brad-jones/polaris/README.md

# polaris
Modern Day 3D Printed Polaris RC Float Plane
