brad-jones/polaris/references/original-design/Polaris Parts Templates (Scaled 150 Tiled).pdf

Sand to beveled edge

V
e
r
tic

al t

ail b

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
upper piece

Rudder

Vertical tail

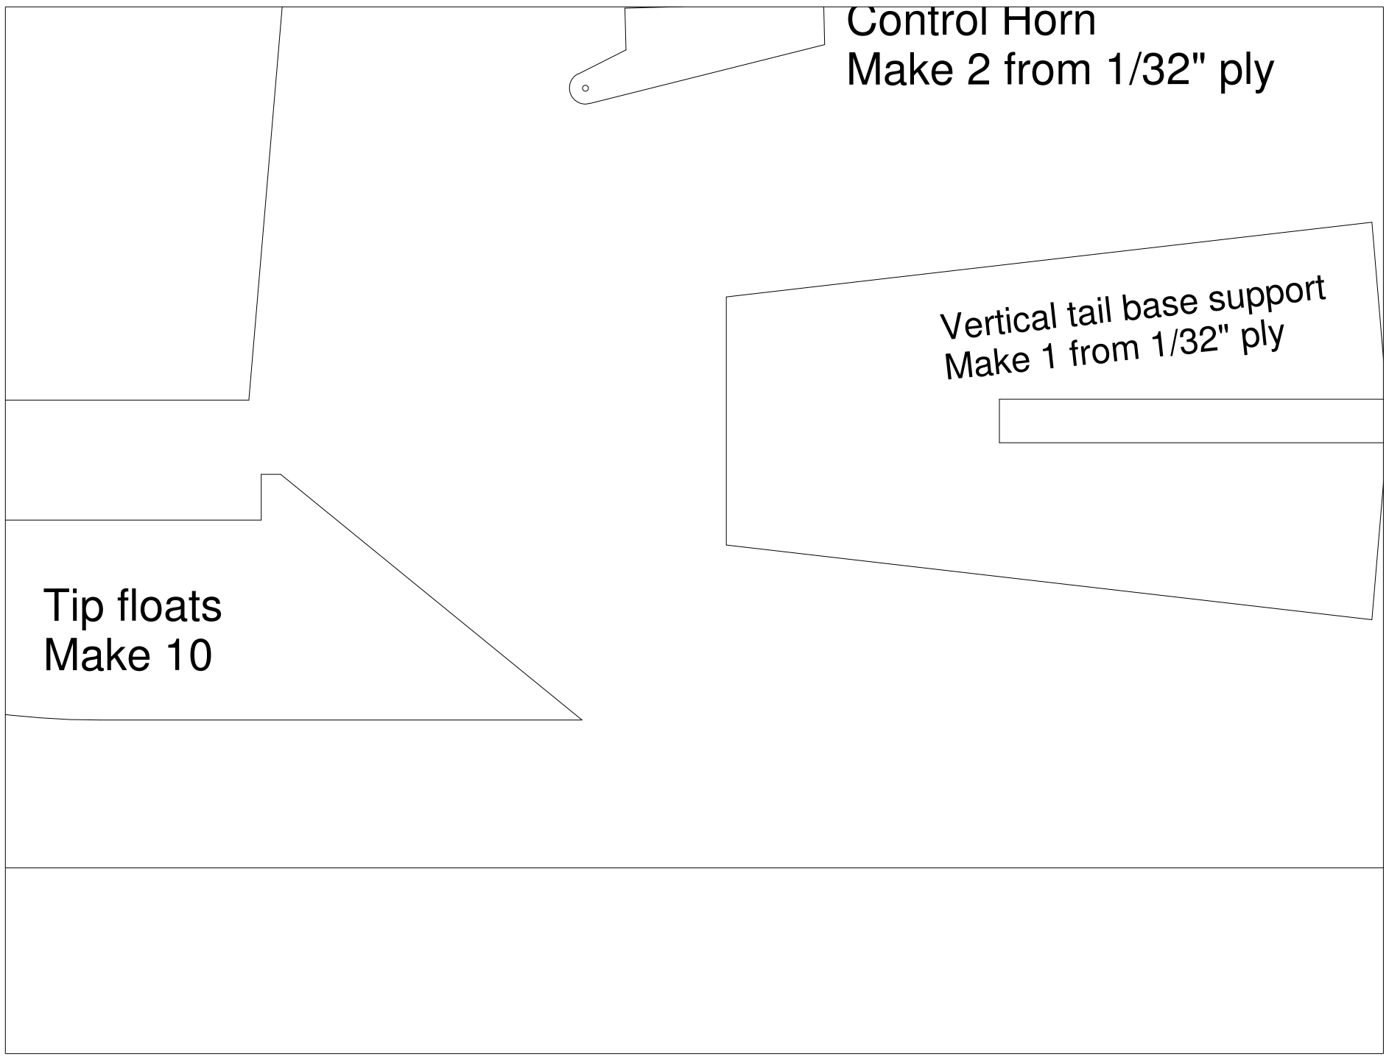
[picture p1: figure]
Control Horn Make 2 from 1/32" ply; Tip floats Make 10; Vertical tail base support Make 1 from 1/32" ply

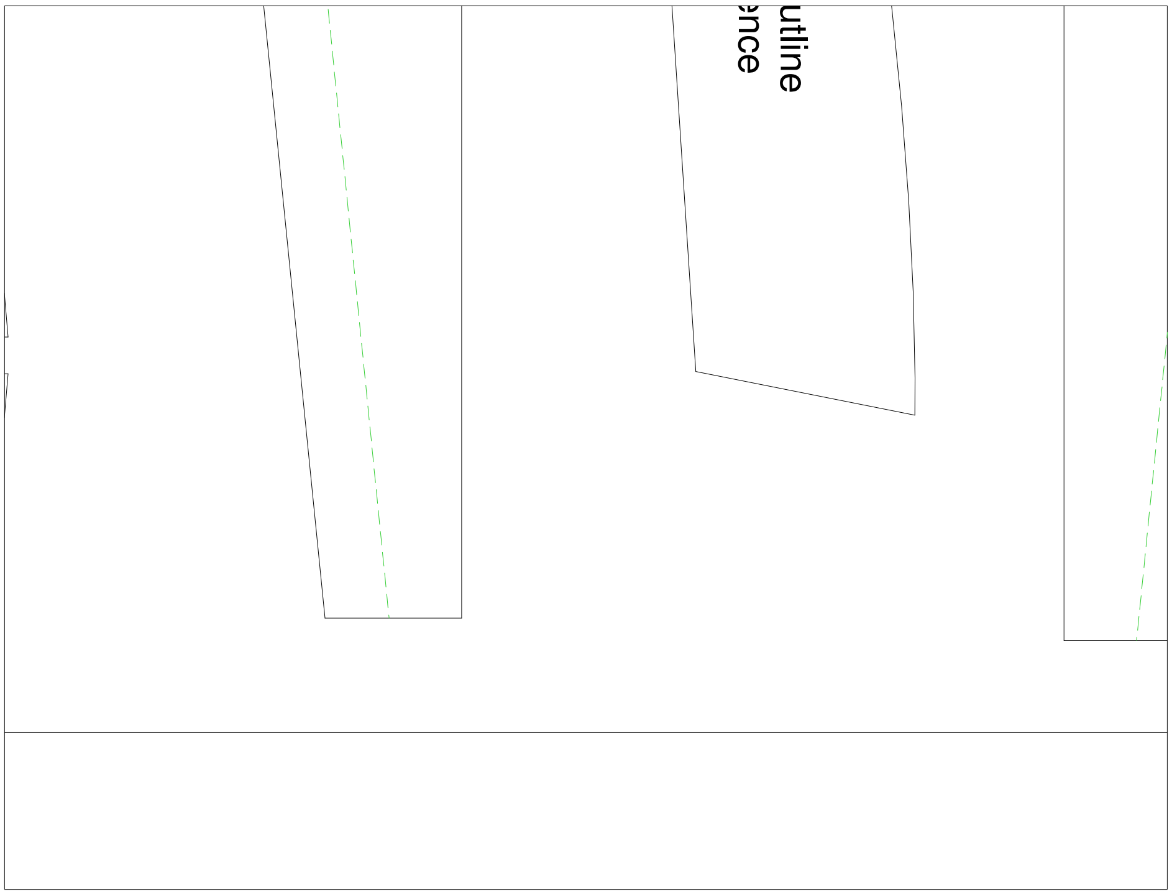
[picture p2: figure]
utline; ence

## Designed by Steve Shumate

### All parts made from 6 mm Depron or BlueCore foam unless otherwise specified

### Copyright © 2008 All Rights Reserved

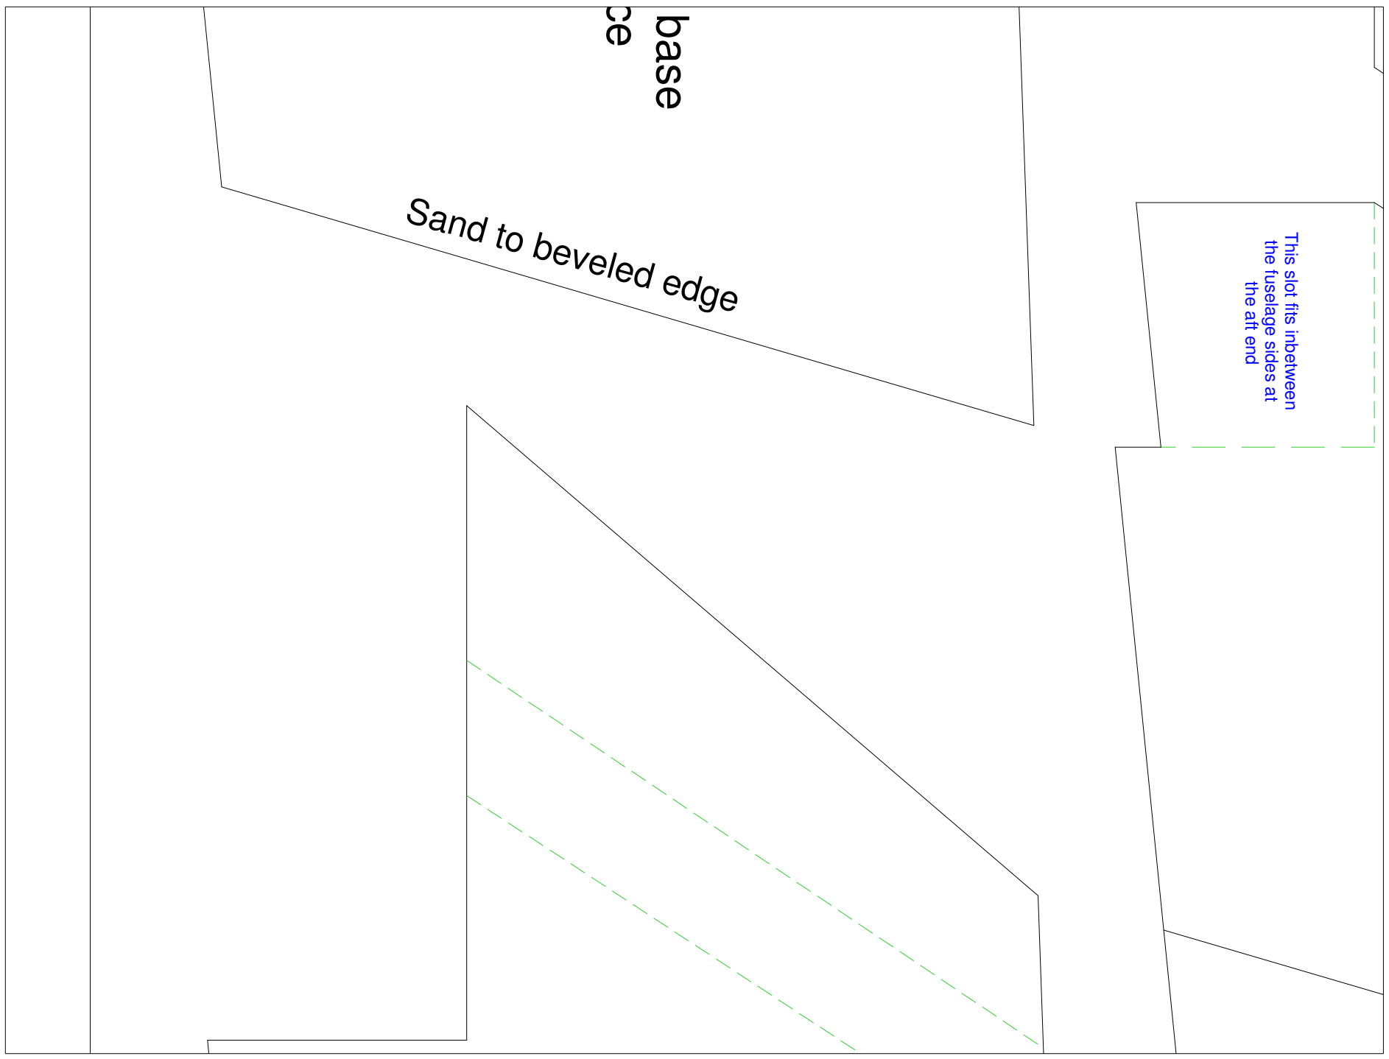
[picture p3: figure]
T his; slo; fit s in; f u s ela; sid; Sand to beveled edge

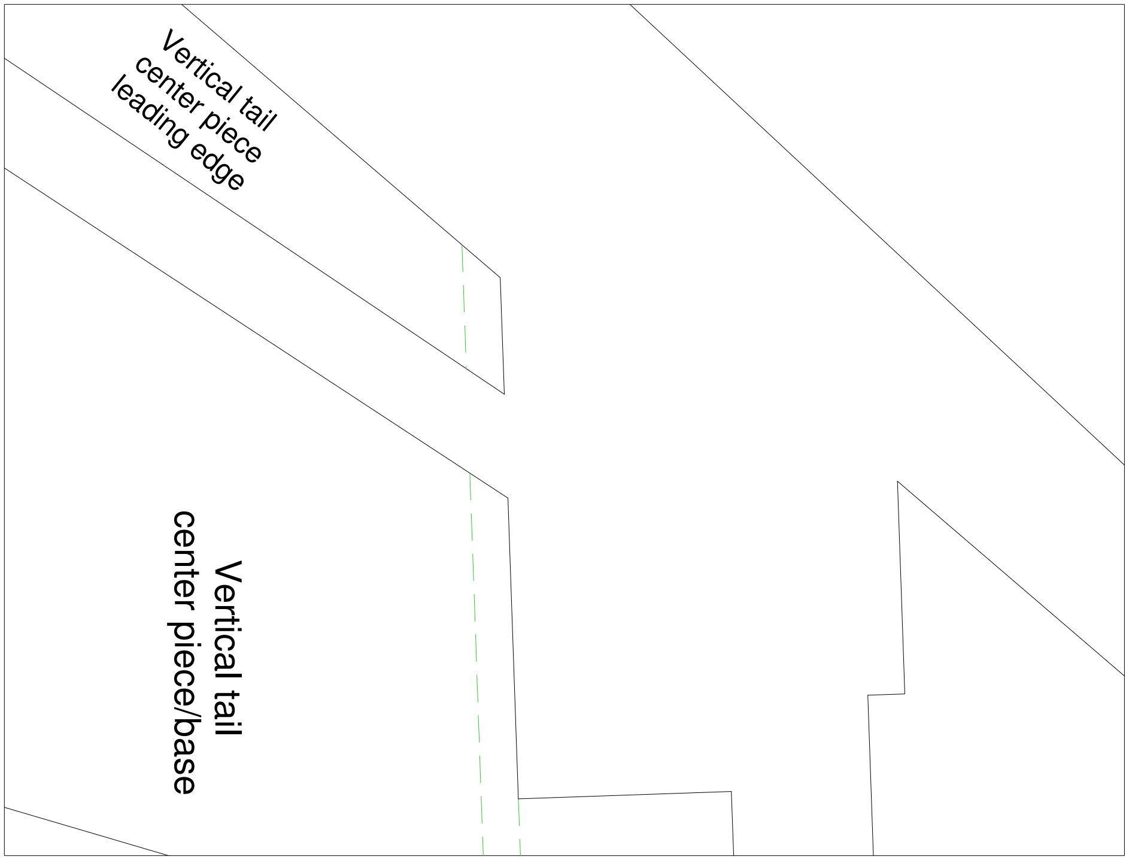
[picture p4: figure]
r tic; ail center piece/b; Vertical tail center piece leading edge
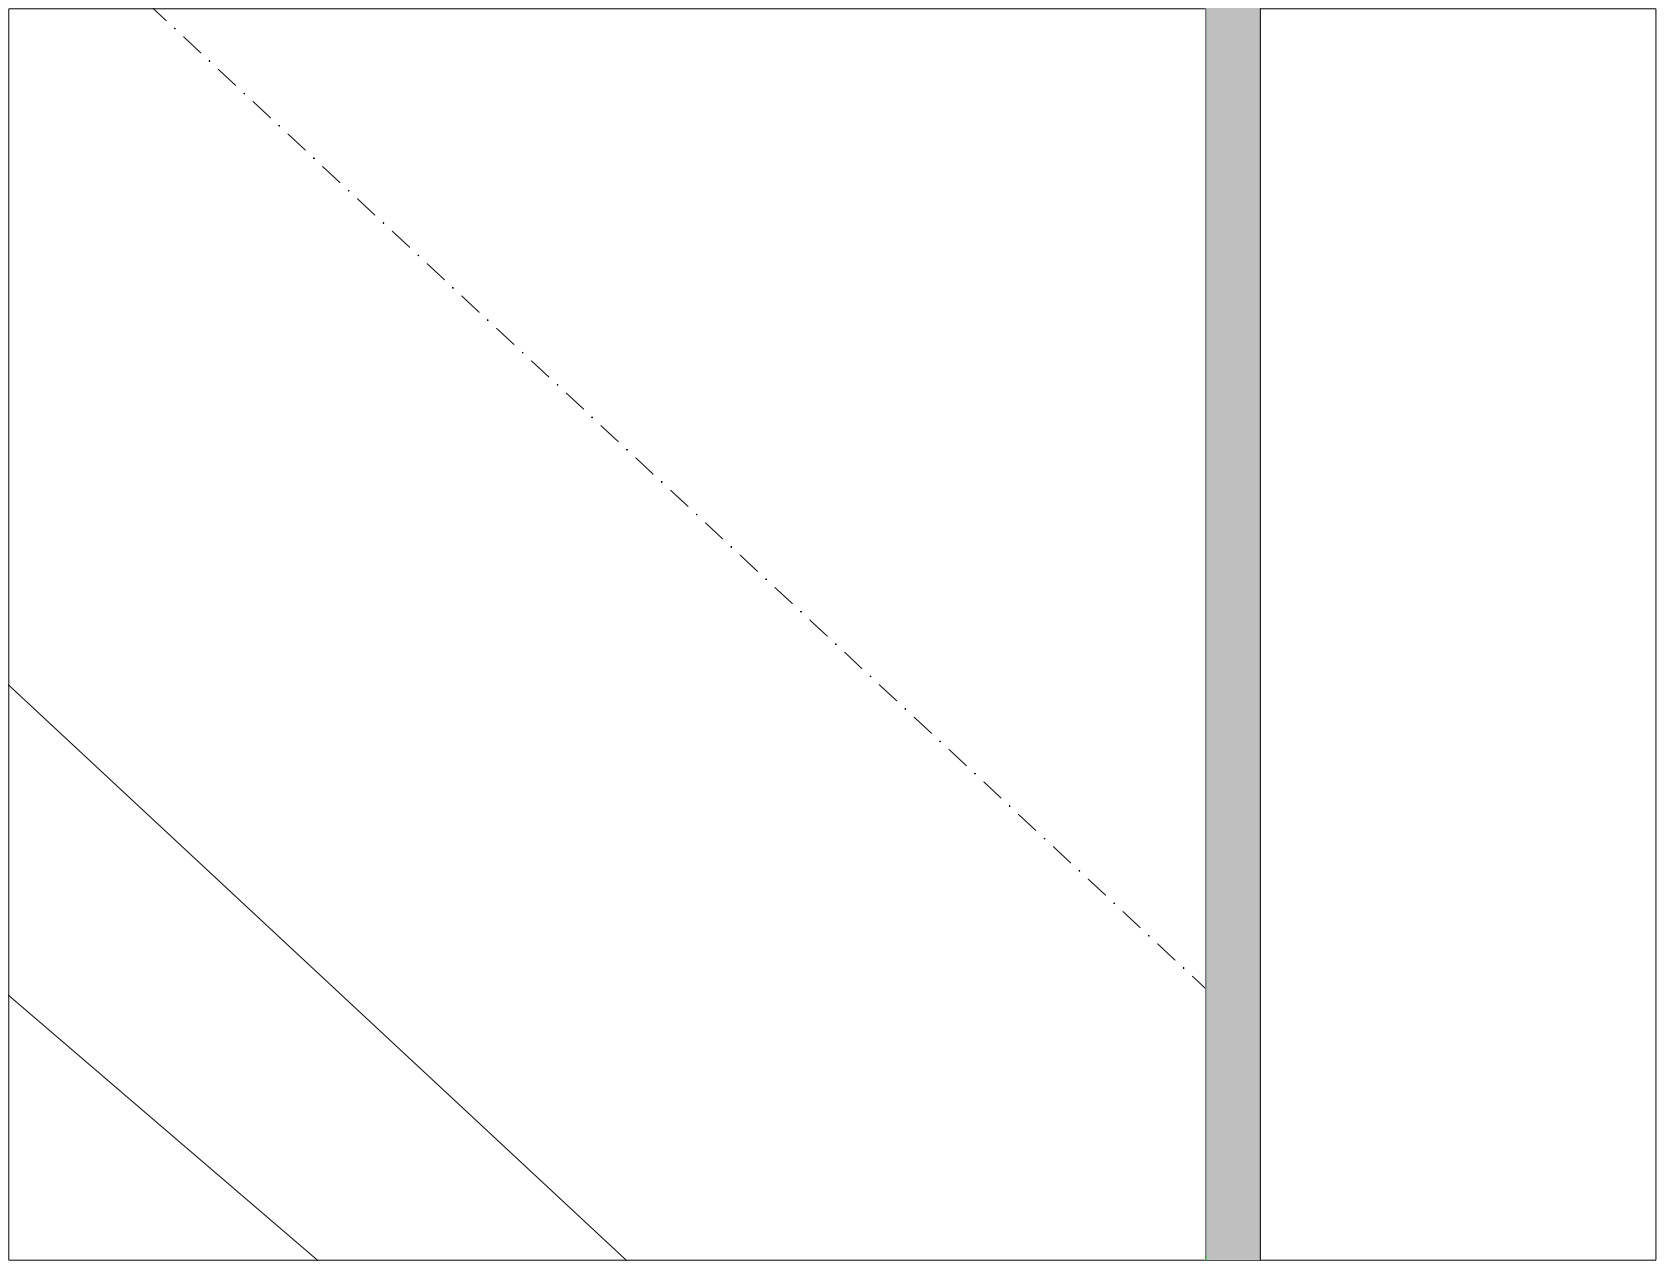
[picture p5: page 9]

Sand to beveled edge

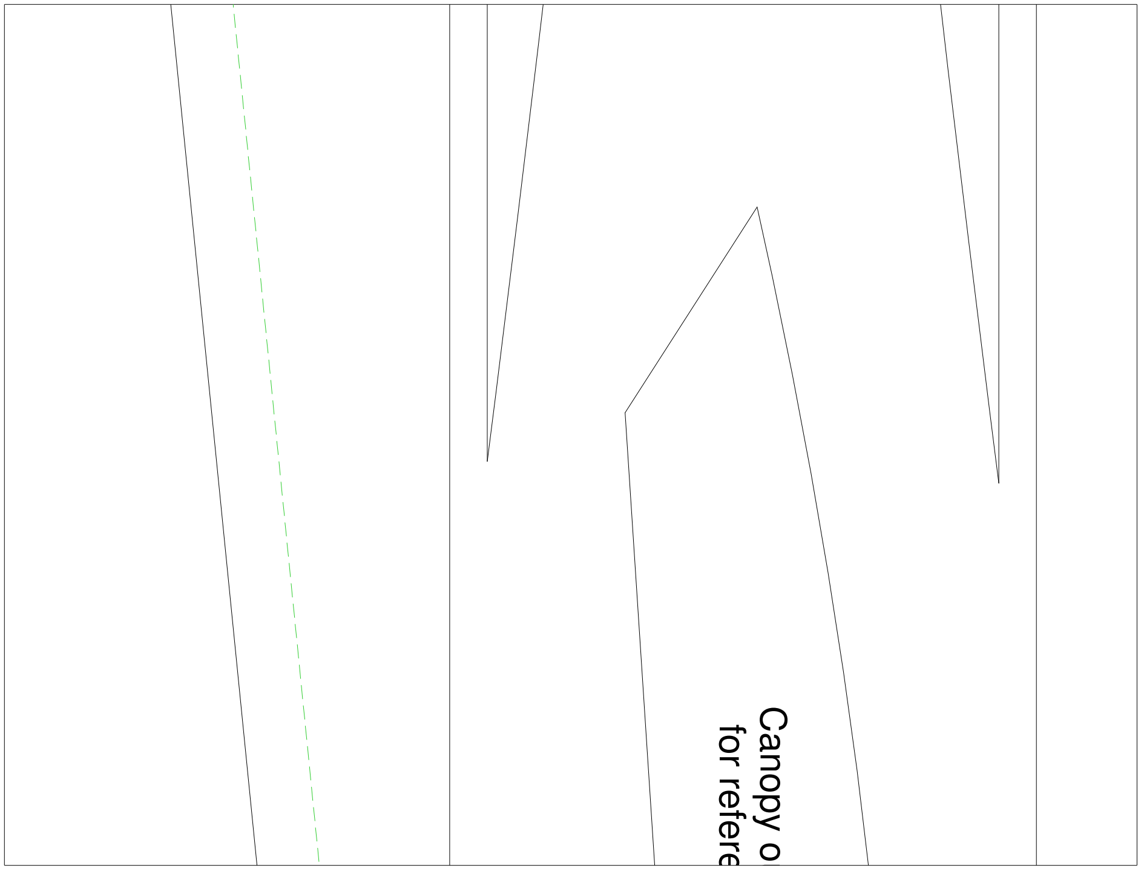
[picture p6: figure]
Canopy o for refere

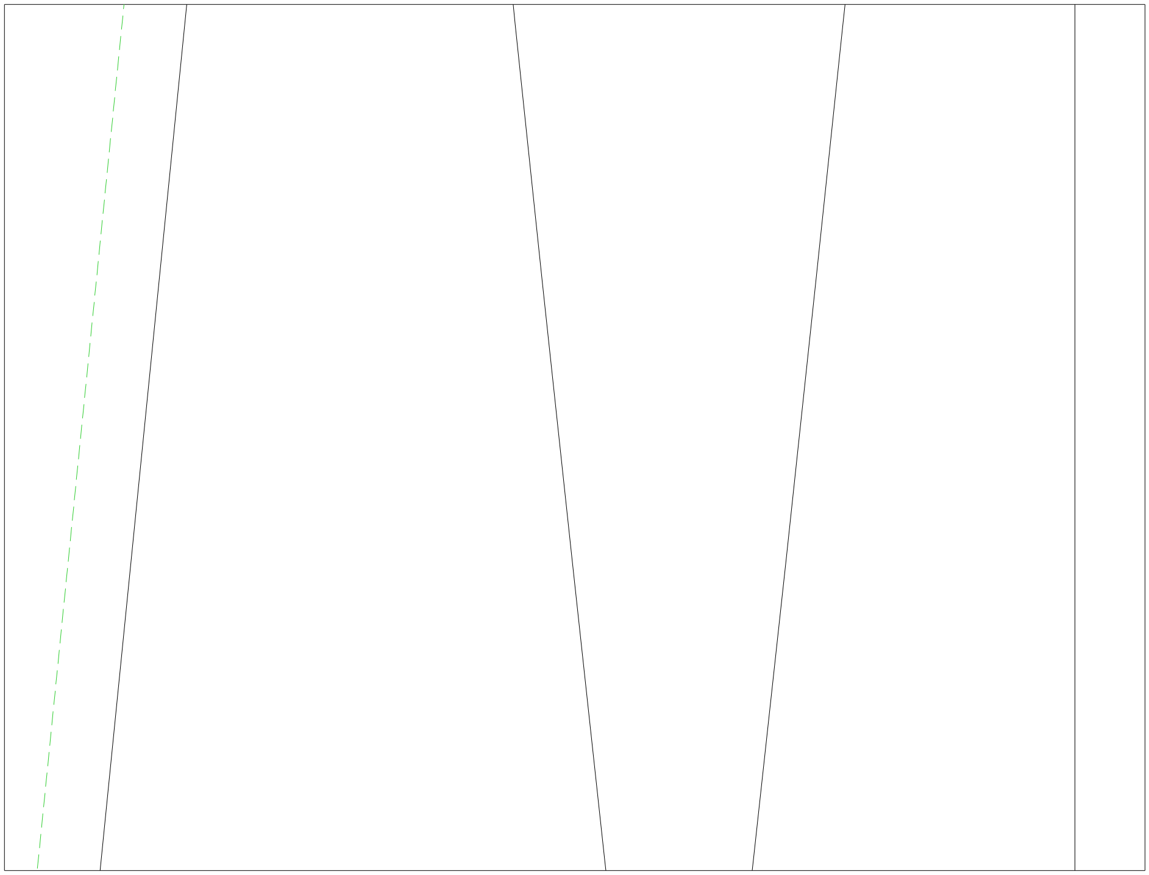
[picture p7: figure]

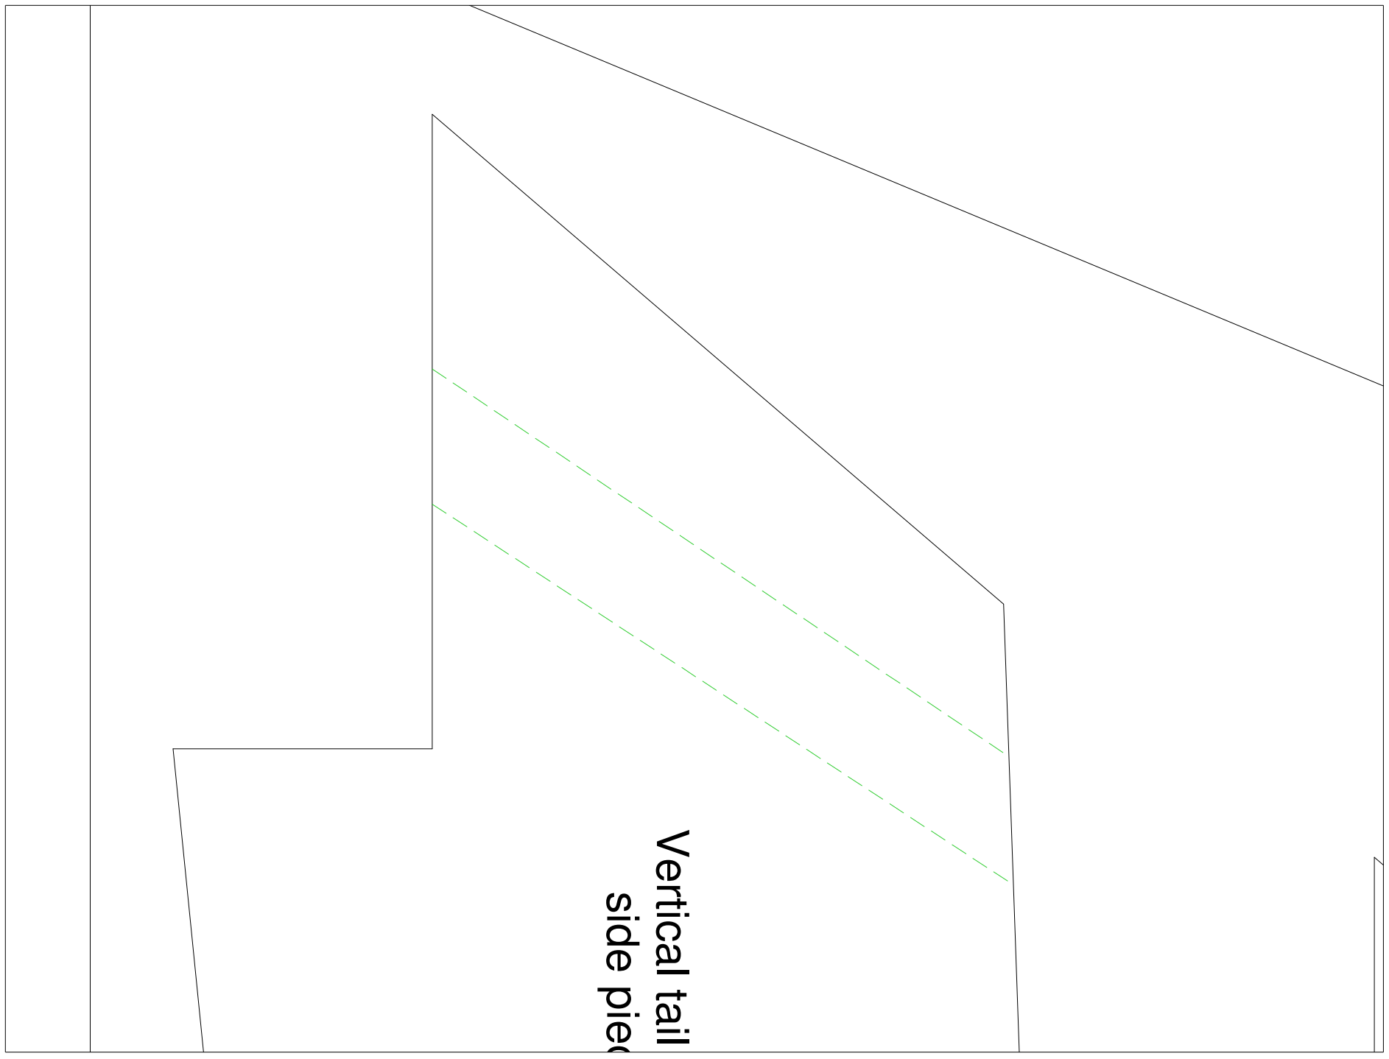
[picture p8: figure]
Vertical tail side piec

2

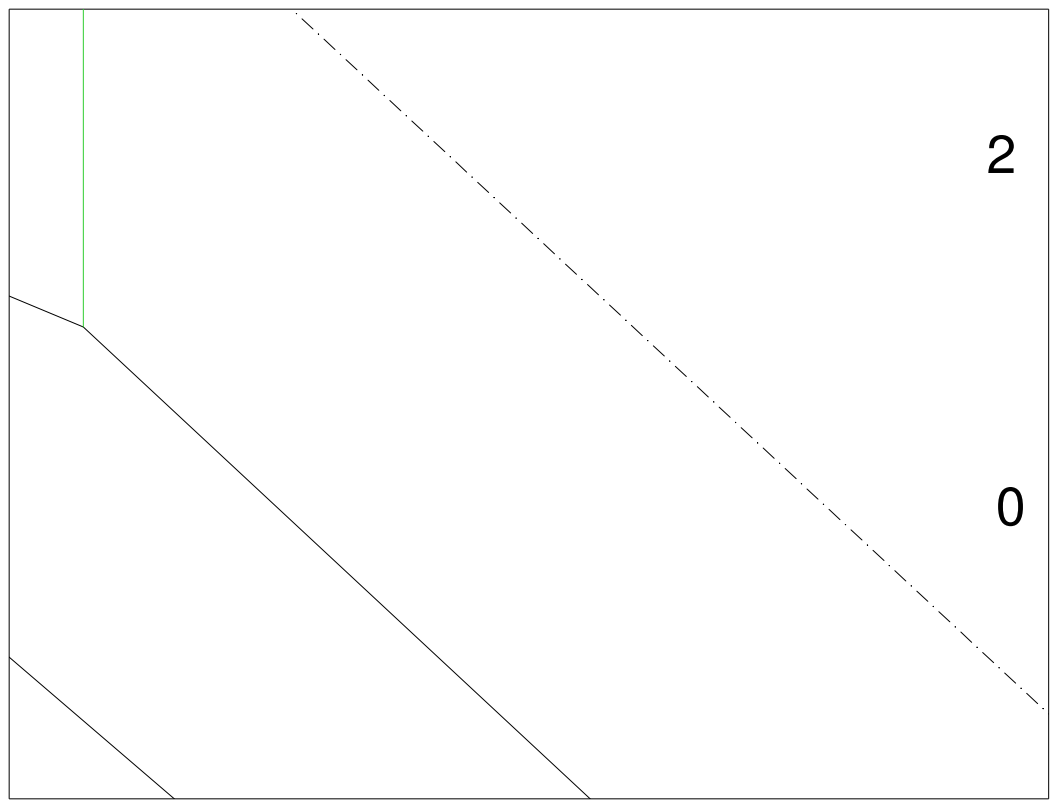
[picture p9: page 14]

## Scale in inches

2 | 4

Aileron

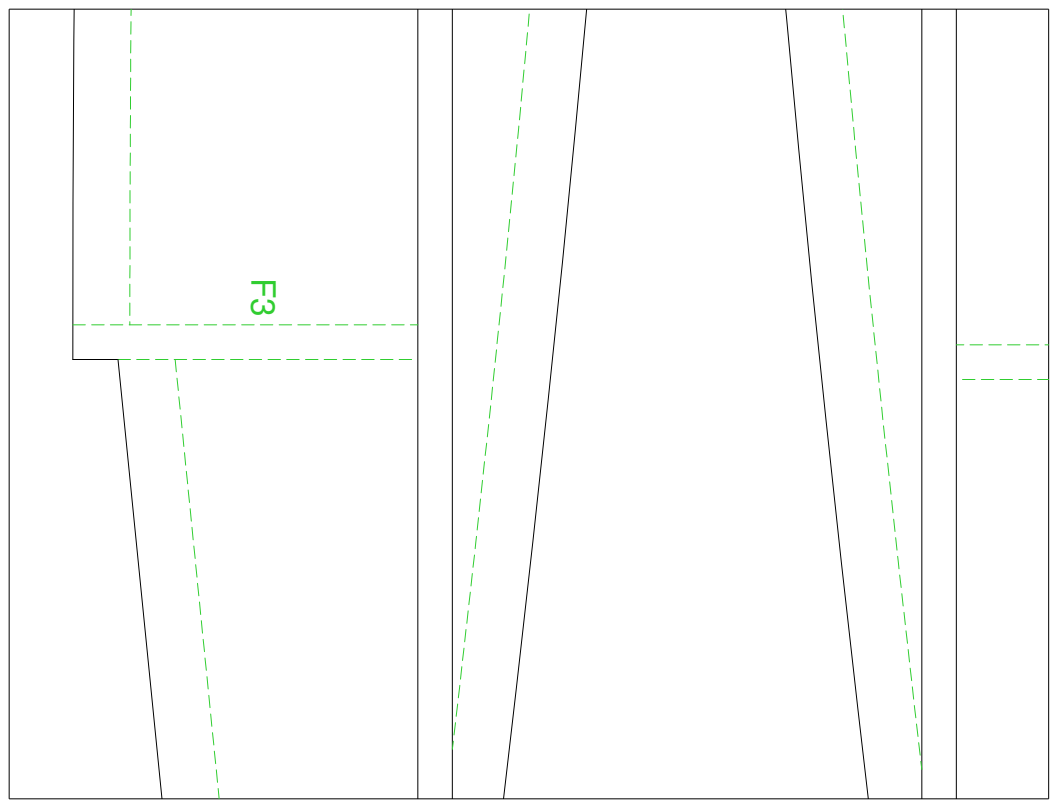
[picture p10: page 17]

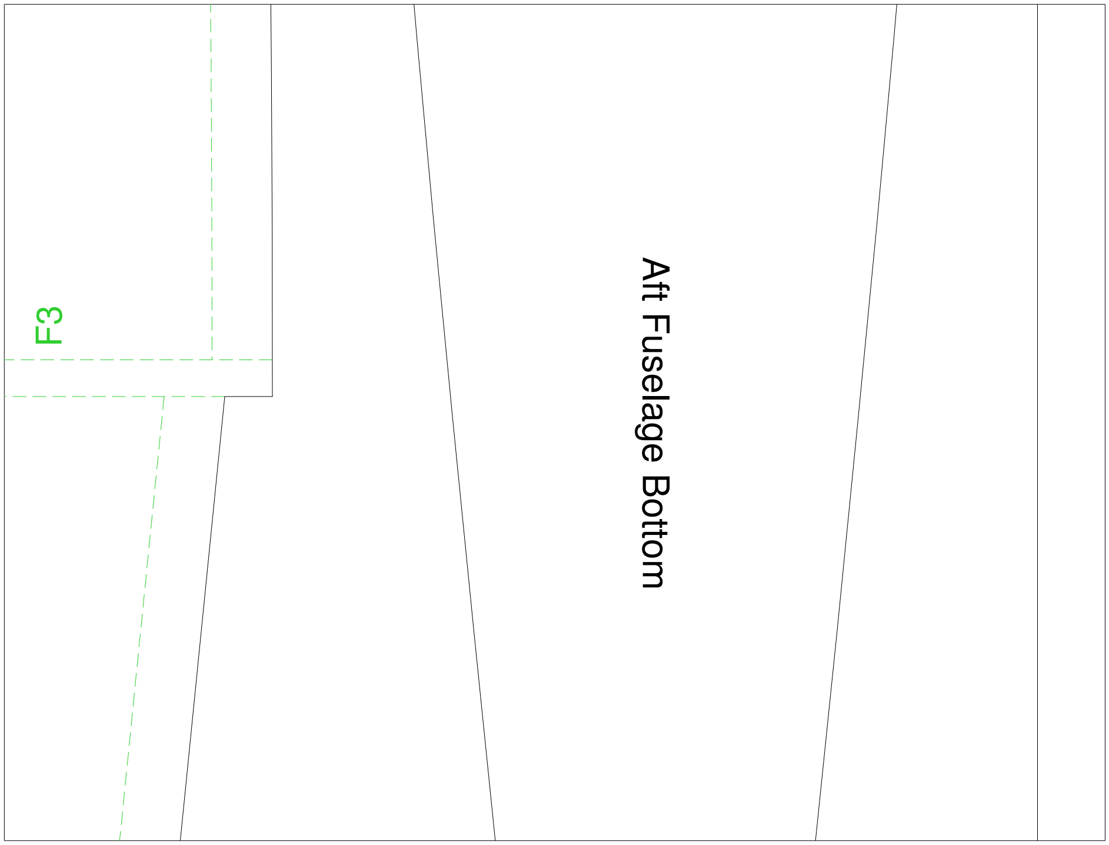
[picture p11: figure]
Aft Fuselage Bottom

O

p

tio

n

al s

plic
u

sin

g le

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
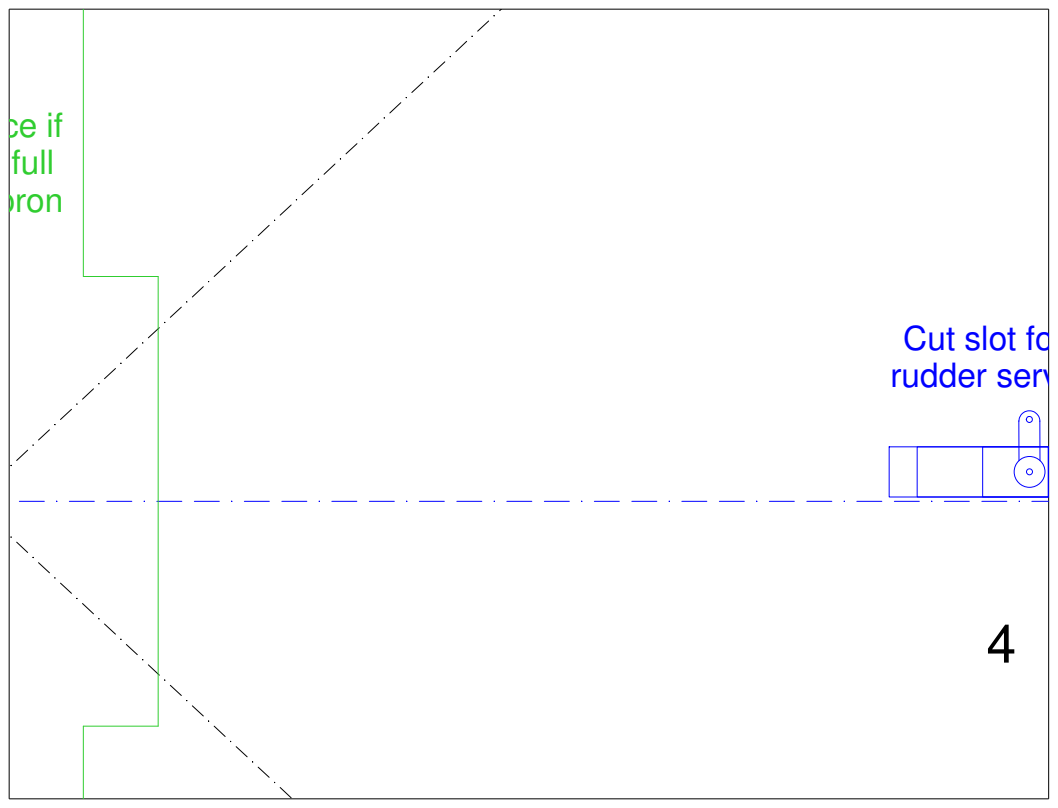
[picture p12: page 20]
lice if n full pron

Cut slot fo
rudder serv

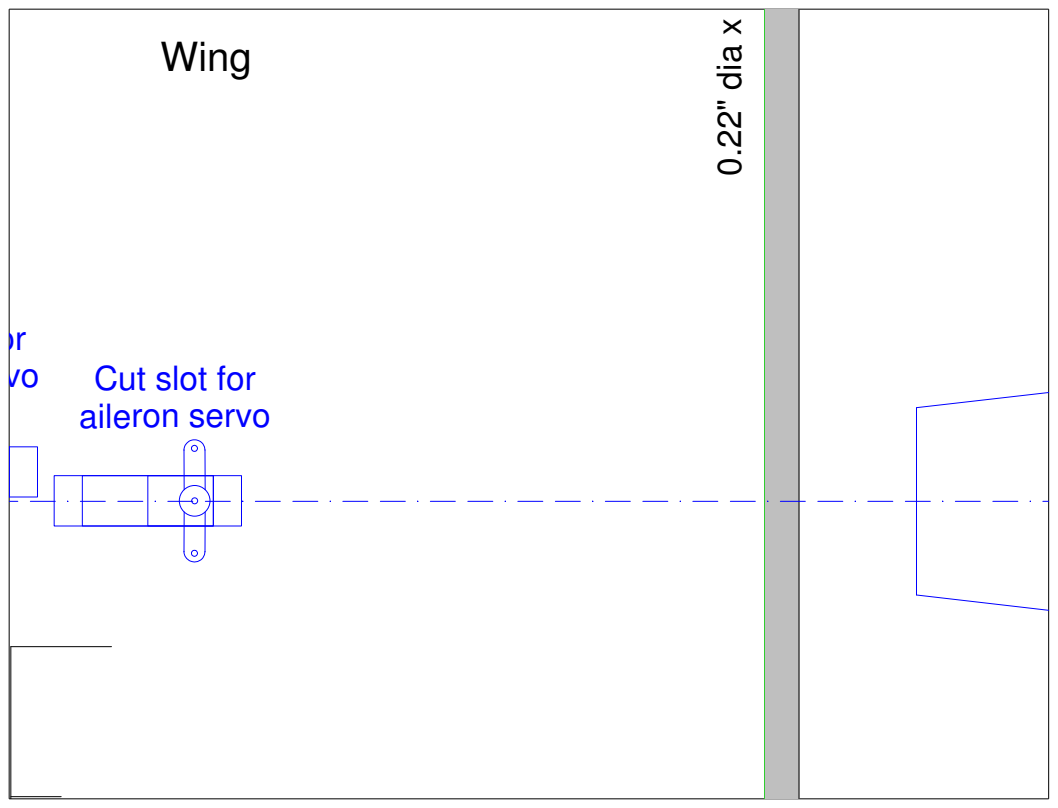
[picture p13: page 21]
0.22" dia x; slo; aile; Win

Fuselage Top

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
al t

ail b
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
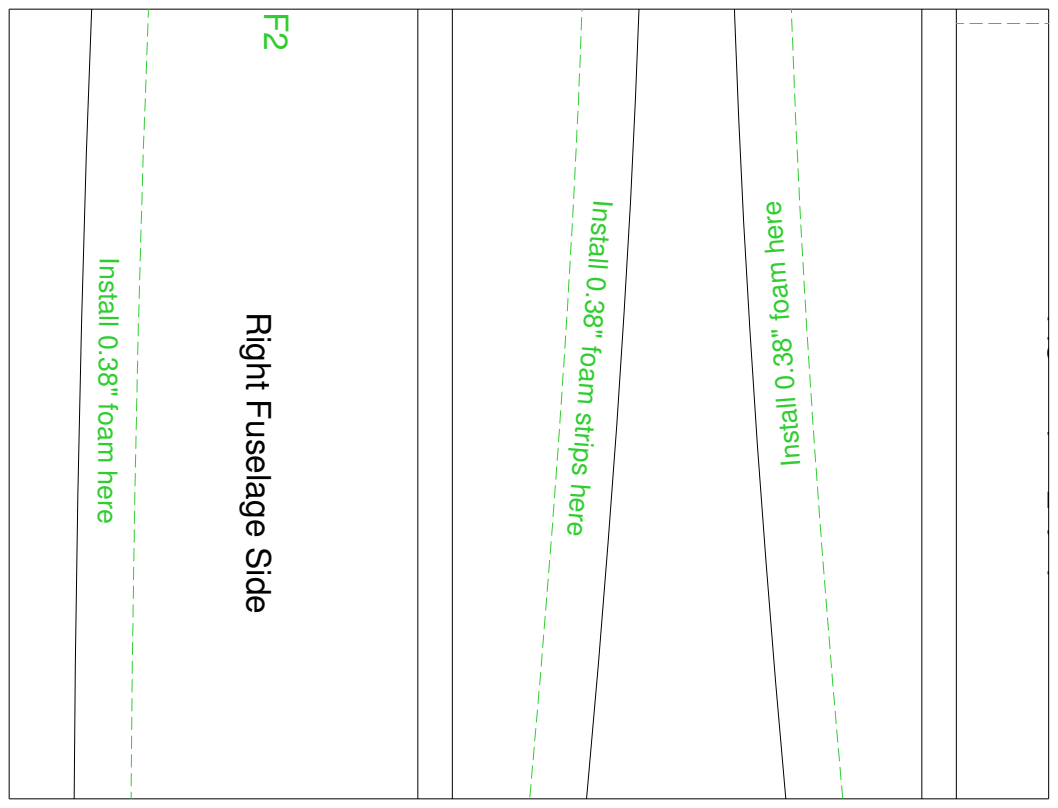
[picture p14: page 23]

Install 0.38" of am str pi s here

Install 0 3. 8" of am here

Ins at ll 0.38" foam here

Left Fuselage Sid

ight Fuselage Side

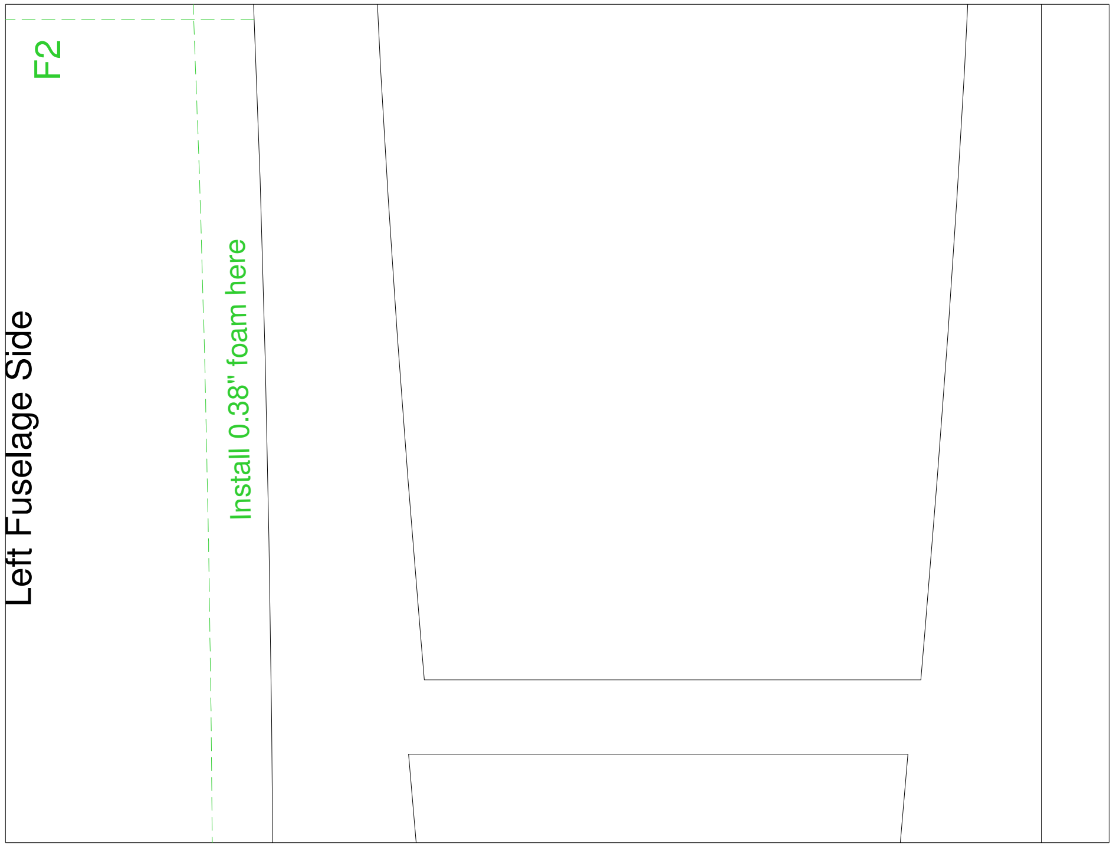
[picture p15: figure]
Left Fuselage Side; nI stall 0 3. 8" of am here

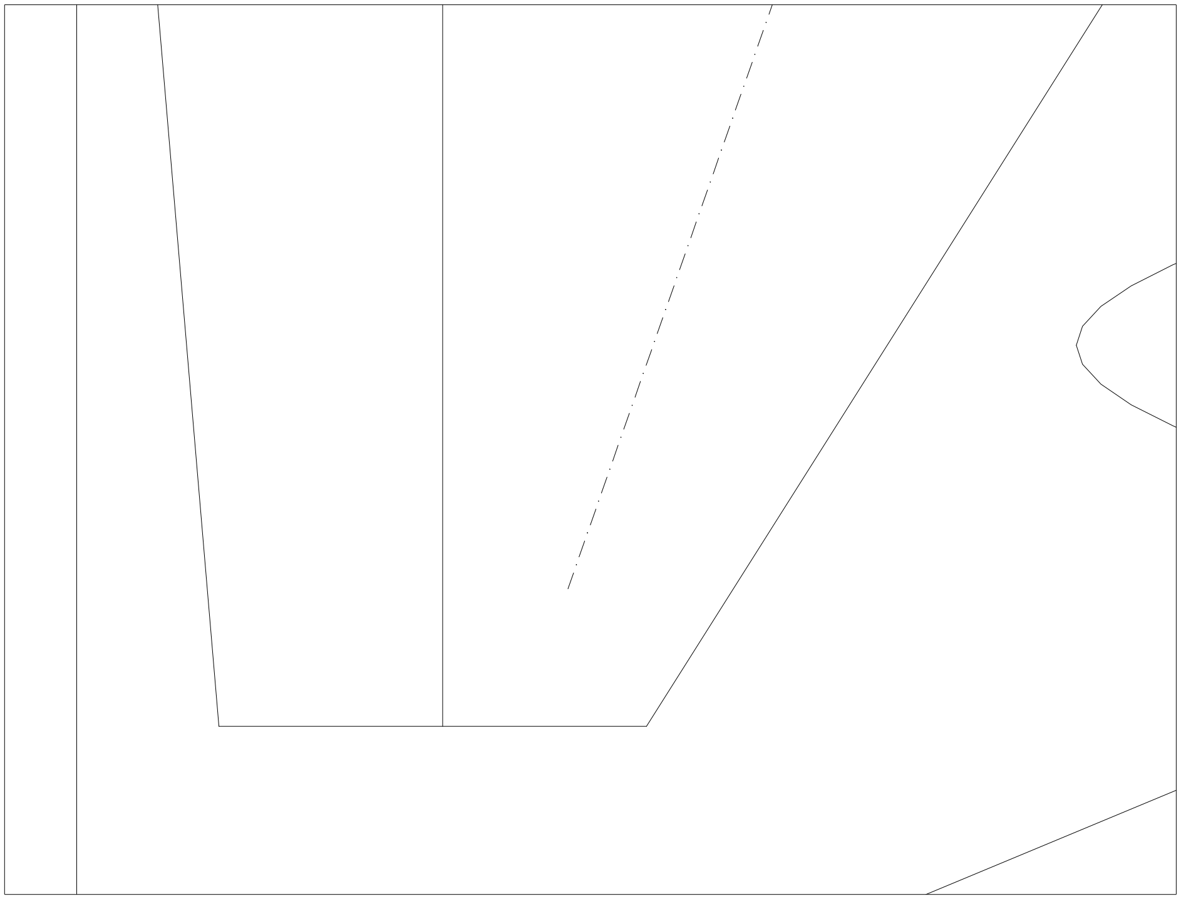
[picture p16: figure]
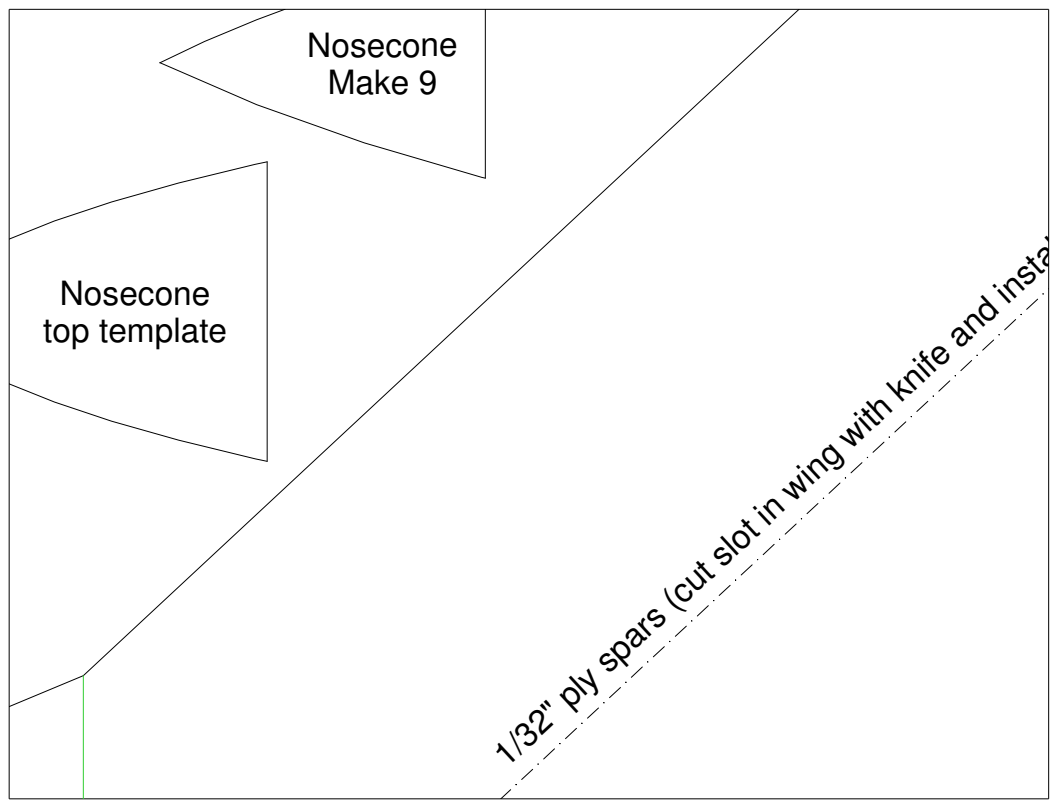
[picture p17: page 26]
Nosecone Make 9

1/32" ply spars (cut slot in wing with knife and install Nosecone top template

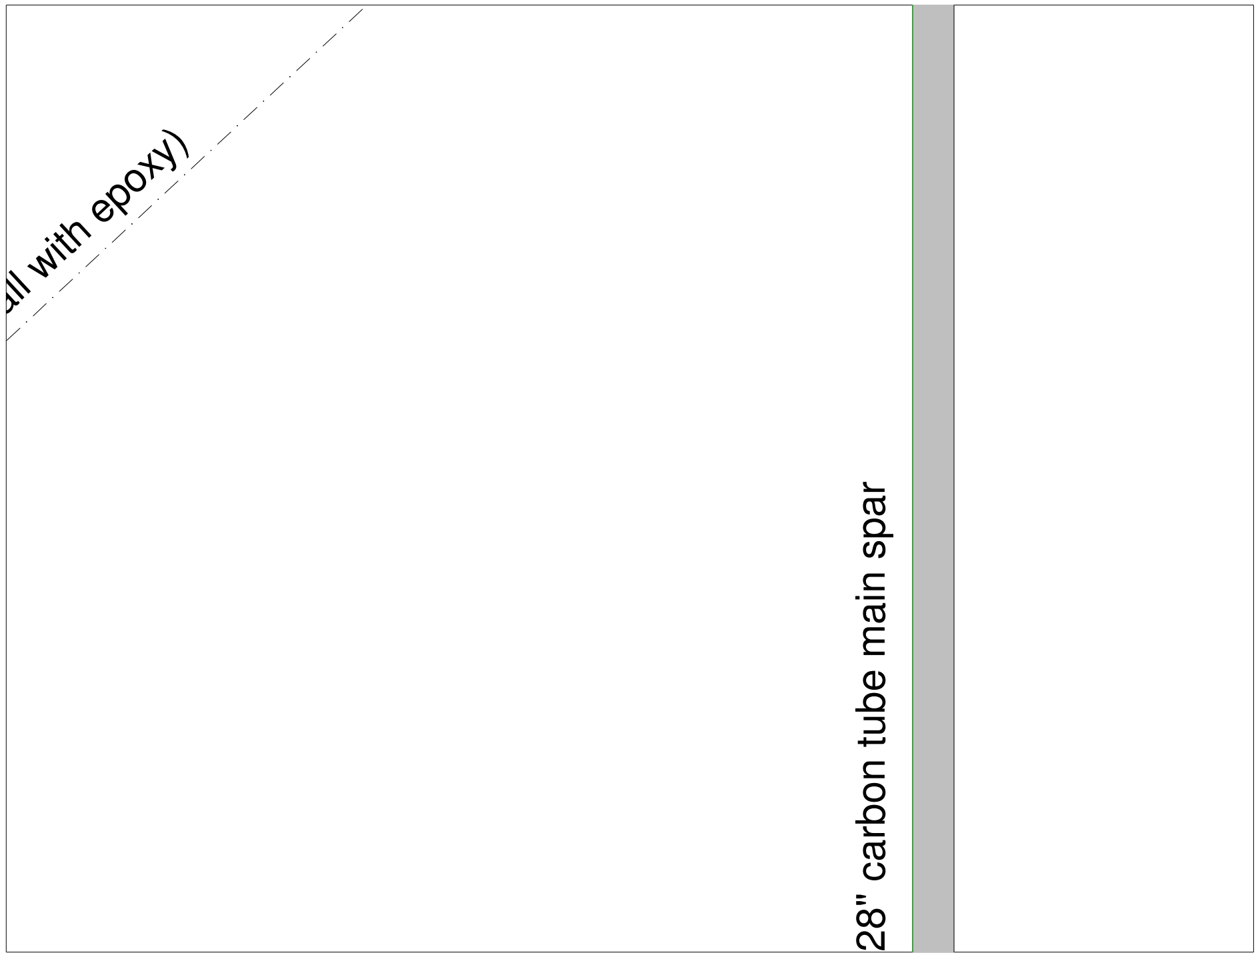
[picture p18: figure]
install with epoxy); 28" carbon tube main spar

Aileron

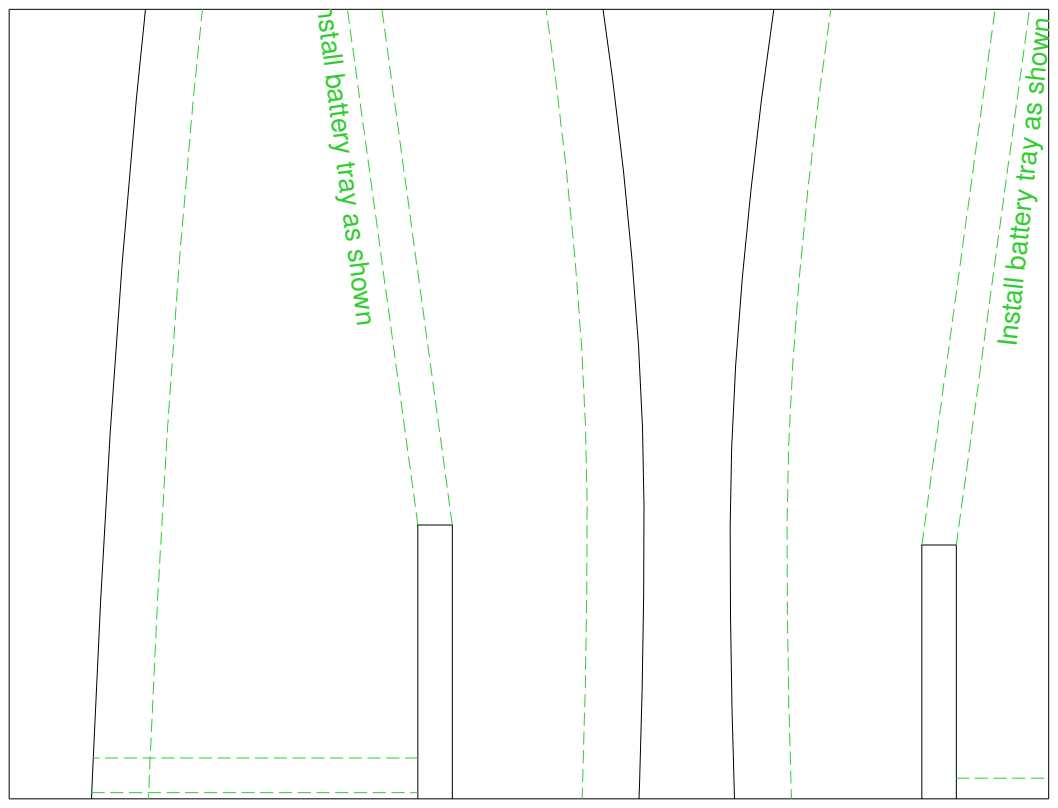
[picture p19: page 29]

nstall battery tray as shown

Install battery tray as shown

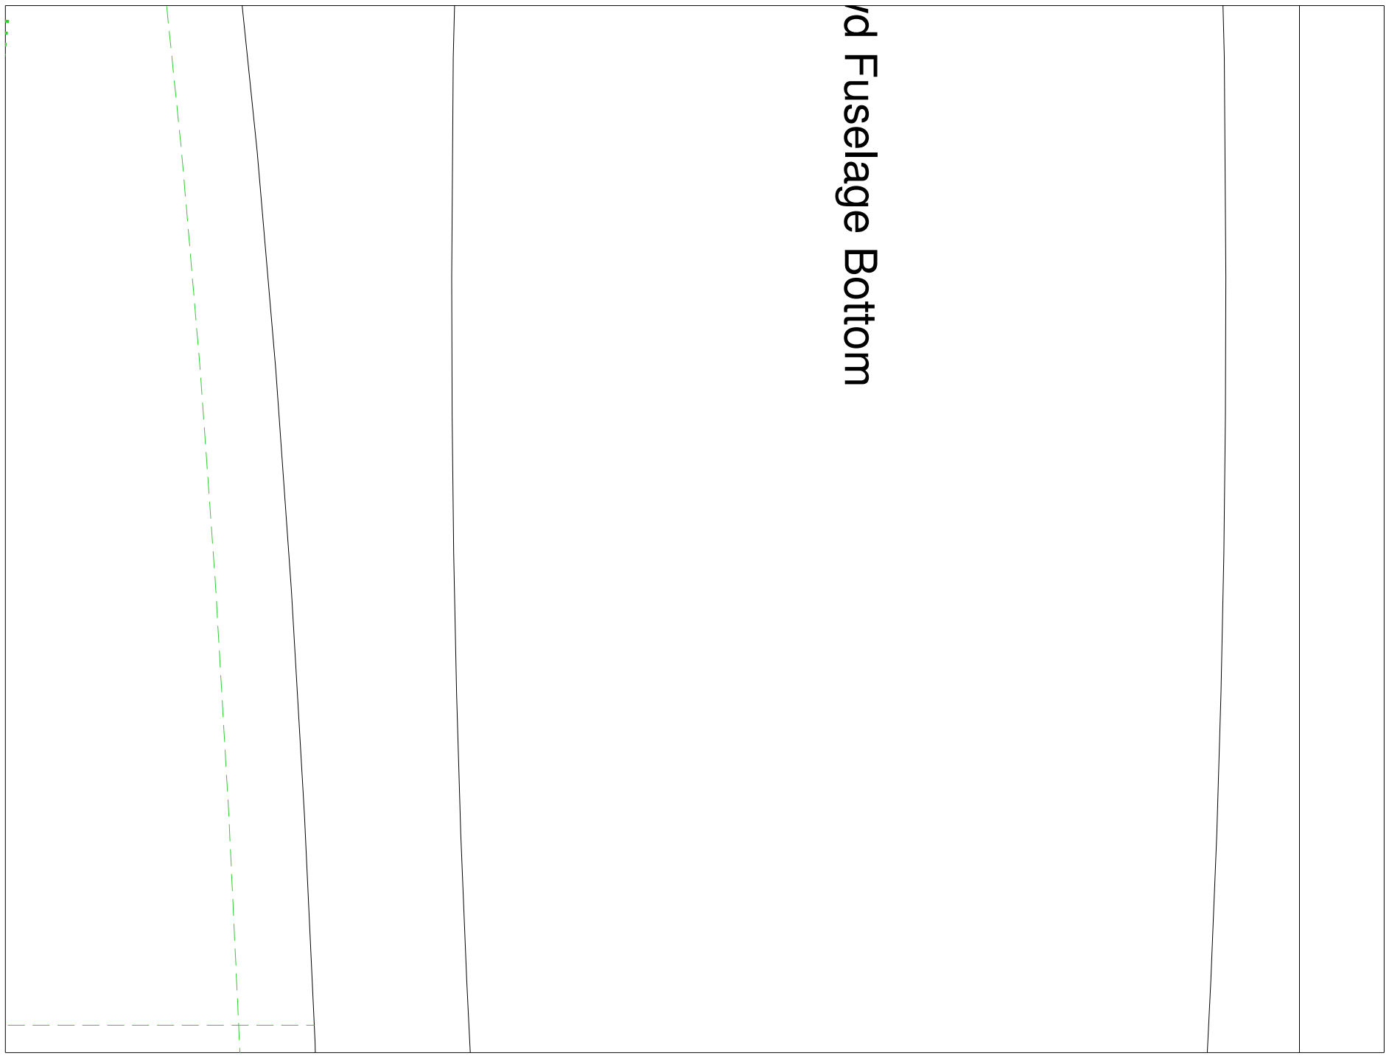
[picture p20: figure]
d Fuselage Bottom
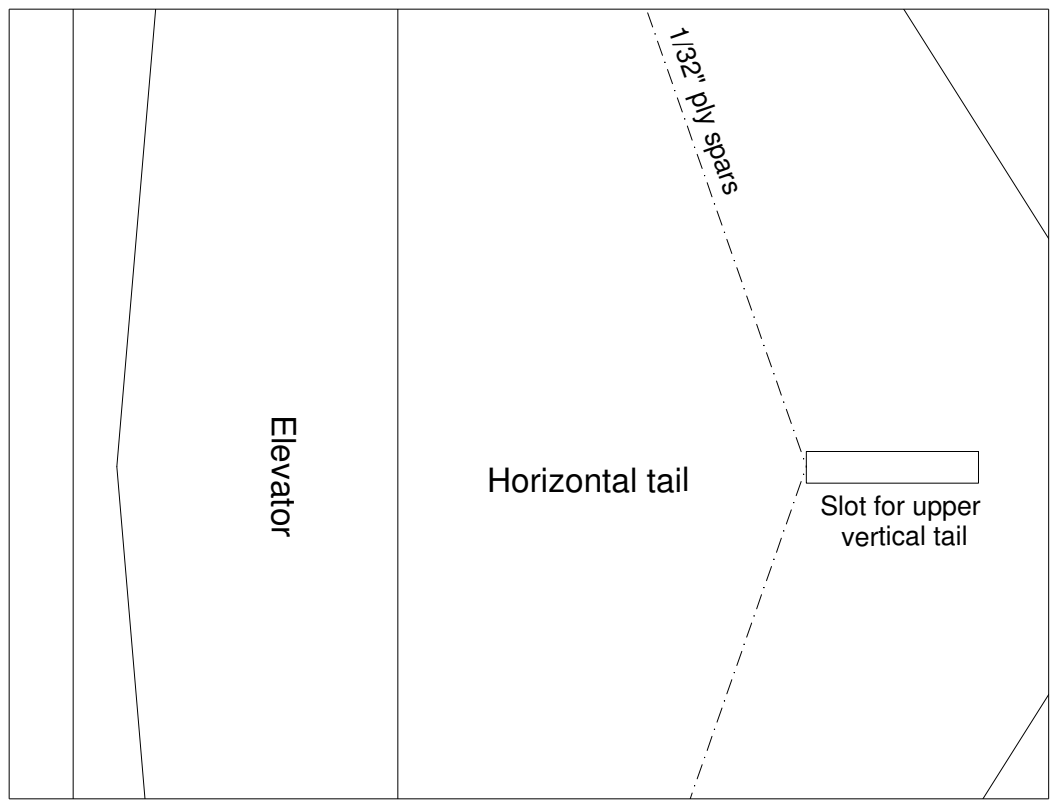
[picture p21: page 31]
riz; ail; Slo; tic; 1/32" ply spars; Elevator

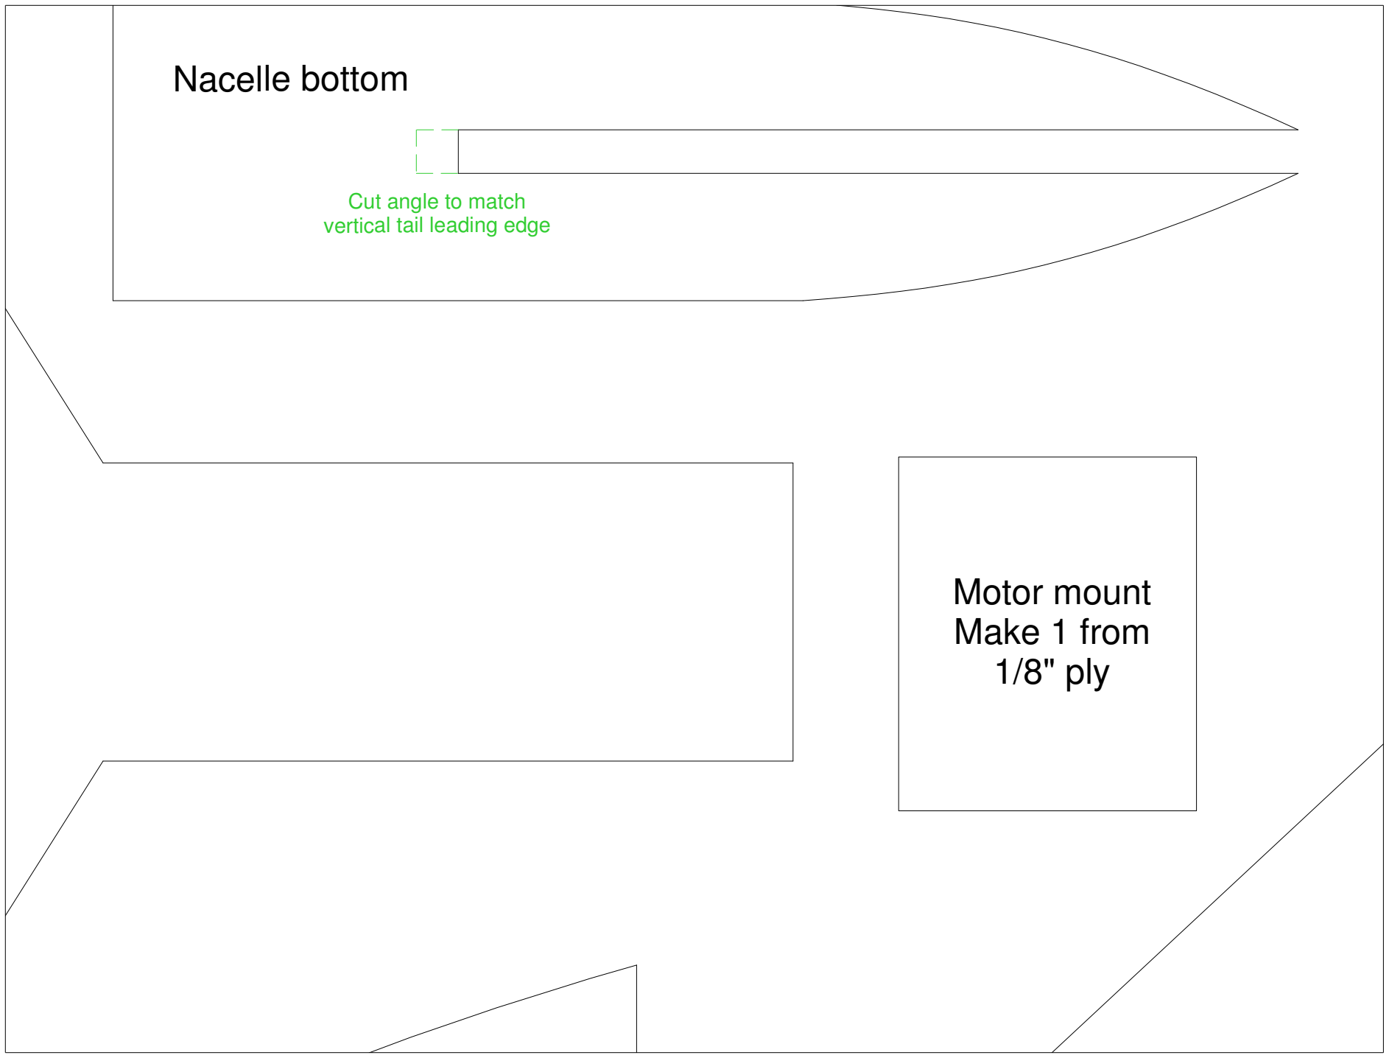
[picture p22: figure]
Motor mount Make 1 from 1/8" ply; Nacelle bottom; Cut angle to match vertical tail leading edge

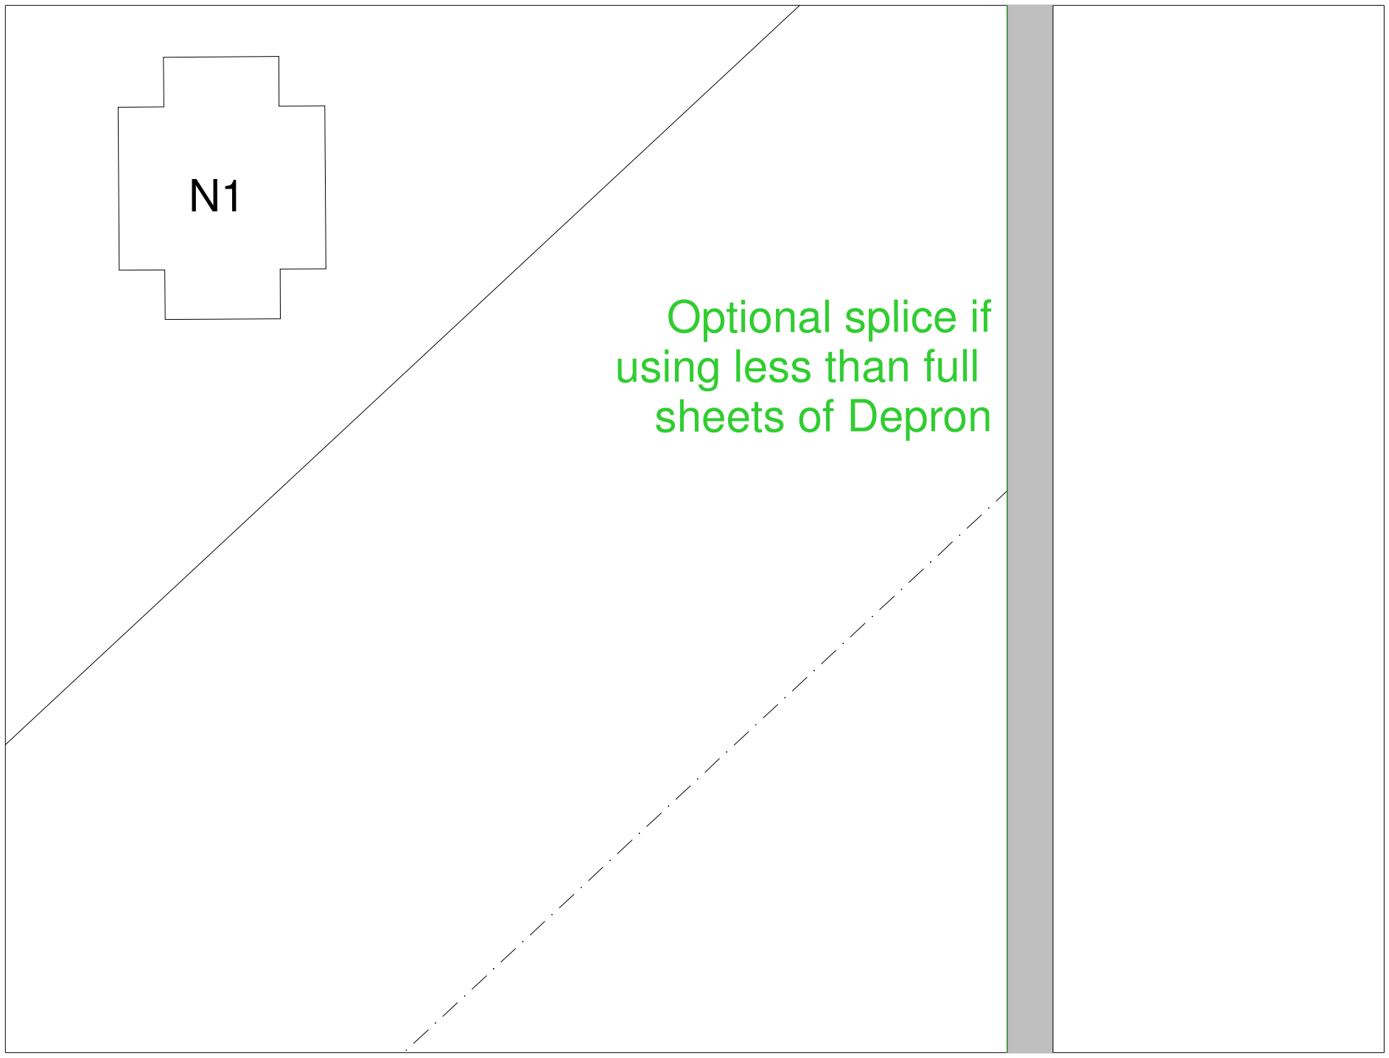
[picture p23: figure]
tio; plic; sin; ull s h

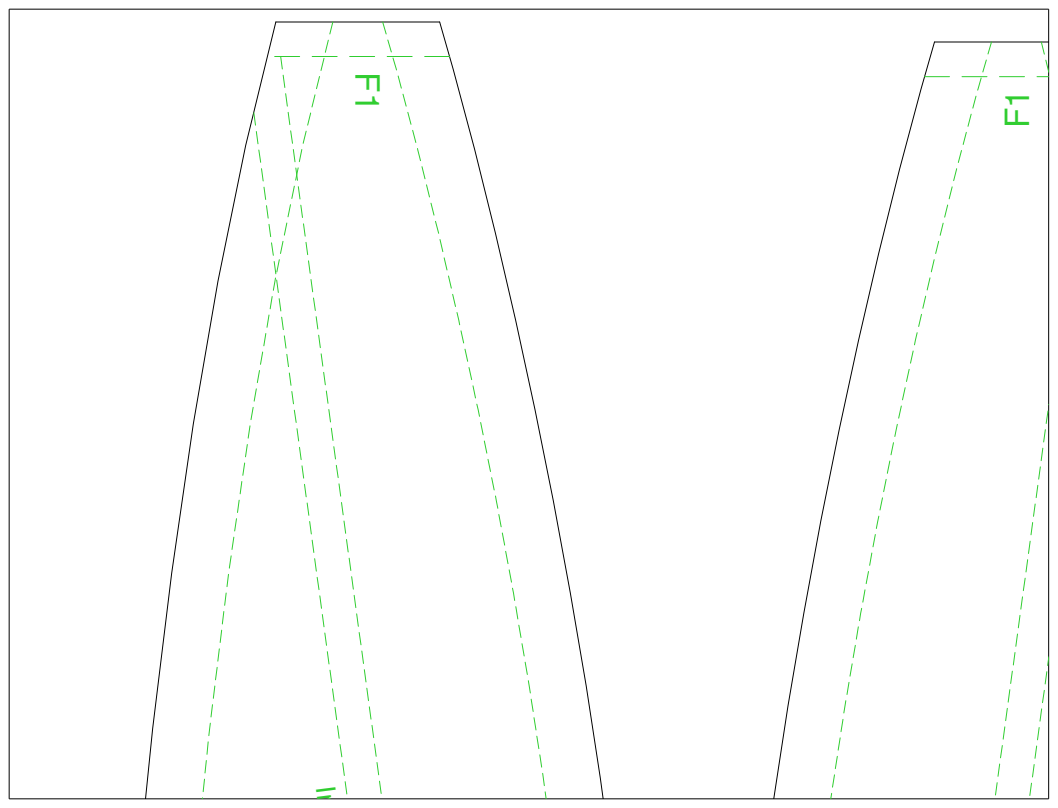
[picture p24: page 35]

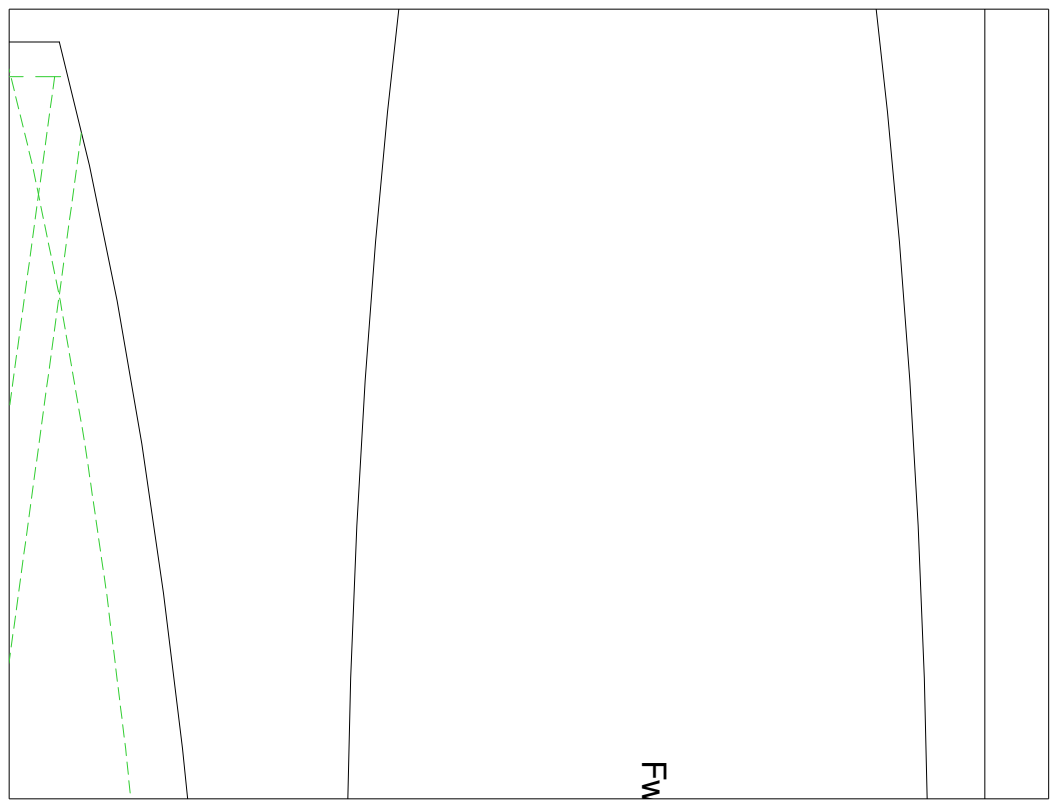
[picture p25: page 36]

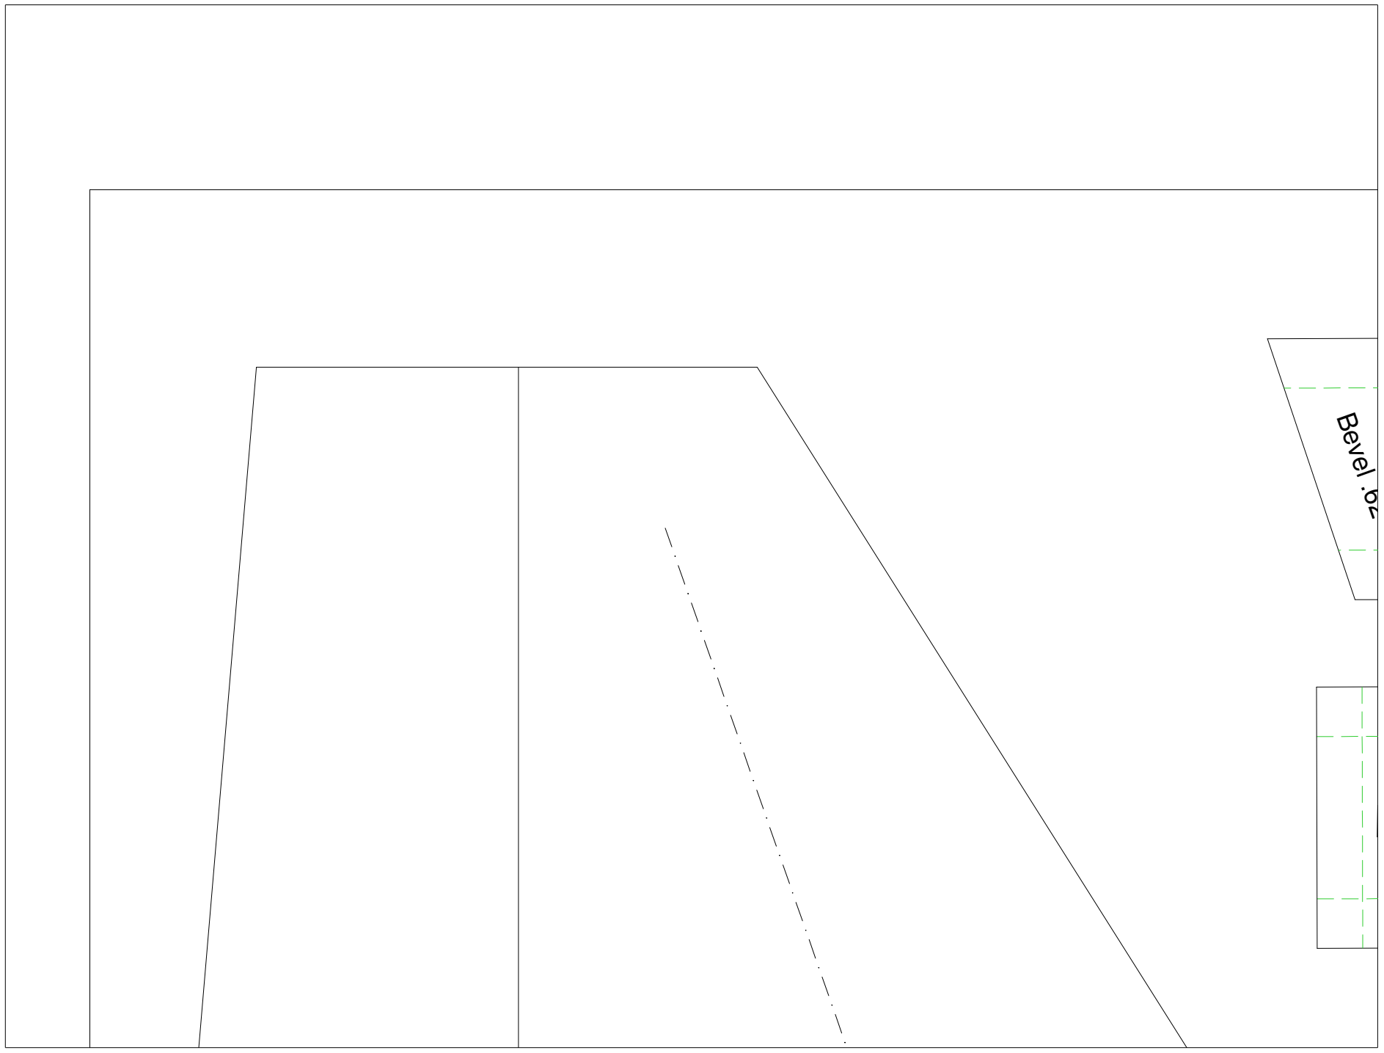
[picture p26: figure]
Bevel .62"
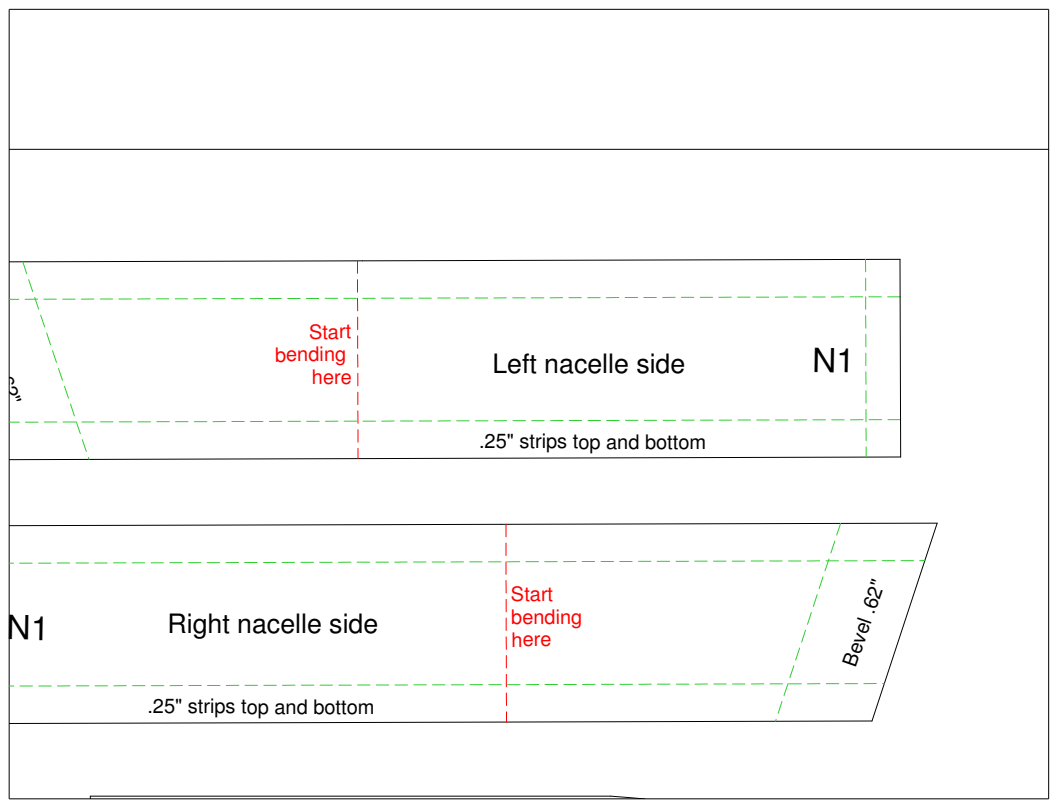
[picture p27: page 38]
Start bending here; Bevel; Left nacelle side

.25" strips top and bottom

N1 Right nacelle side

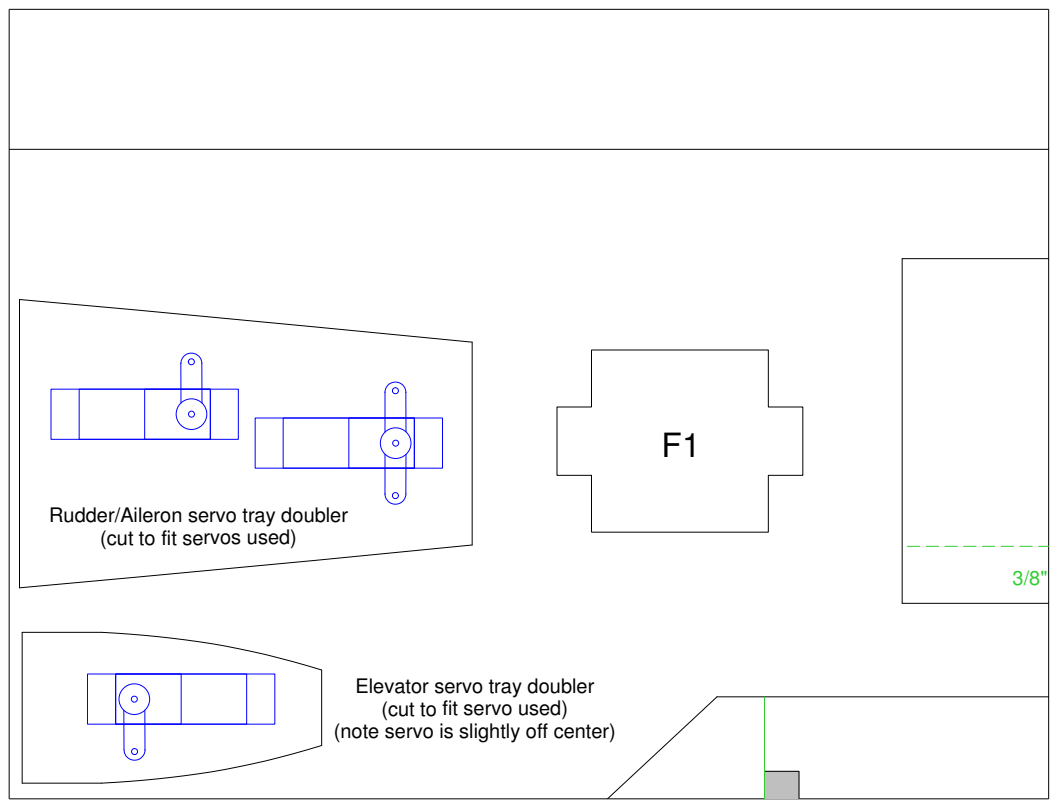
[picture p28: page 39]

Rudder/Aileron servo tray doubler
(cut to fit servos used)

Elevator servo tray doubler
(cut to fit servo used)
(note servo is slightly off center)

F2 F3

3/8" strip on aft side

Motor Battery Tray
