brad-jones/polaris/(list of files, cad)

Other CAD files:
polaris.FCStd
