brad-jones/polaris/references/original-design/Polaris - Revised Nacelle Parts.pdf

Left nacelle side | N1

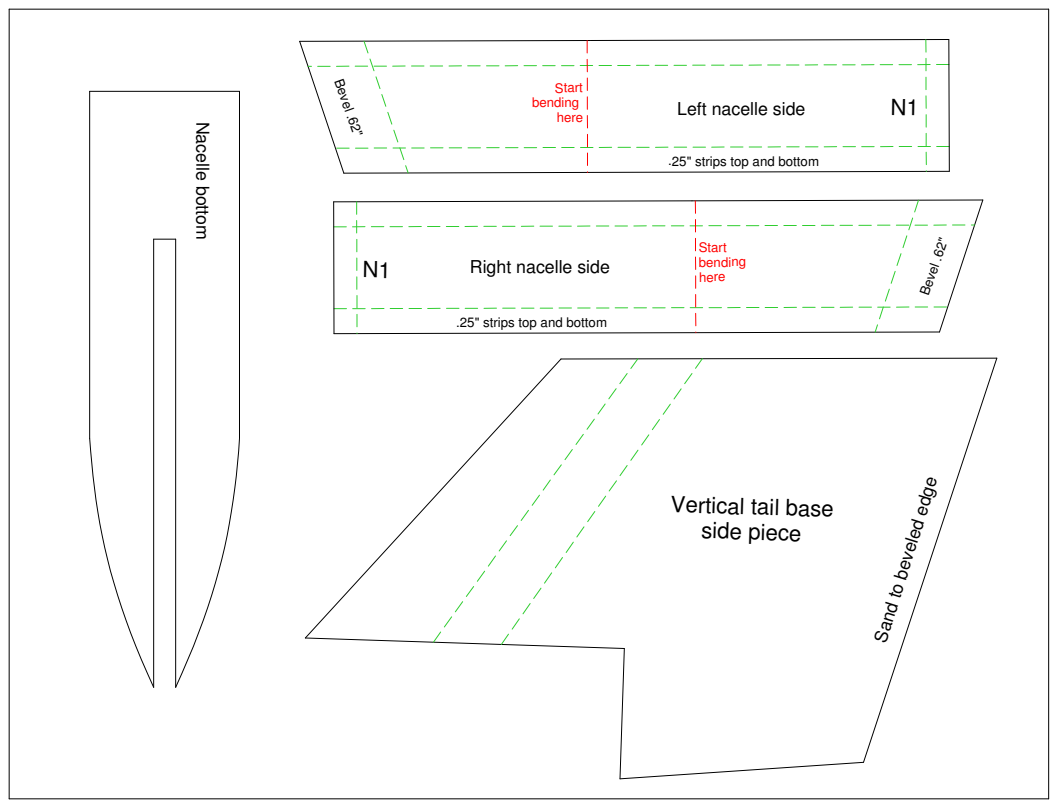
[picture p55: page 1]
Sand; beveled; side piece; Start bending here; Bevel; N a c elle

.25" strips top and bottom

N1 Right nacelle side

edge Vertical tail base

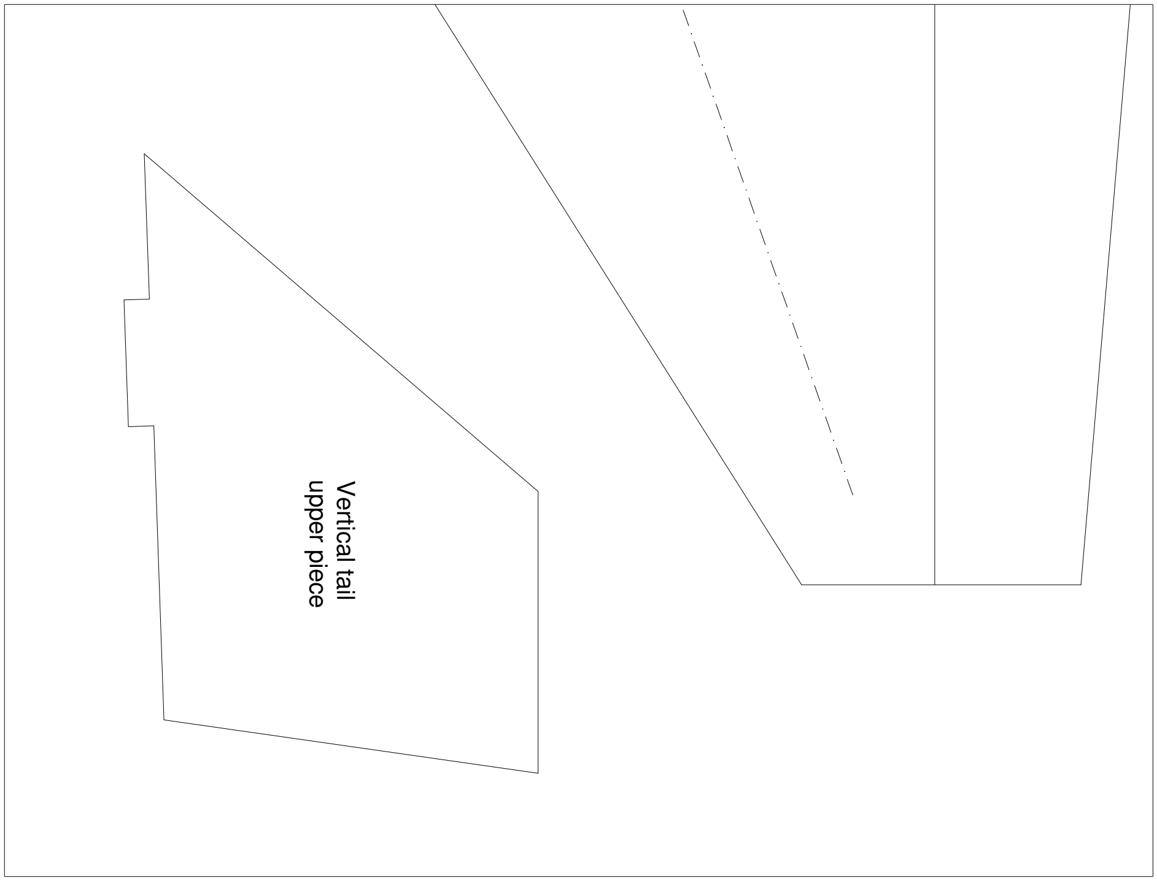
[picture p56: figure]
Vertical tail; upper piece

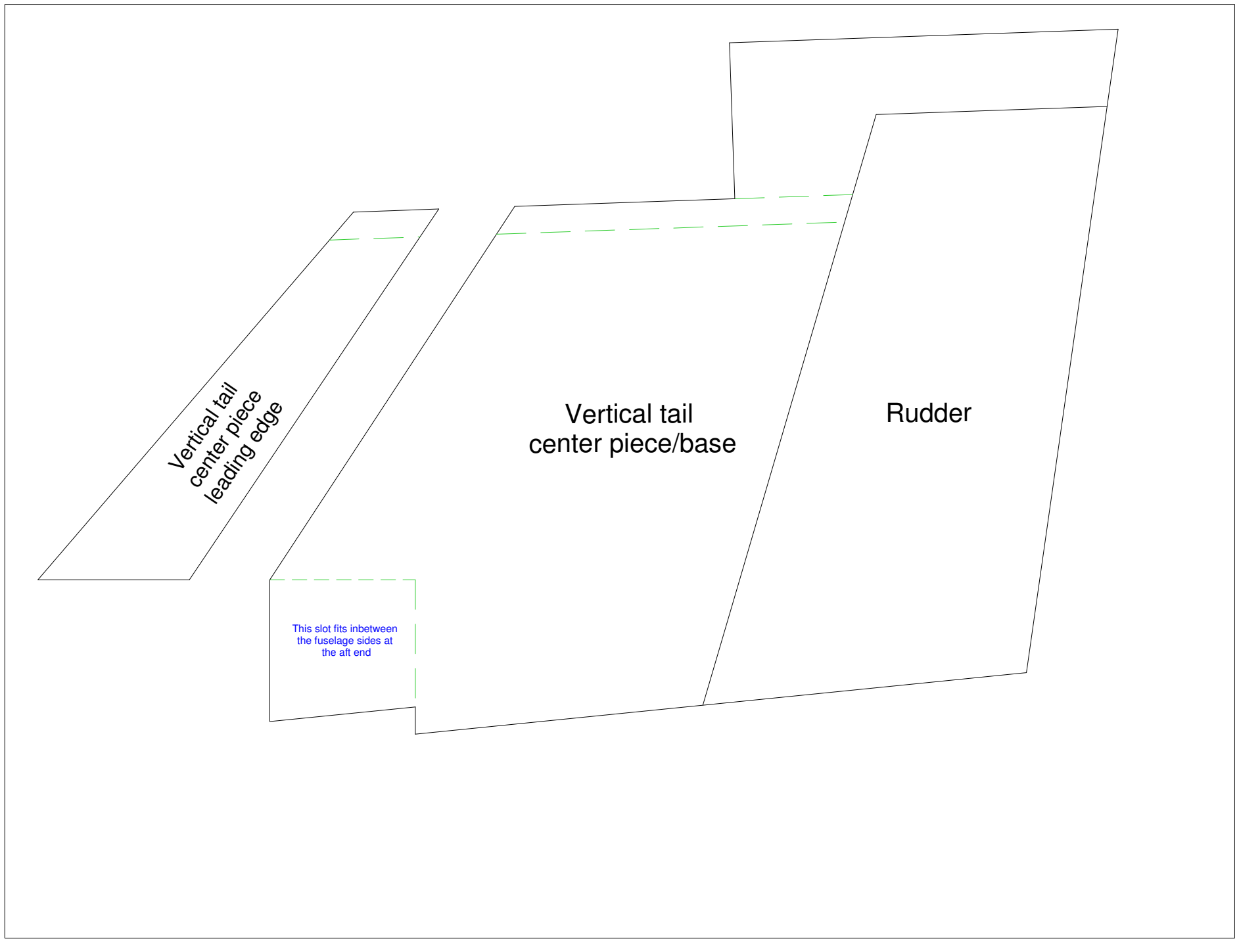
[picture p57: figure]
This slot fits inbetween the fuselage sides at the aft end; Vertical tail; Rudder; center piece/base Vertical tail center piece leading edge

## Motor mount

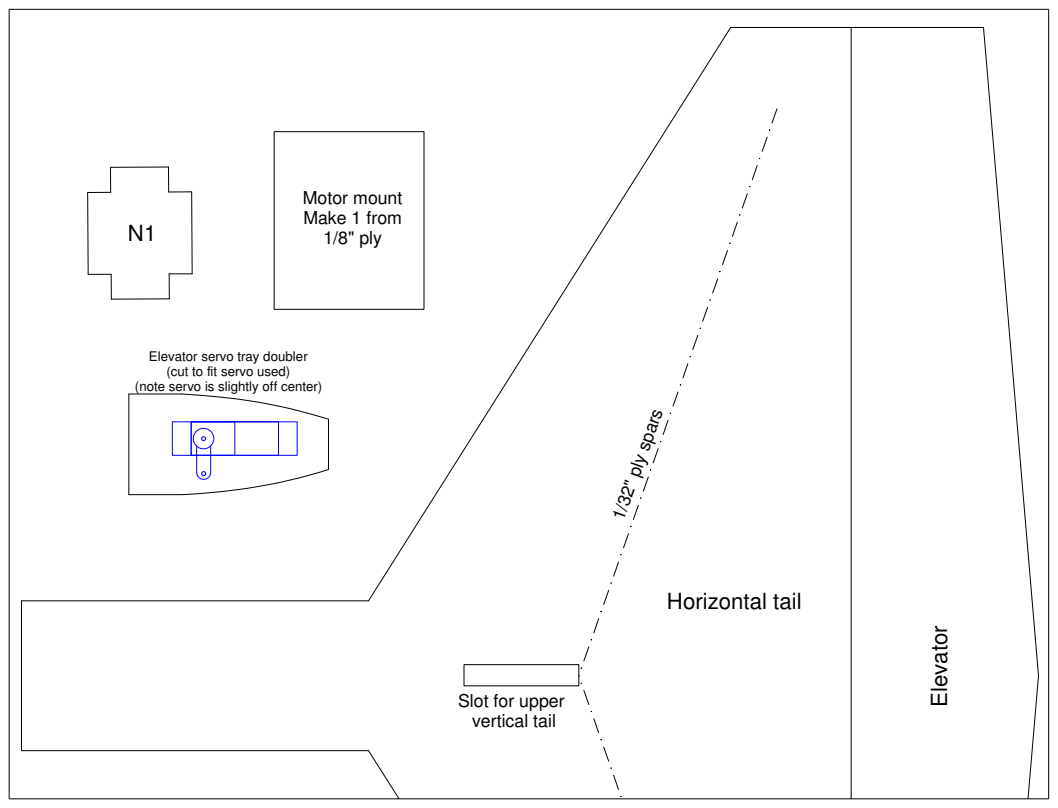
[picture p58: page 4]
Make 1 from N1; 1/8" ply; Horizontal tail; ply; spars; Ele

Elevator servo tray doubler
(cut to fit servo used)
(note servo is slightly off center)

Slot for upper
vertical tail
