brad-jones/polaris/references/original-design/Polaris Parts Templates (Nontiled).pdf

F1

F

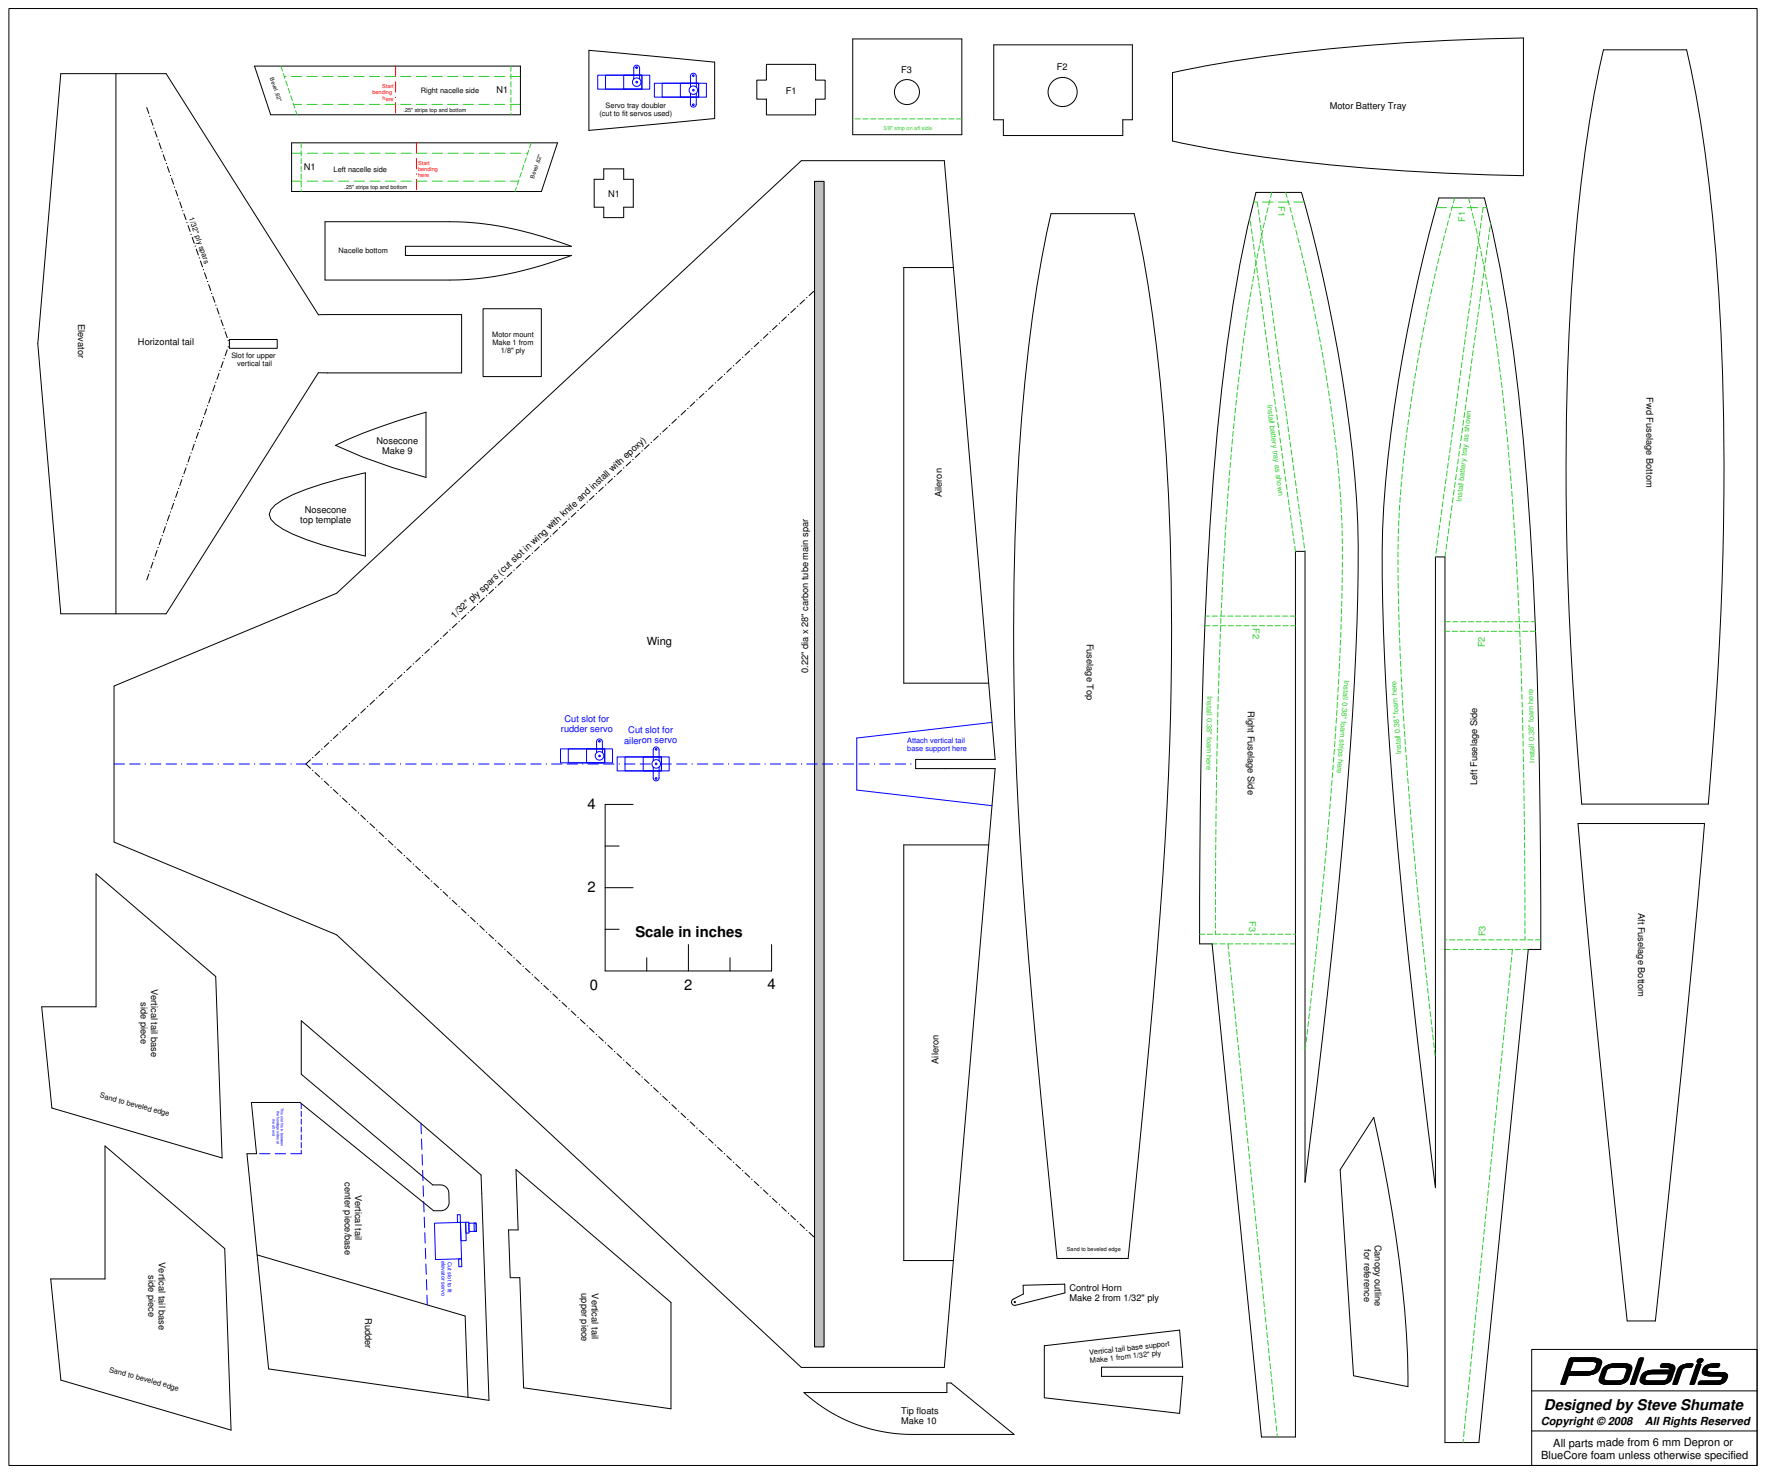
[picture p60: page 1]
Fuselage Top; ale in in; Canopy outline for reference; Start b ending here .2; Rig; elle; sid; otto; Sand to beveled edge; plate; N1 Bevel .62"; Start b ending here; L eft n a; c elle; sid e; ntrol H; orn; 2 fro; 2" ply; Tip flo; ats; Vertic; al tail b; port; ake 1 fro; All p; Blu; nle; wis; cifie; yrig; otor B; attery; Tra; oriz; ntal tail; Slot for u; er v ertic; al tail; 1/32" ply spars; Vertical tail; upper piece; side piece; ut slot for ailero n; erv; ut slot for ru d; Atta; ertic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

5" strips top and botto

3/8" strip on aft side

Fwd Fuselage Bottom

Install battery tray as shown

ply spars (cut slot in wing with knife and install with epoxy)

0.22" dia x 28" carbon tube main spar

Install 0.38" foam str pi s here

Ins at ll 0.38" of am here

Install 0.38" of am here

Install 0.38" foam here

Left Fuselage Sid

ight Fuselage Side

Aft Fuselage Bottom

side piece Vertical tail base

This slot fits in-between

the fuselage sides at

the aft end

center piece/base

Vertical tail base

Cut slot to fit
