brad-jones/polaris/references/original-design/Polaris Parts Templates (Scaled 120 Tiled).pdf

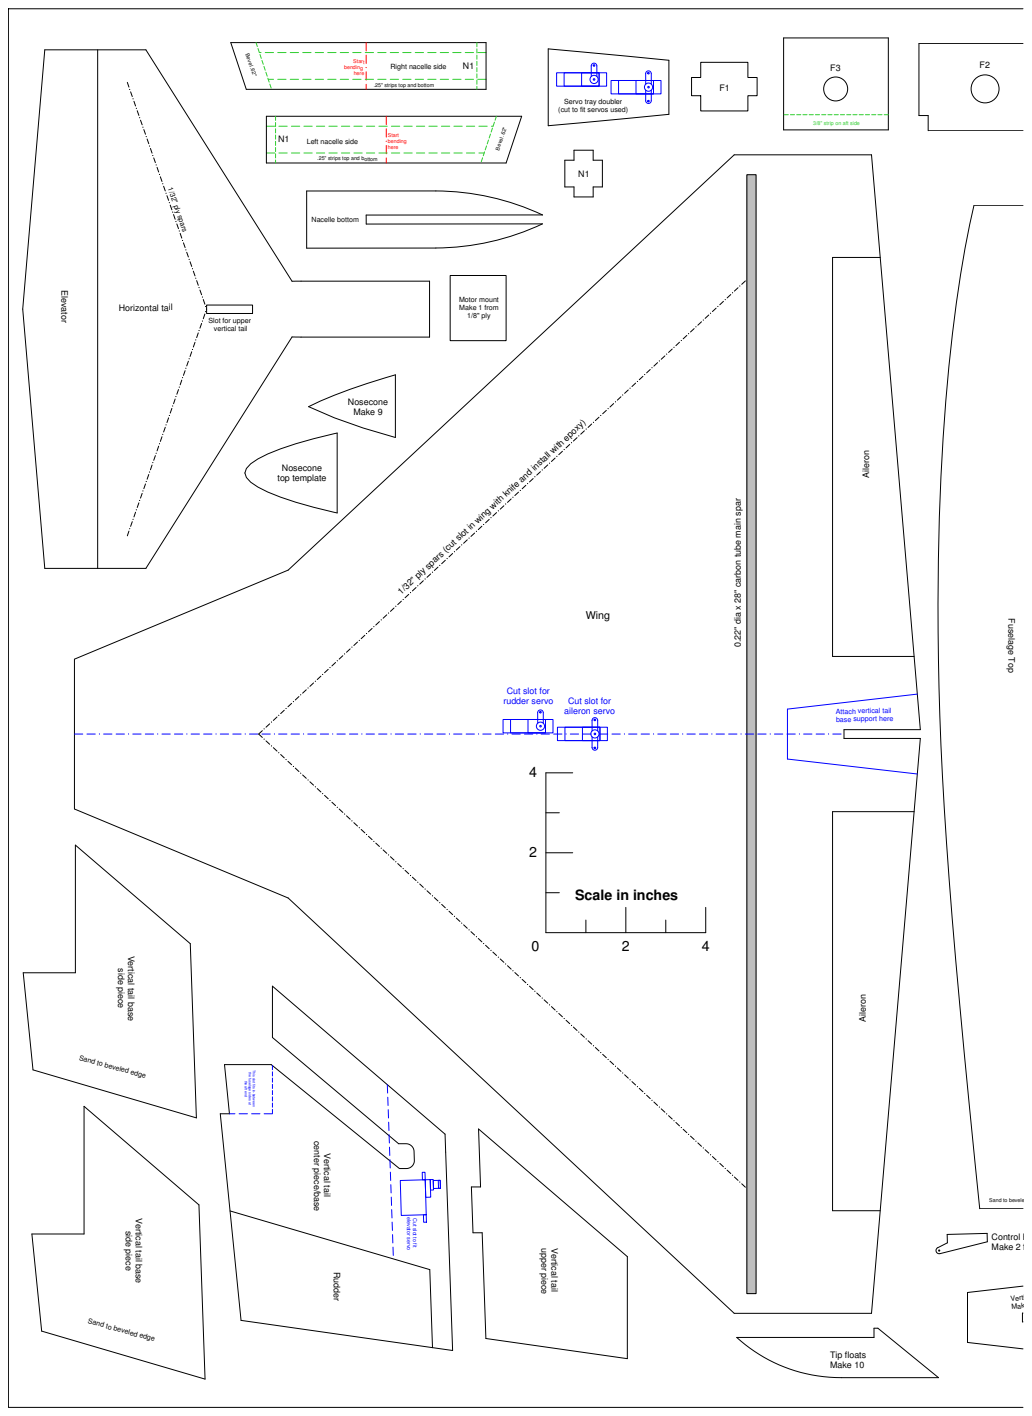
[picture p61: page 1]
F u s ela; Nosecone Make 9; Start bending here; Nacelle bottom; Bevel .62"; Control H Make 2; Tip floats Make 10; Verti Mak; Horizontal tail; ply; spars; dia; ain; Motor mount Make 1 from 1/8" ply; Wing; Ele; Aile; r tic; ail; r pie; ail b; sid; pie; ele; v ator s; erv; Nosecone top template

Right nacelle side

.25" strips top and bottom

Servo tray doubler
(cut to fit servos used)

3/8" strip on aft side

Left nacelle side

Slot for upper
vertical tail

1/32" ply spars (cut slot in wing with knife and install with epoxy)

Cut slot for
rudder servo

aileron servo

Attach vertical tail
base support here

Scale in inches

Sand to beveled edge

the fuselage sides at

This slot fits in-between

the aft end

Sand to bevele

ut slot to fit

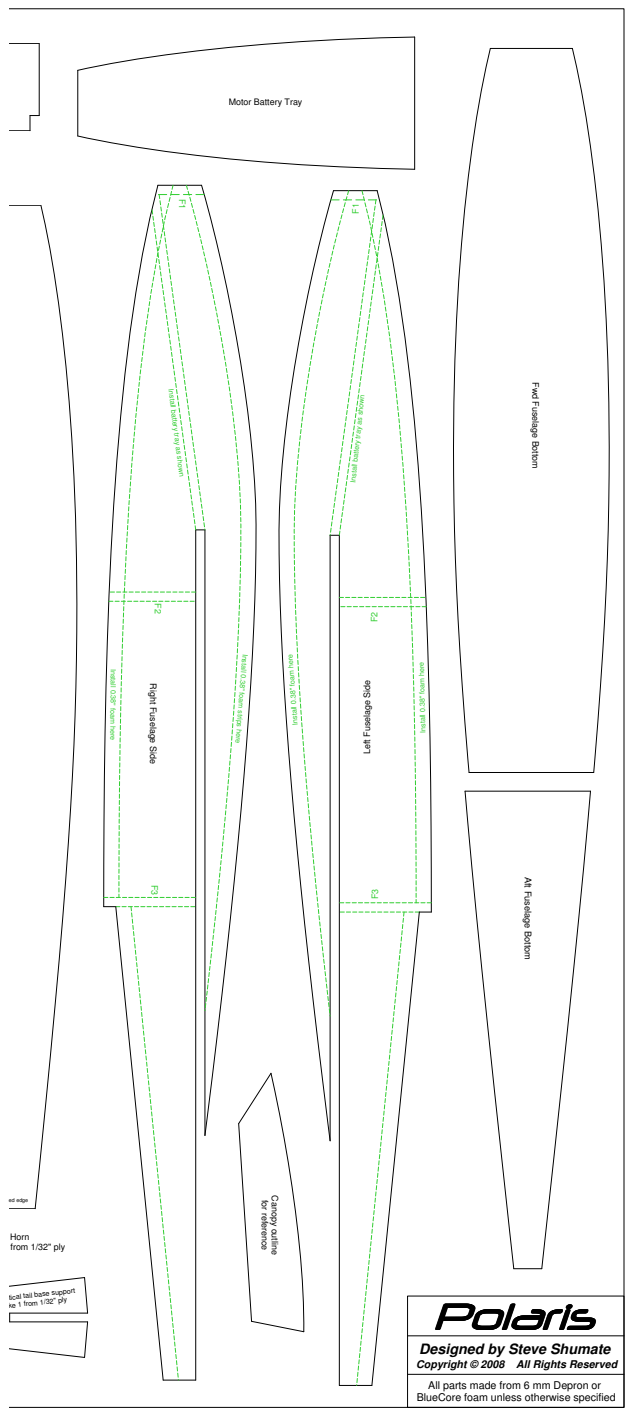
[picture p62: page 2]
ela; Sid; t F u s ela; g e Sid; tlin; F w d F u s ela; veled edge; f t F u s ela; h ere; ere; In stall b; atte; t ray; stall batte; ray

Motor Battery Tray

ol Horn
ake 2 from 1/32" ply

Vertical tail base support

Make 1 from 1/32" ply

Designed by Steve Shumate
Copyright © 2008 All Rights Reserved
All parts made from 6 mm Depron or
BlueCore foam unless otherwise specified
