brad-jones/polaris/references/original-design/Polaris Parts Templates (Scaled 75 Nontiled).pdf

F1

F

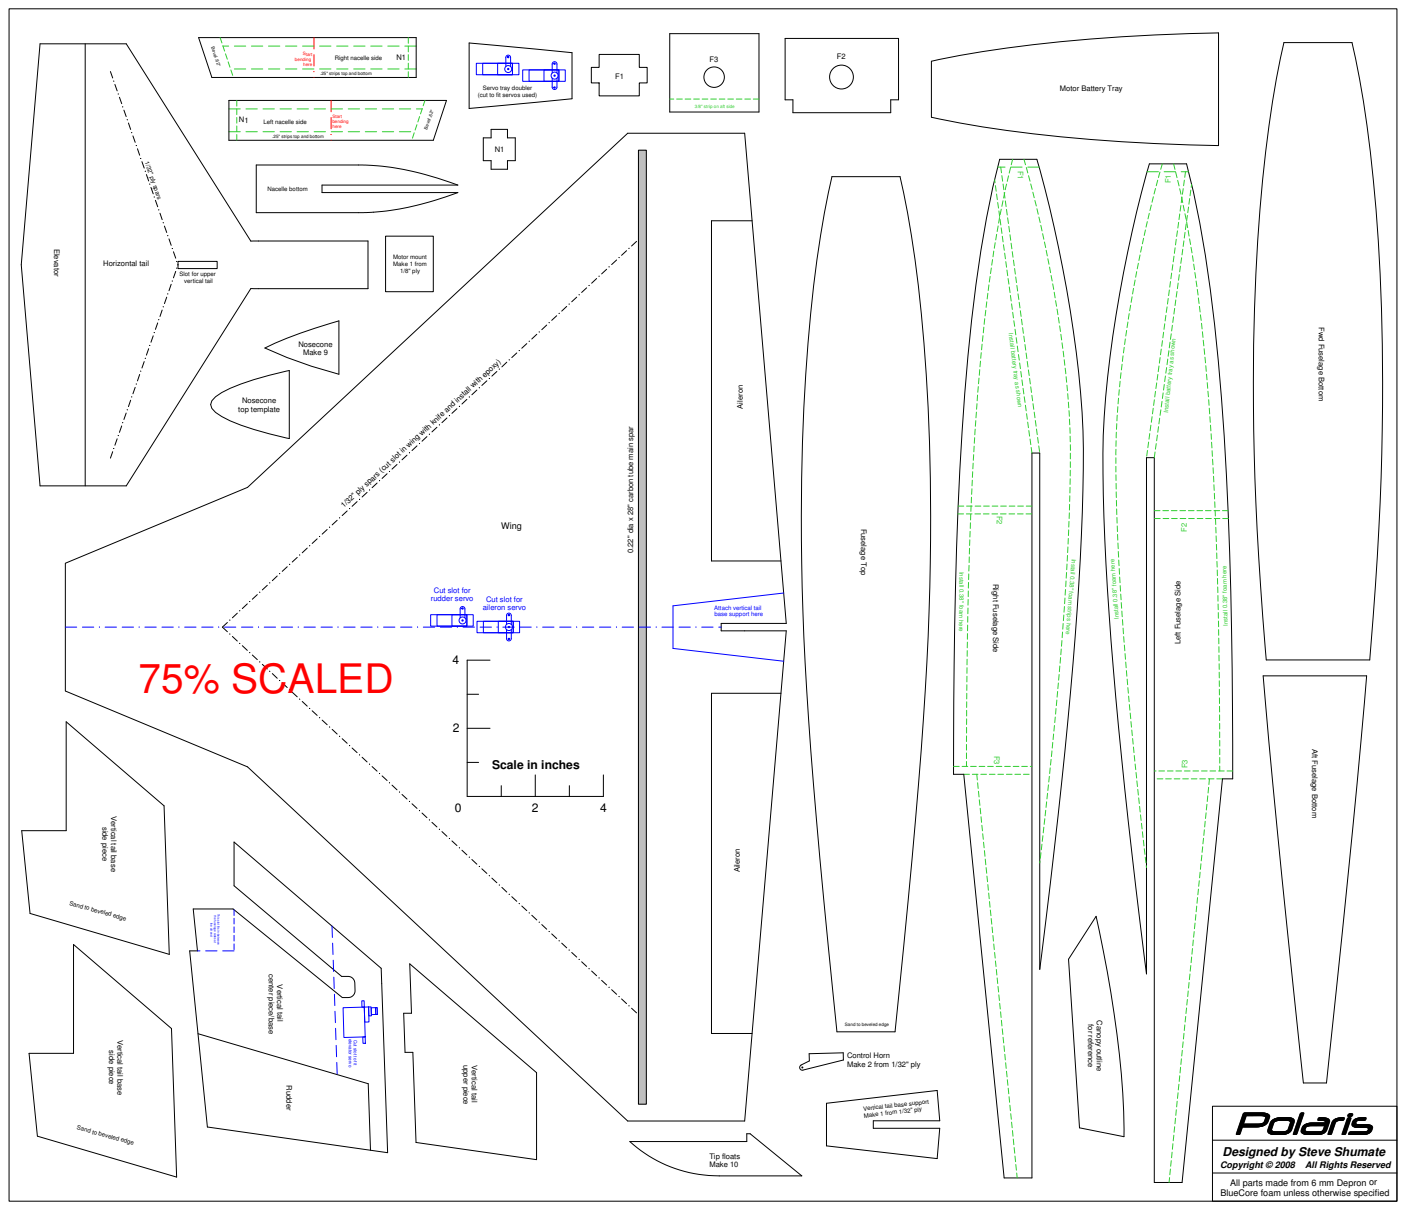
[picture p63: page 1]
Fuselage Top; ale in in; Canopy outline for reference; acelle botto; N1 Bevel .62"; Start bending here; ntrol H; orn; 2 fro; 2" ply; Tip flo; ats; ertical tail b; port; ake 1 fro; All p; arts; e fro; pro; or Blu e; ore fo; nle; oth; erwis; cifie; yrig; All Rig; otor B; attery; Tra; oriz; ntal tail; Slot for upper v; ertical tail; 1/32" ply spars; ut slot for ailero n; erv; ut slot for ru d; otor m; ount M ake 1 fro; m 1/8" ply; os used); Win; Elevator; Aileron; Sand to beveled edge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

Right nacelle side

.25" strips top and bottom

o tray doubler (cut to fit serv
erv

3/8" strip on aft side M

Start bending here .25" strips top and bottom
Left nacelle side

Fwd Fuselage Bottom

Install battery tray as shown

1/32" ply spars (cut slot in wing with knife and install with epoxy)

0.22" dia x 28" carbon tube main spar

nI s at ll 0 3. 8" of am str pi s here

nI s at ll 0 3. 8" foam here

Ins at ll 0 3. 8" foam here

Install 0.38" foam here

Left Fuselage Sid

ight Fuselage Side

ertical tail base support here
Attach v

Aft Fuselage Bottom

Vertical tail base

the fuselage sides at

This slot fits in-between

the aft end

center piece/base

Sand to beveled edge

Cut slot to fit
