brad-jones/polaris/references/original-design/Polaris Parts Templates (Tiled A4).pdf

Sand to beveled edge

c
al t

ail iece/b

a
s
e

V
e
r
tic

al t

ail b

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
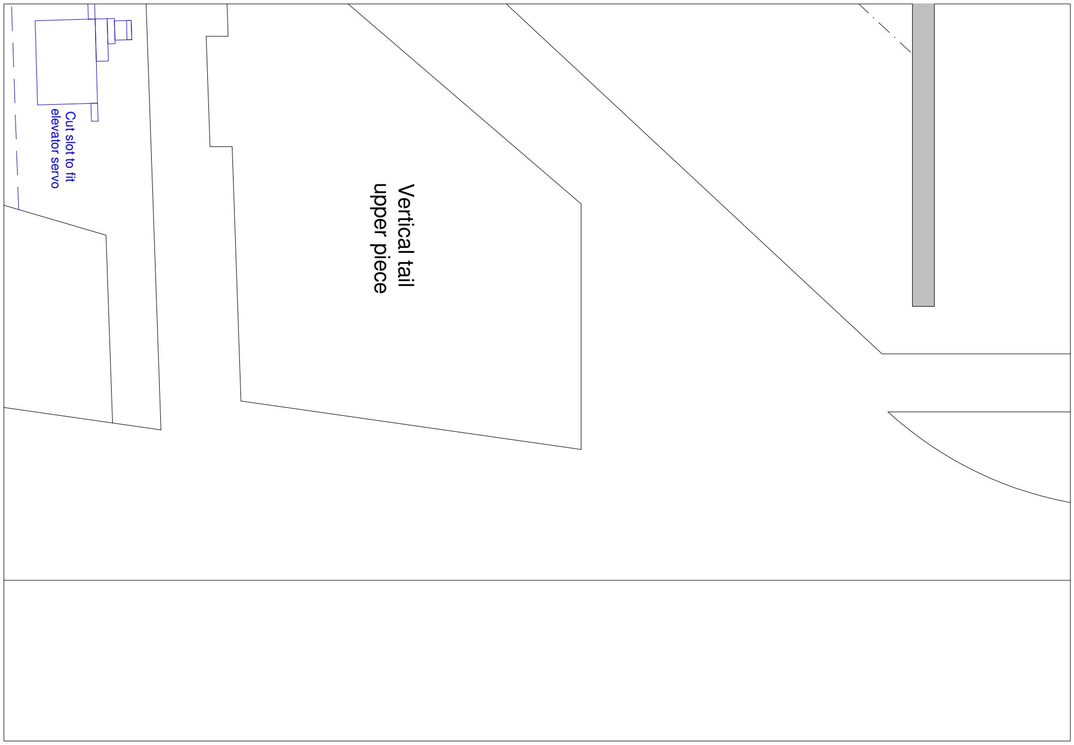
[picture p64: figure]
Vertical tail; upper piece; Cut slot to fit; elevator servo

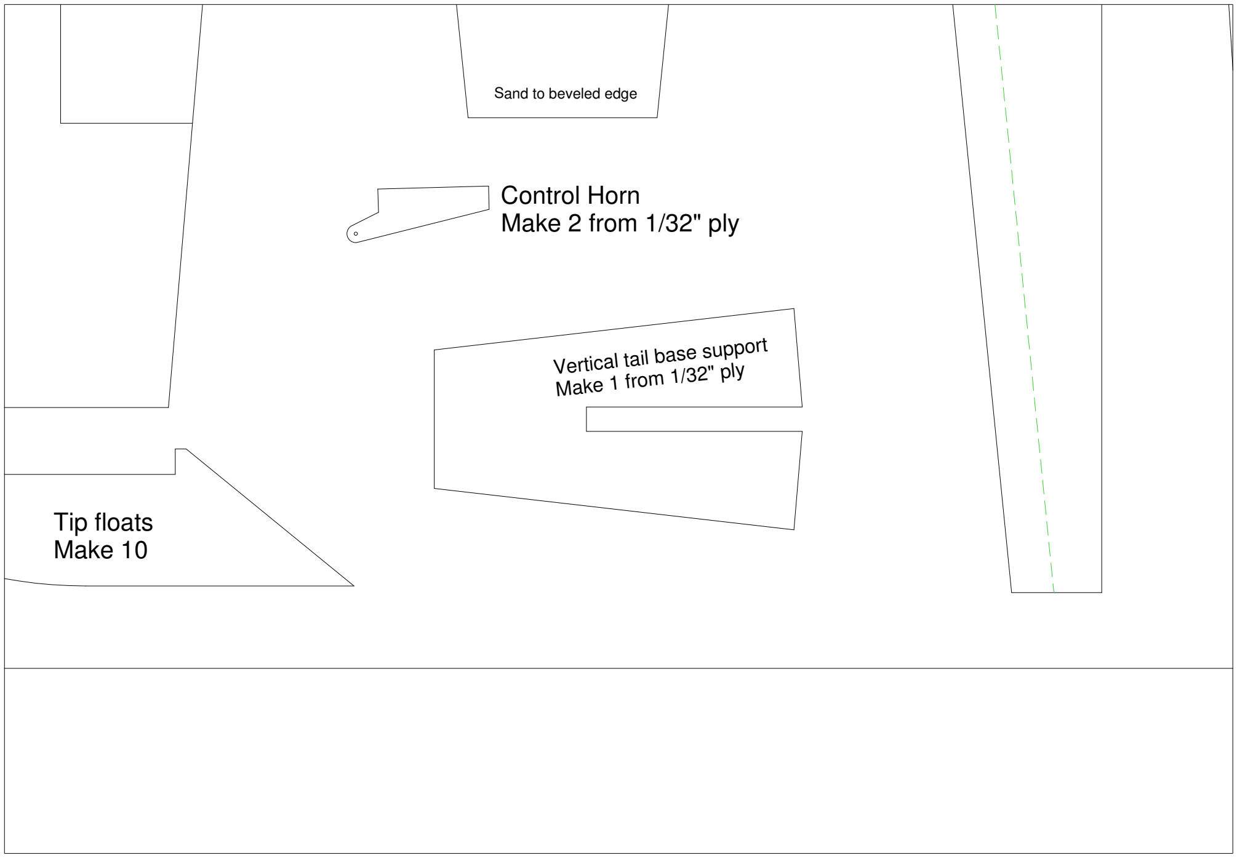
[picture p65: figure]
Control Horn Make 2 from 1/32" ply; Tip floats Make 10; Vertical tail base support Make 1 from 1/32" ply; Sand to beveled edge

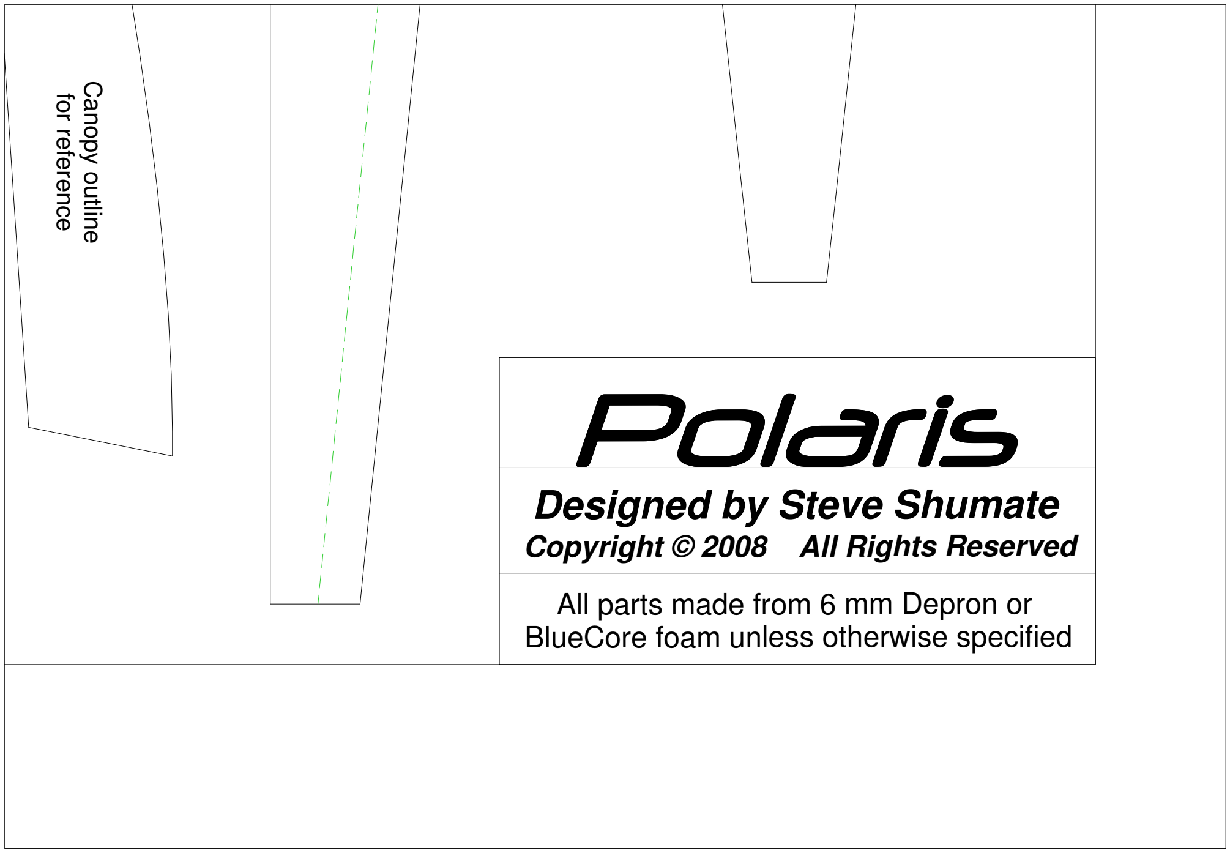
[picture p66: figure]
Canopy outline for reference; All p; Blu; nle; wis; cifie; yrig; Rig

Sand
to
beveled
edge

### Vertic

### center pi

### Vertical tail base side piece

This slot fits in-between
the fuselage sides at

the aft end

# Scale in inches

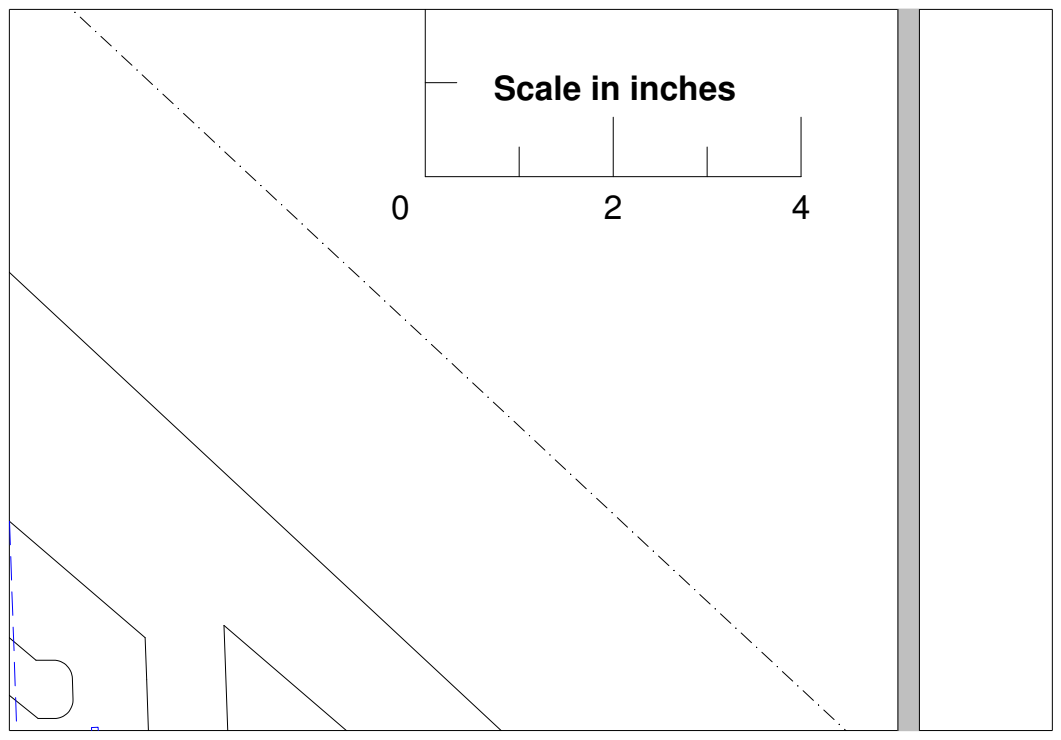
[picture p67: page 6]

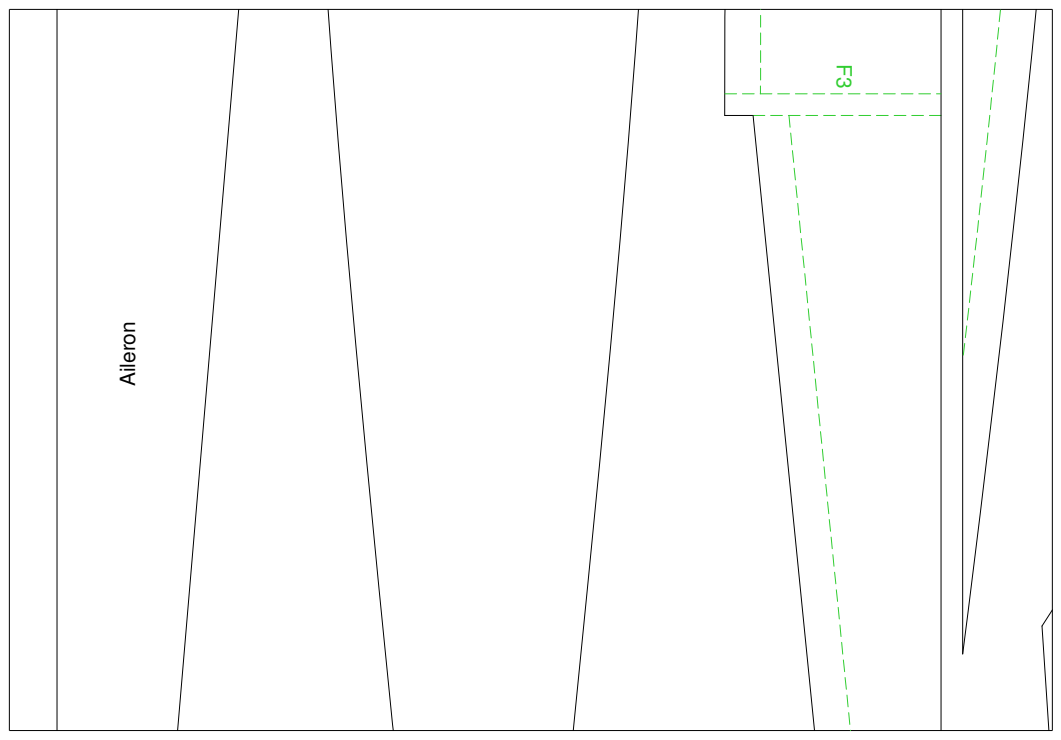
[picture p68: page 7]
Aileron

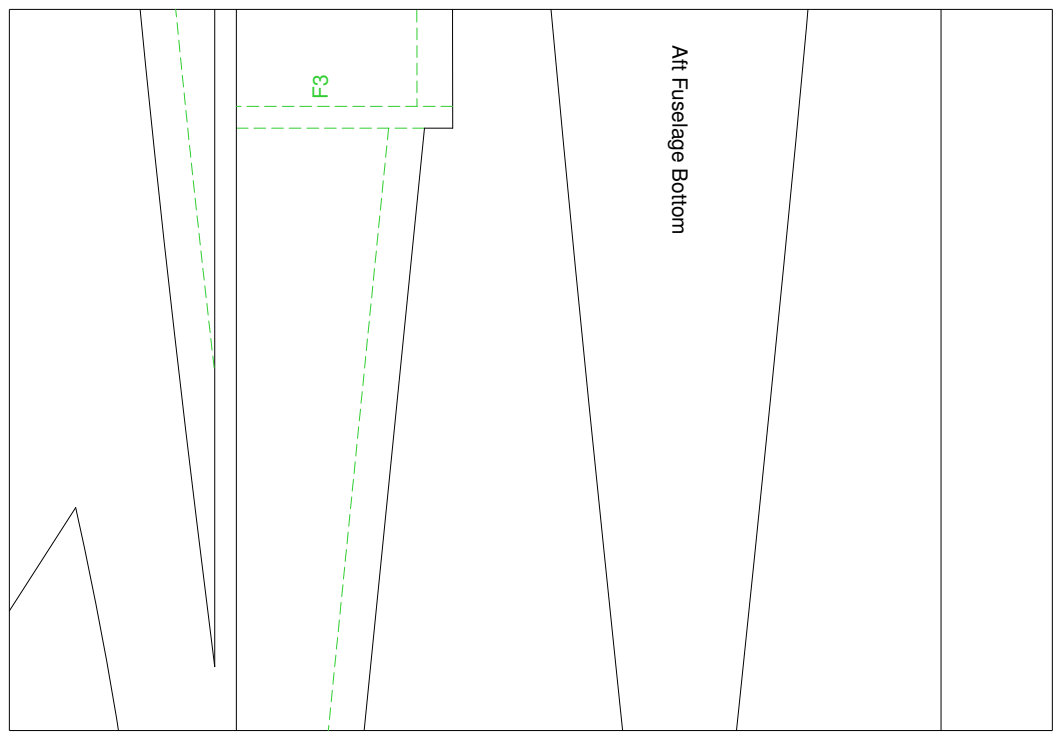
[picture p69: page 8]

Aft Fuselage Bottom

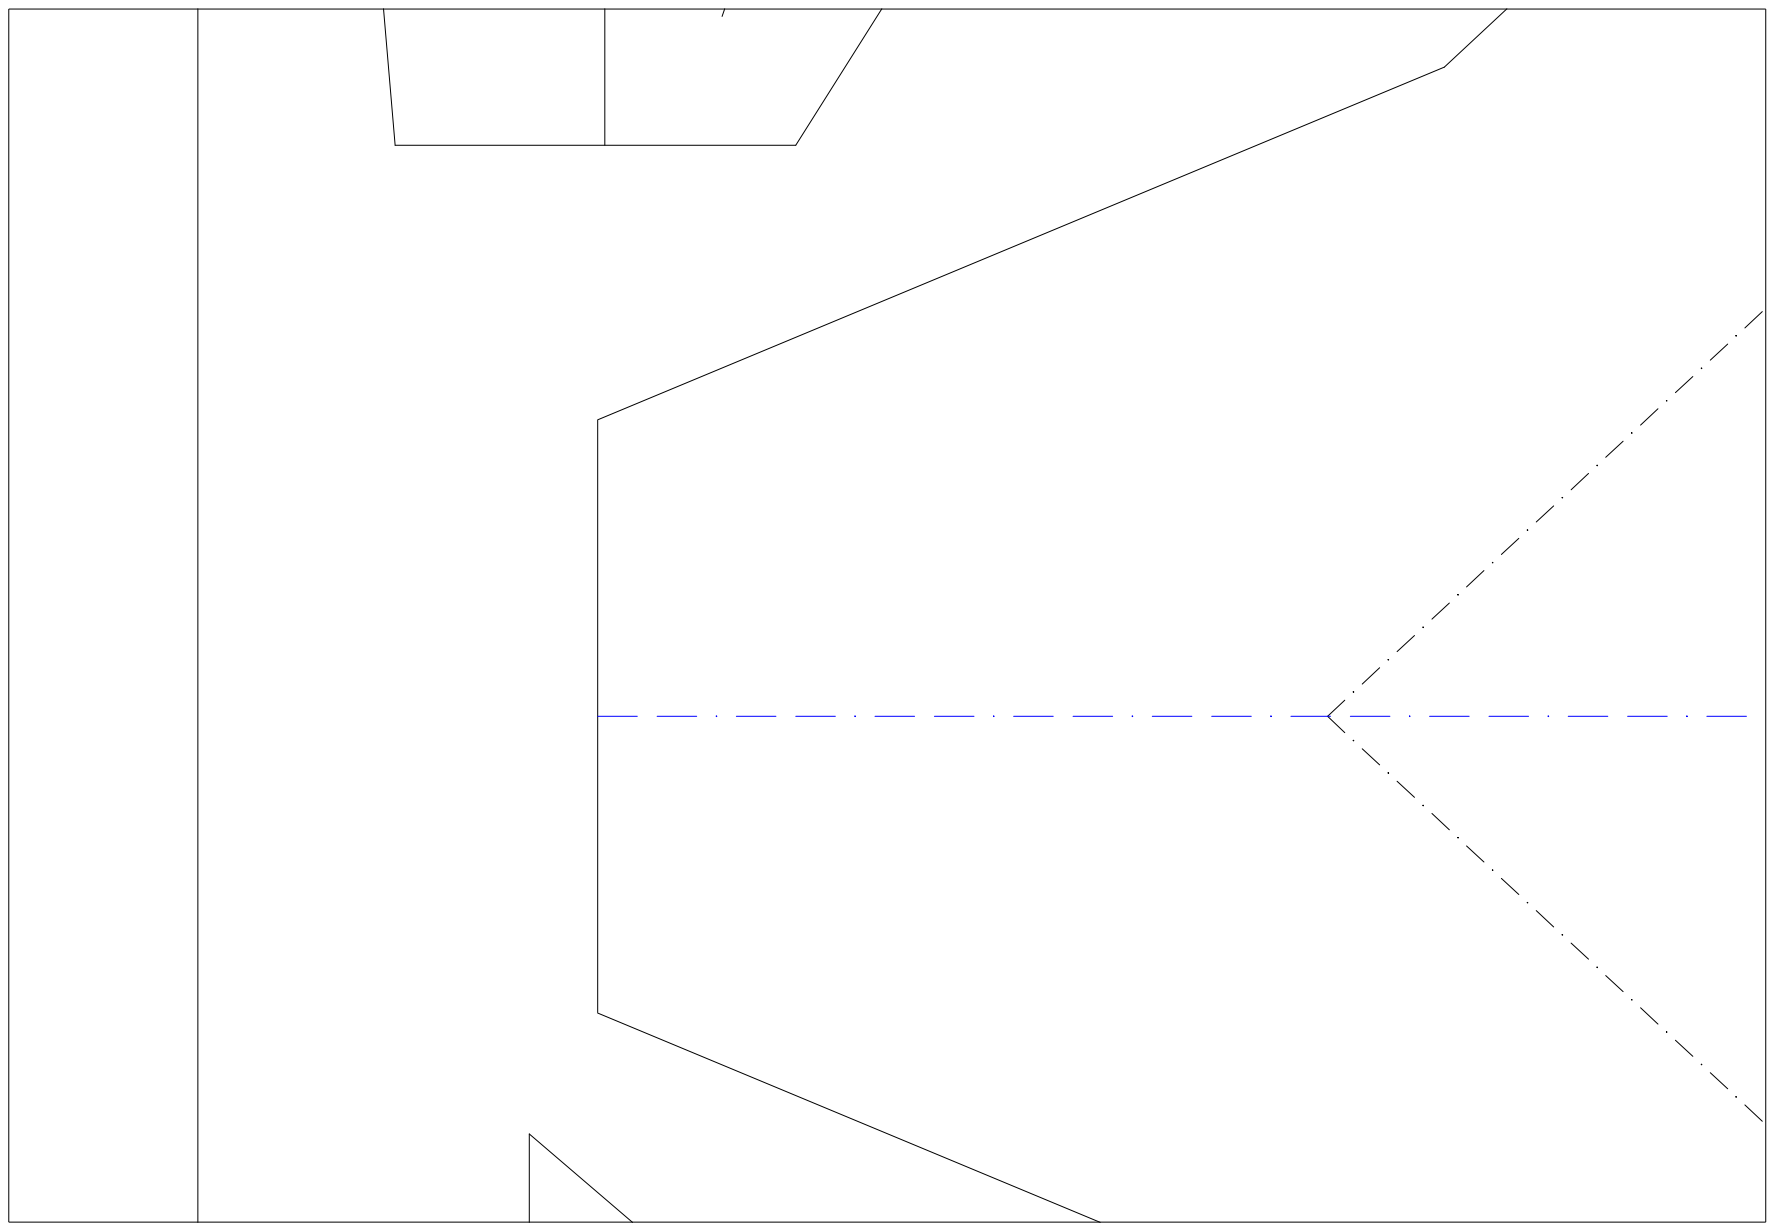
[picture p70: page 9]

## Wing

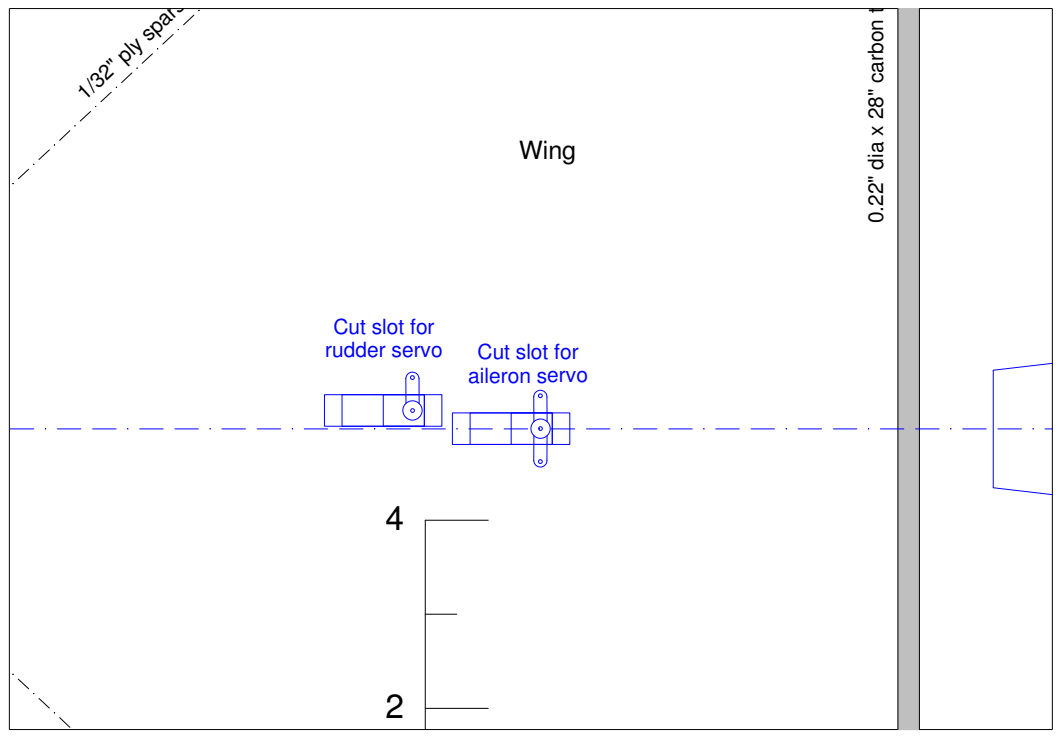
[picture p71: page 10]
1/32" ply spar; dia

Cut slot for
rudder servo

aileron servo

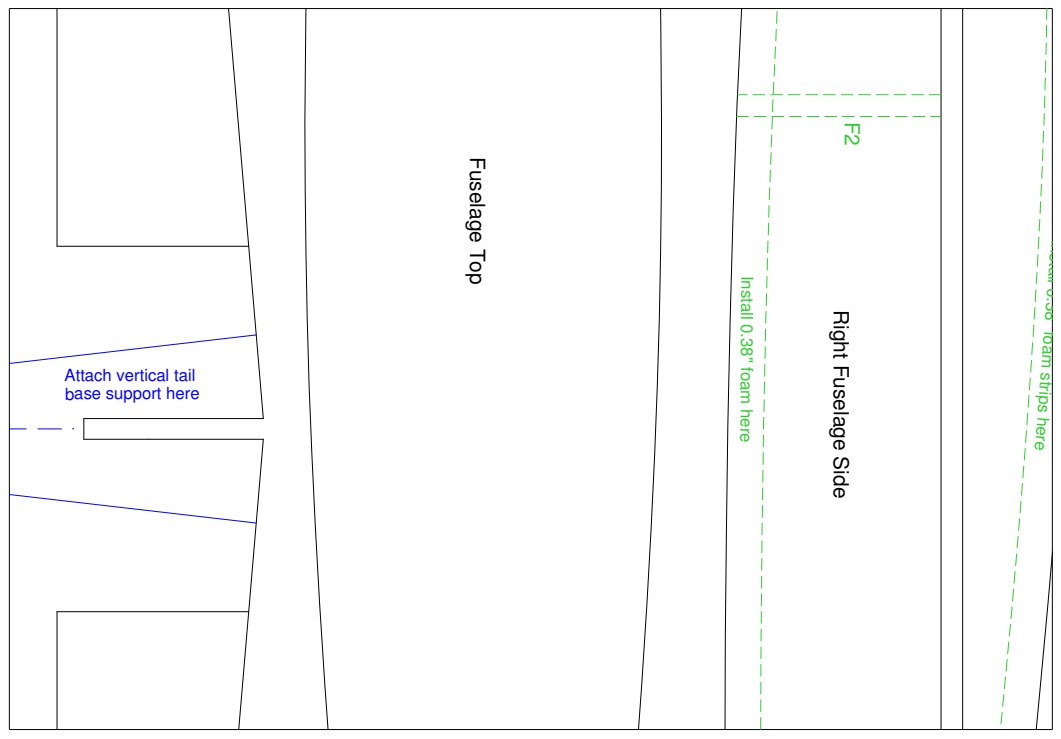
[picture p72: page 11]
Fuselage Top; Atta; ertic; al tail b a; ort h; ere

Install 0.38" foam str pi s here

Install 0.38" foam here

Right Fuselage Side

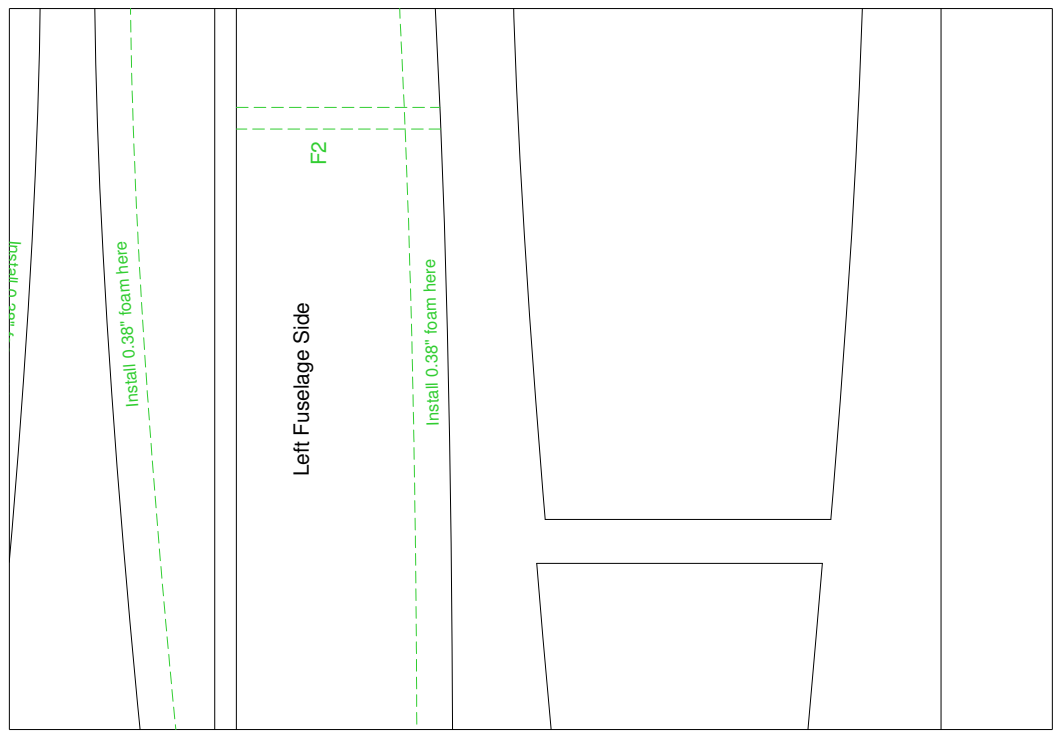
[picture p73: page 12]
Install "

Ins at ll 0.38" of am here

Install 0.38" of am here

Left Fuselage Side

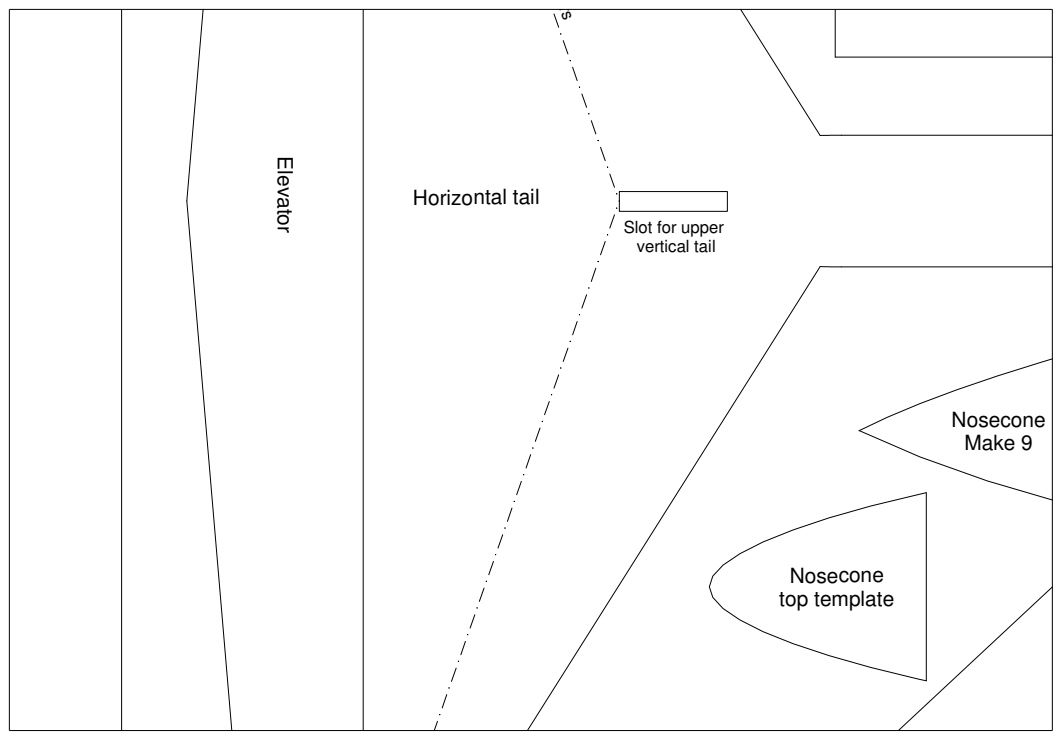
[picture p74: page 13]
Nosecone Make 9; Nosecone top template; Horizontal tail; Ele

Slot for upper
vertical tail

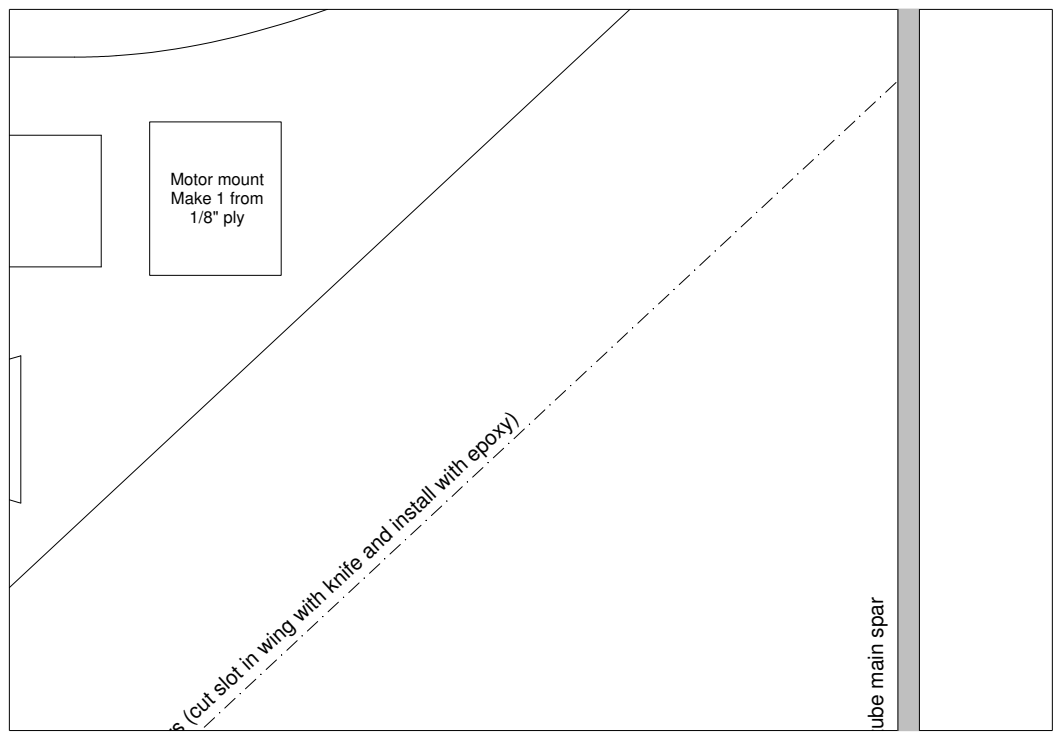
[picture p75: page 14]
ain; Motor mount Make 1 from 1/8" ply

rs (cut slot in wing with knife and install with epoxy)

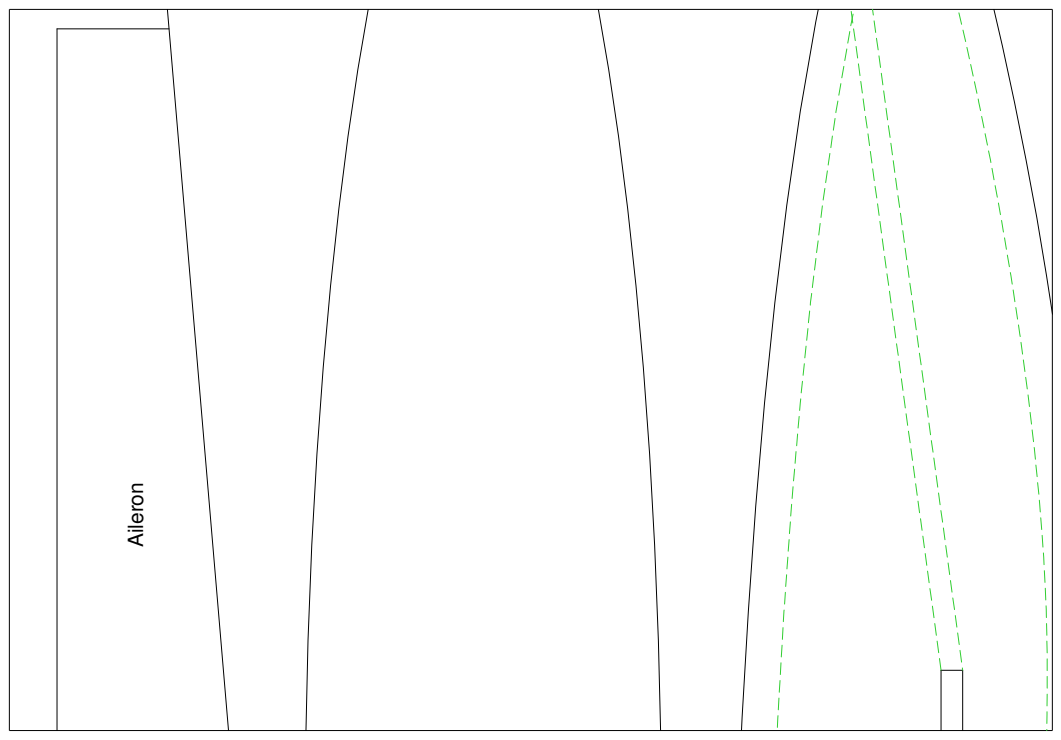
[picture p76: page 15]
Aileron

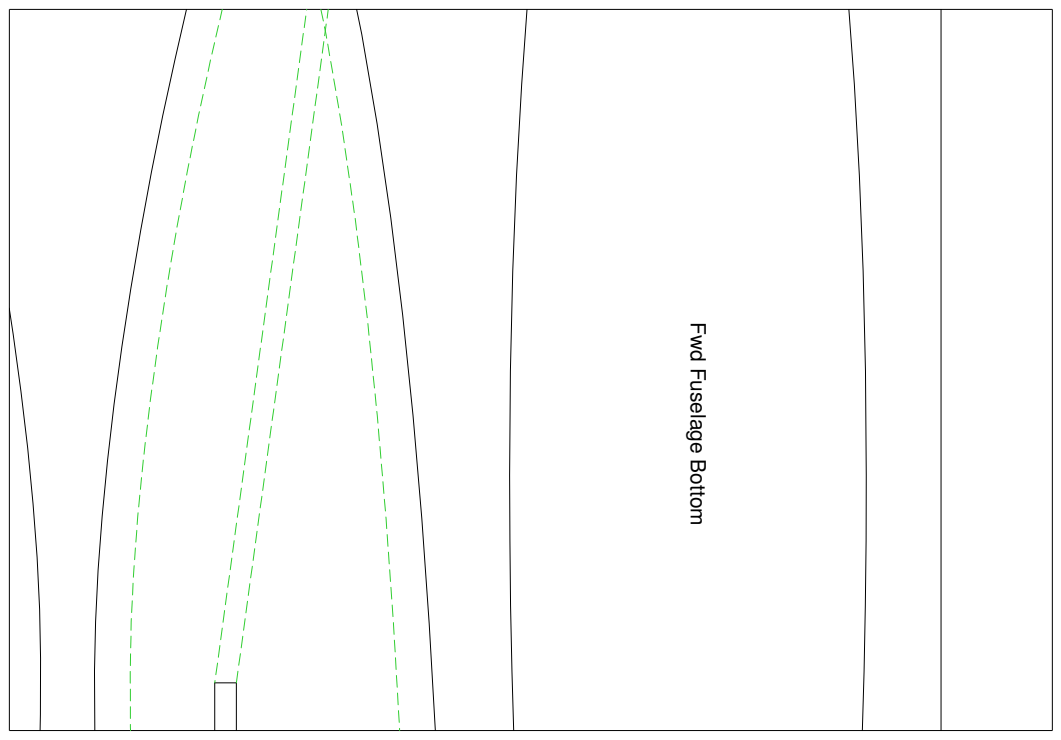
[picture p77: page 16]

Fwd Fuselage Bottom

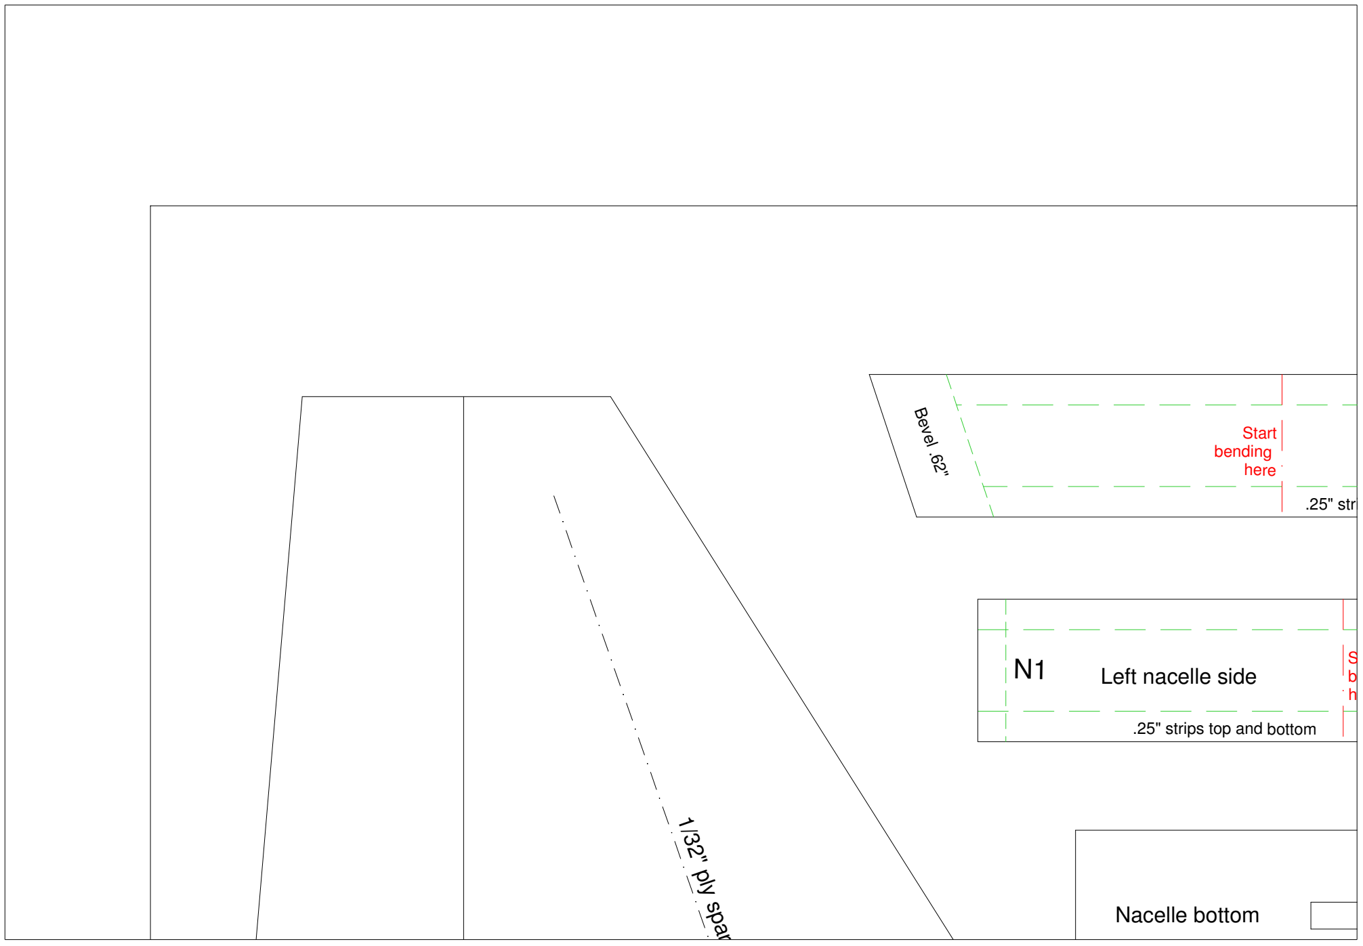
[picture p78: figure]
5" strips top and botto m; elle; otto; Start b ending here; Bevel .62"; L eft n a; c elle; sid e; 1/32" ply spar; 5" stri
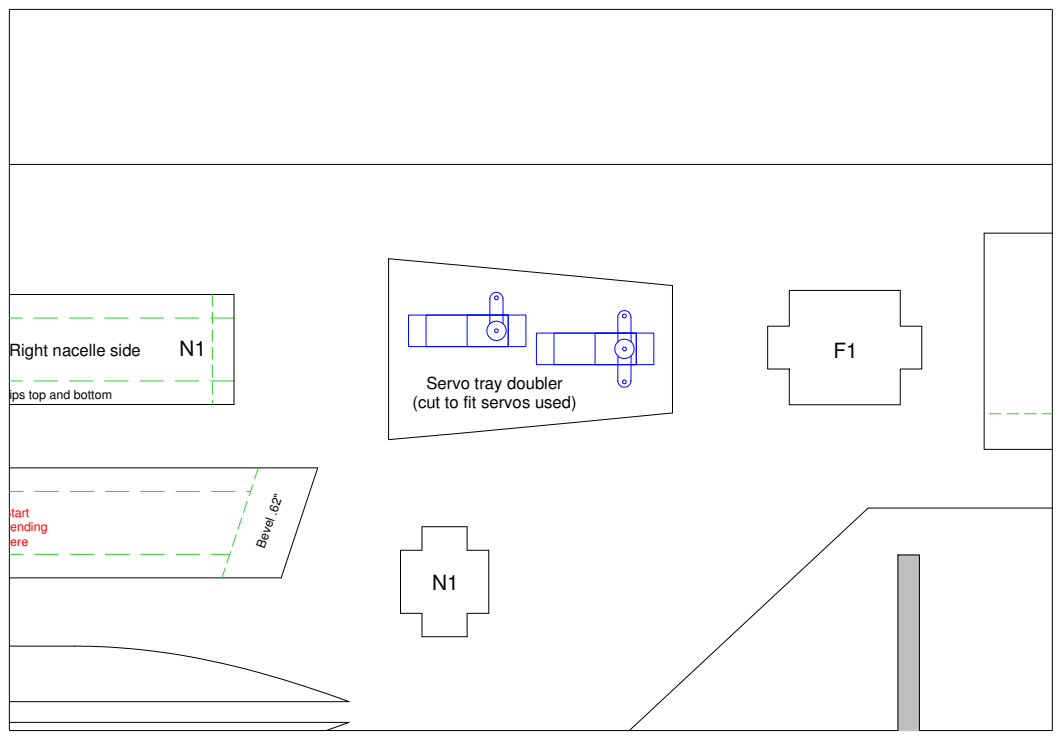
[picture p79: page 18]
Start bending here; Bevel

Right nacelle side

Servo tray doubler
(cut to fit servos used)

.25" strips top and bottom

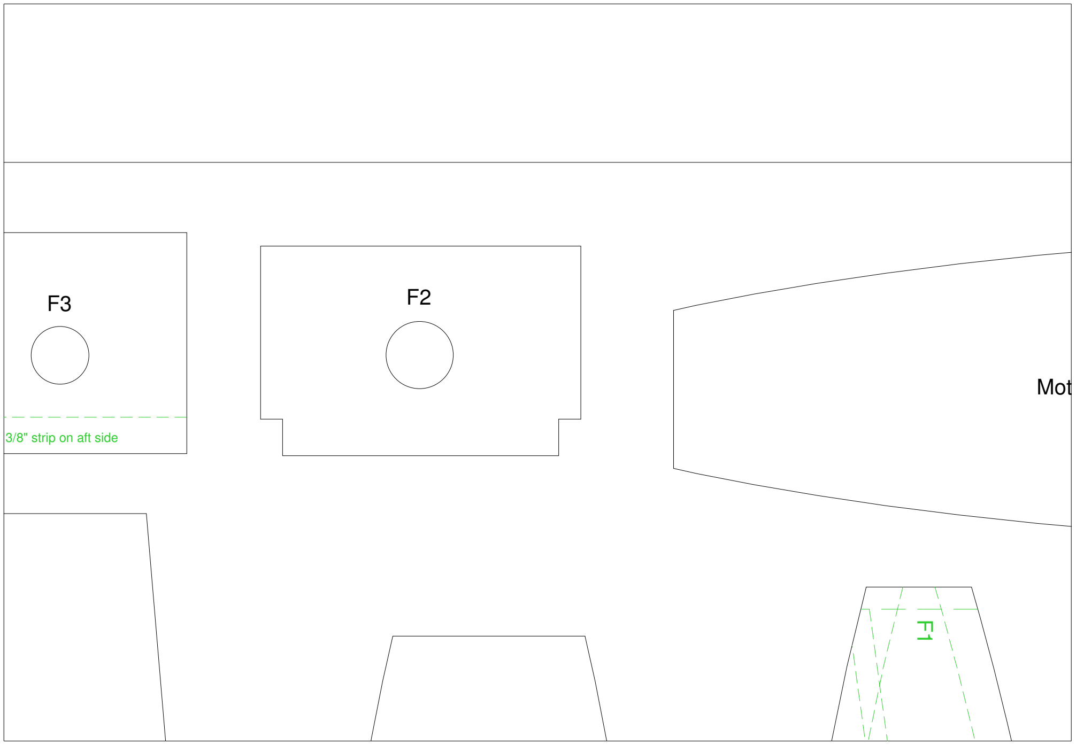
[picture p80: figure]
Mot; 3/8" strip on aft side

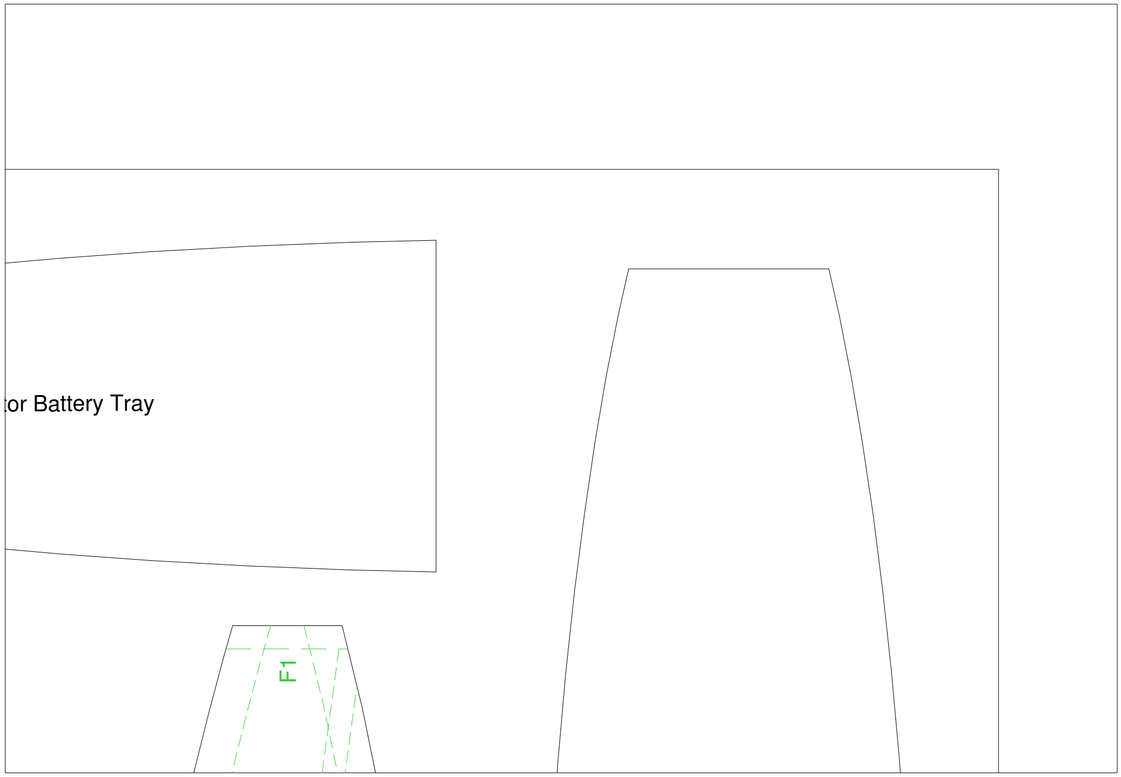
[picture p81: figure]
Motor Battery Tray
