brad-jones/polaris/references/original-design/Polaris Parts Templates (Tiled).pdf

Sand
to
beveled
edge

l tail

### ce/base

### Vertical tail base side piece

### Rudder

elevator servo

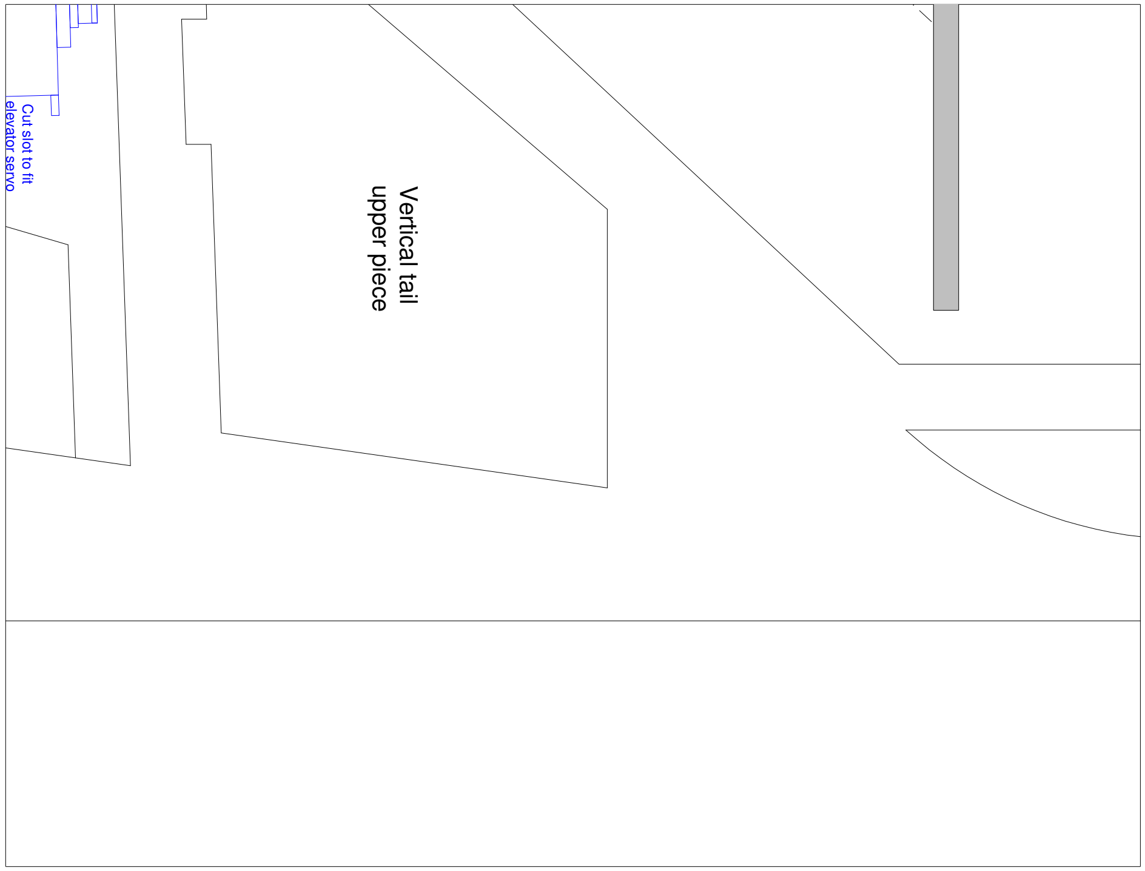
[picture p82: figure]
Vertical tail; upper piece; Cut slot to fit; elevator servo

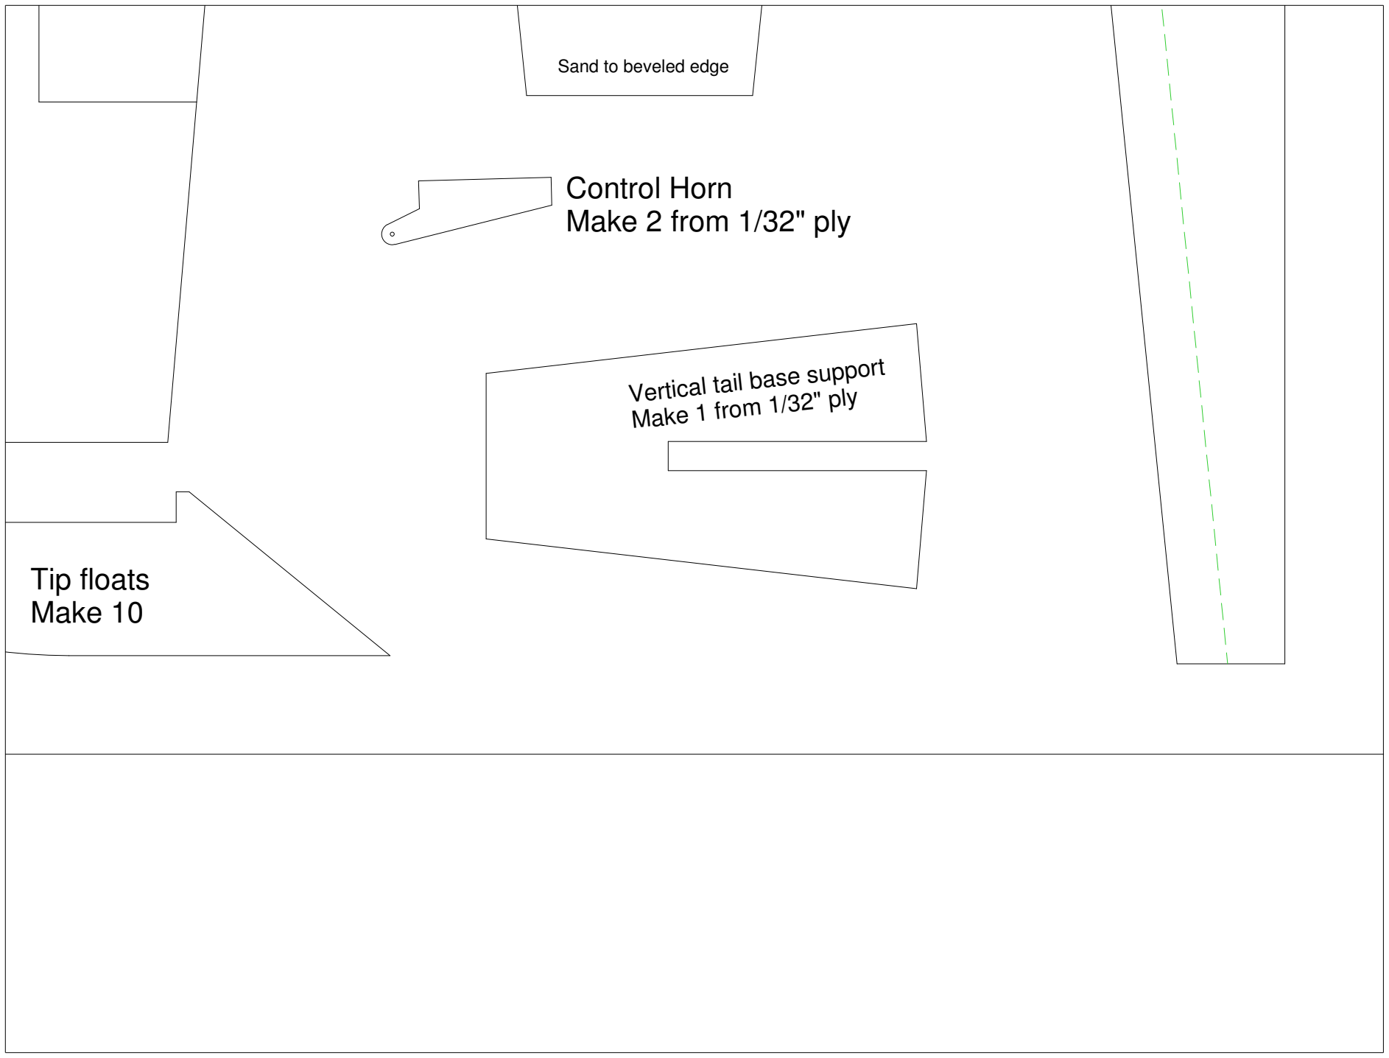
[picture p83: figure]
Control Horn Make 2 from 1/32" ply; Tip floats Make 10; Vertical tail base support Make 1 from 1/32" ply; Sand to beveled edge

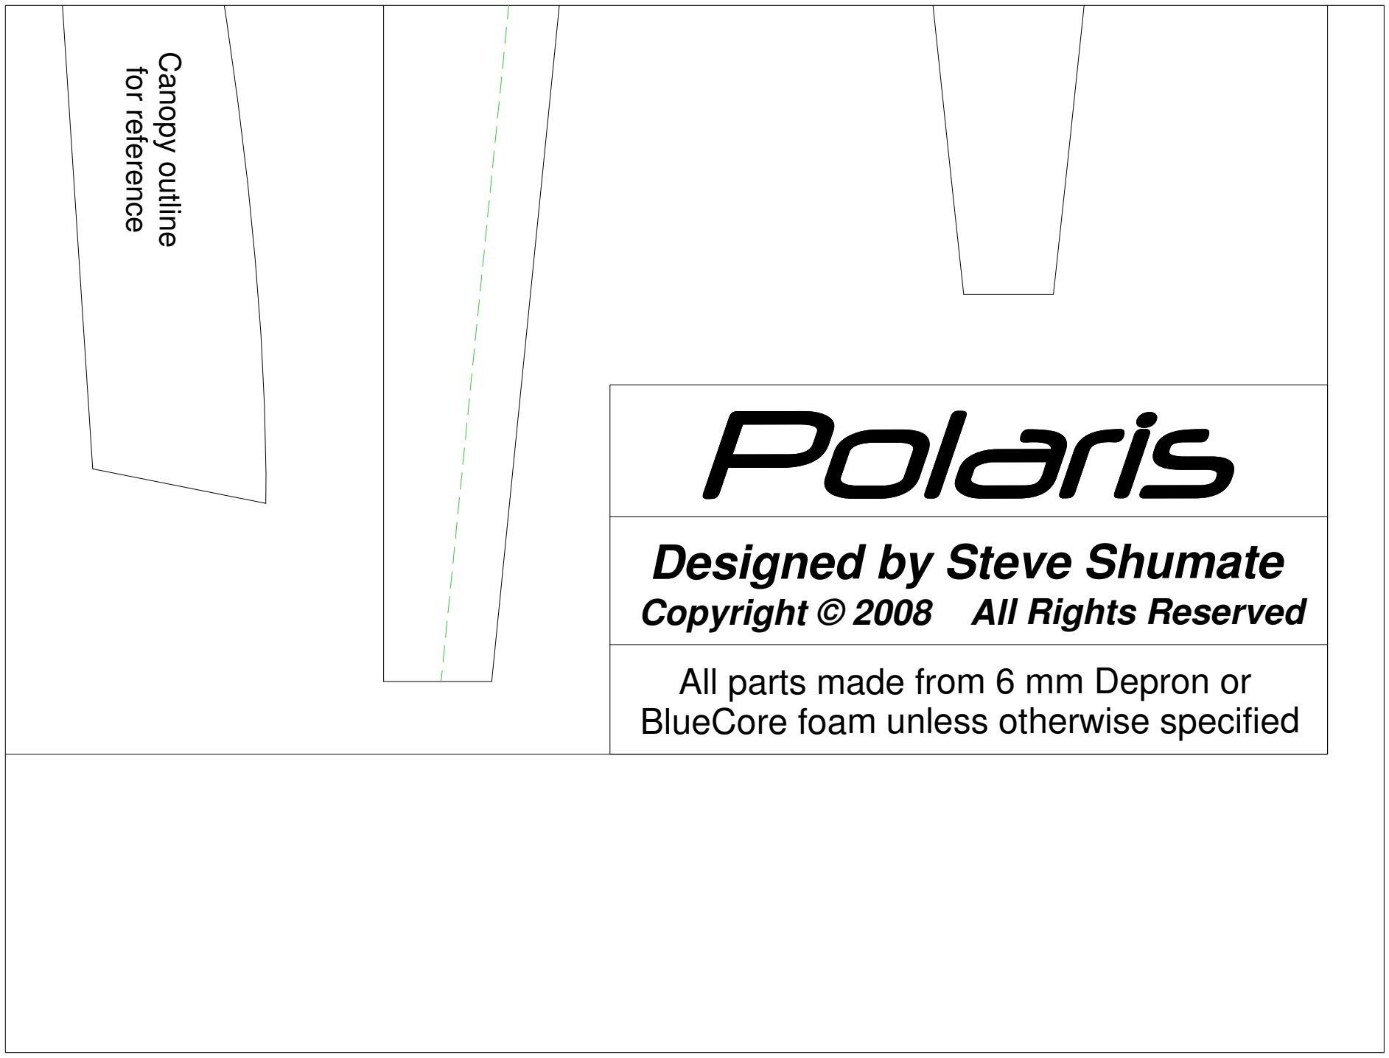
[picture p84: figure]
Canopy outline for reference; All p; Blu; nle; wis; cifie; yrig; Rig

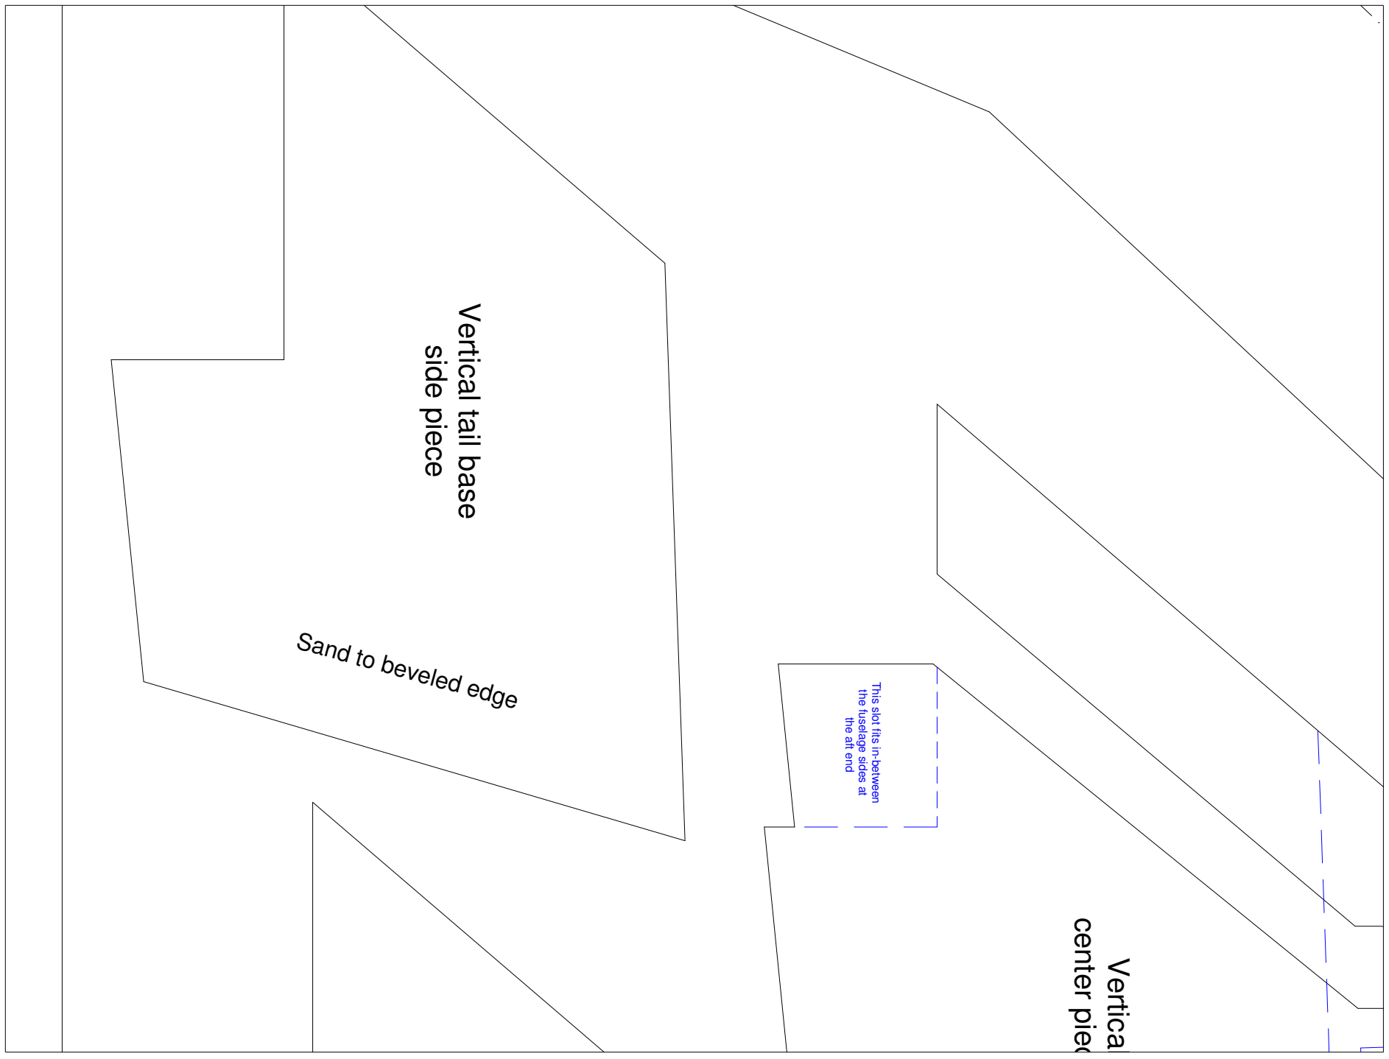
[picture p85: figure]
Sand to beveled edge; Vertical; center piec; Vertical tail base side piece; This slot fits in-between the fuselage sides at; the aft end

0

# Scale in inches

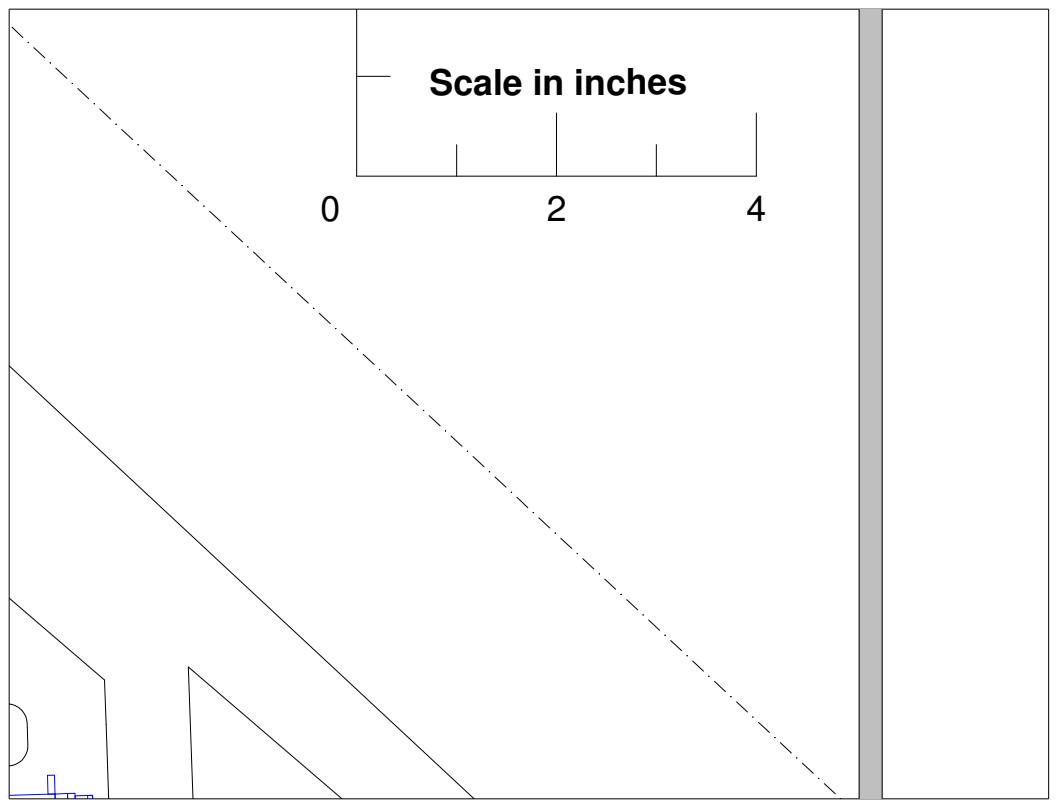
[picture p86: page 6]

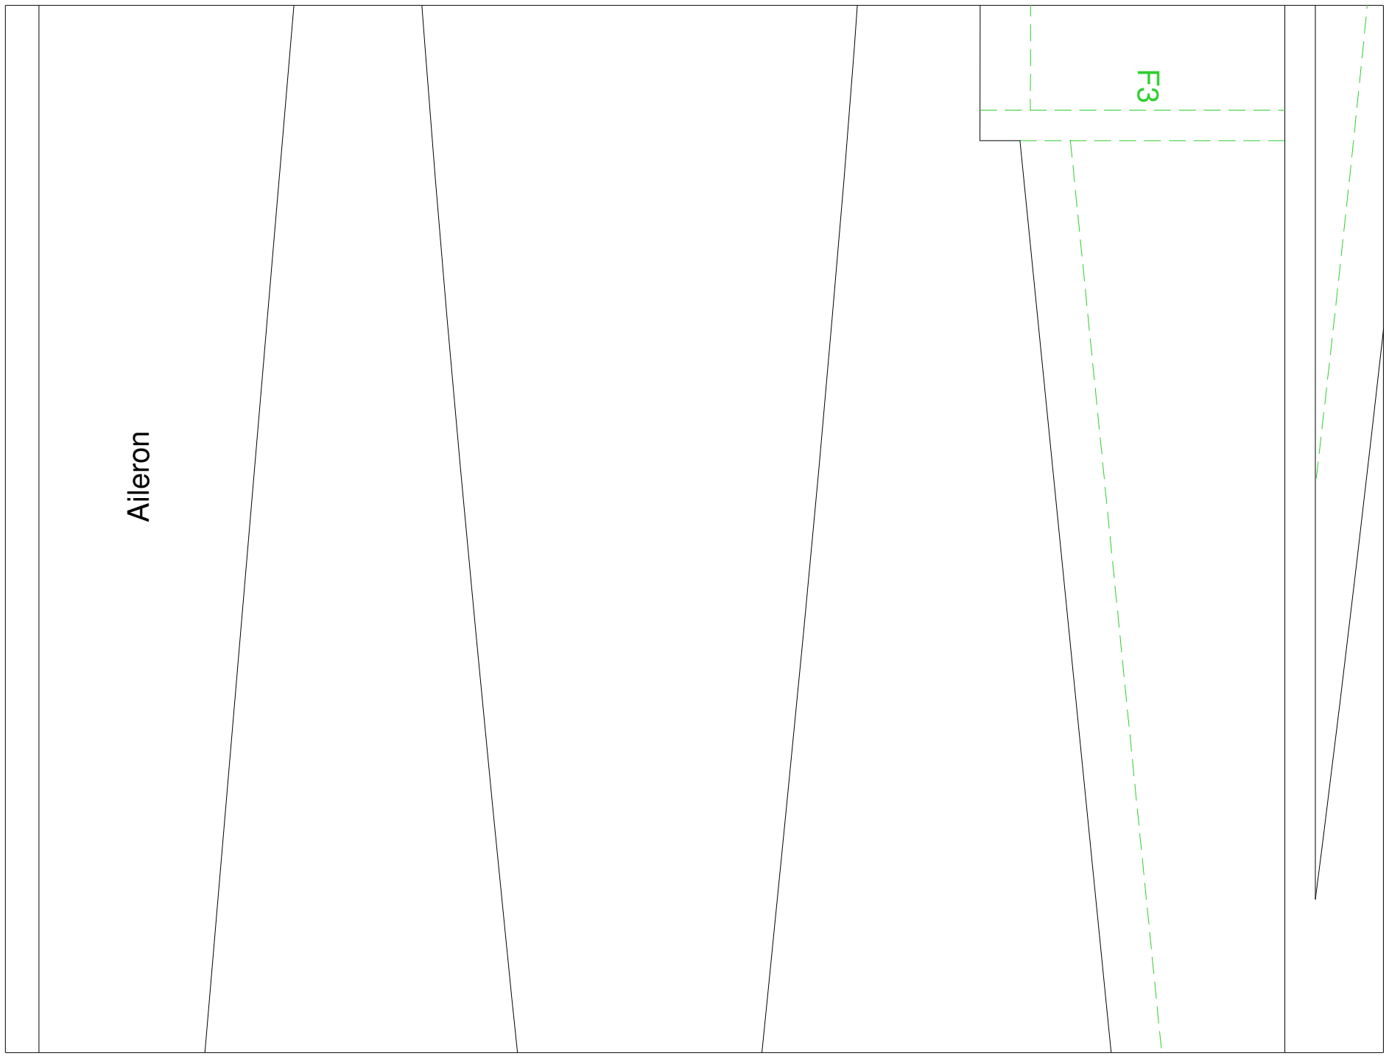
[picture p87: figure]
Aileron
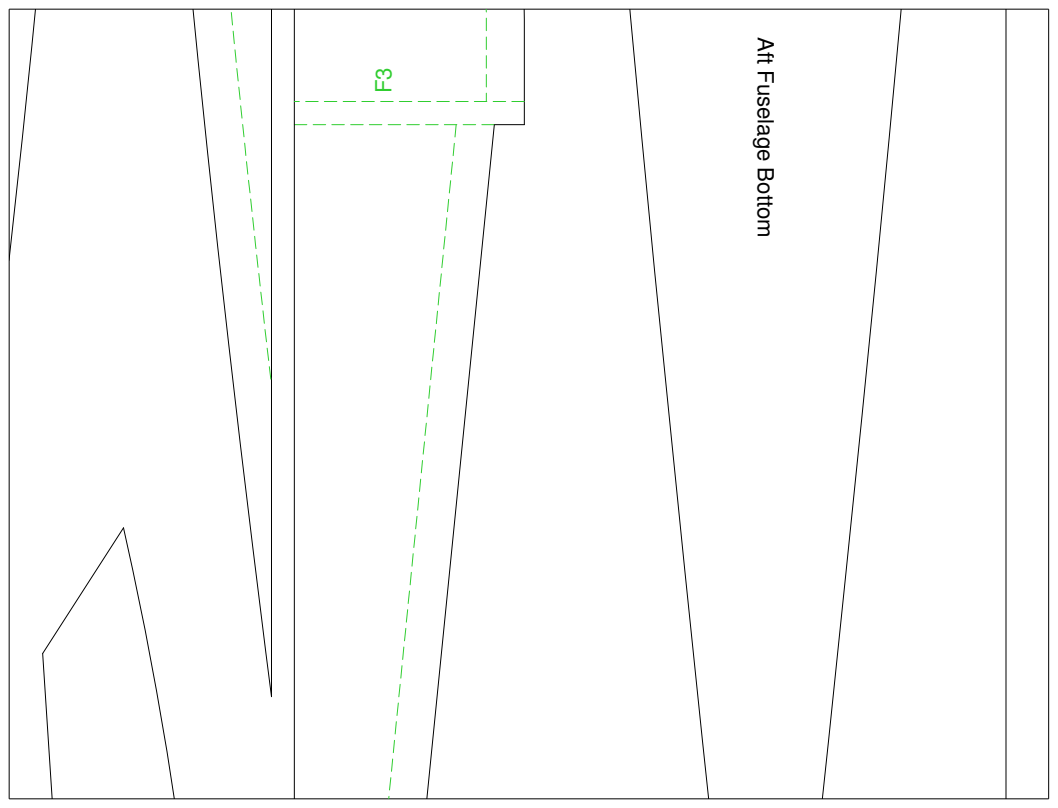
[picture p88: page 8]

Aft Fuselage Bottom

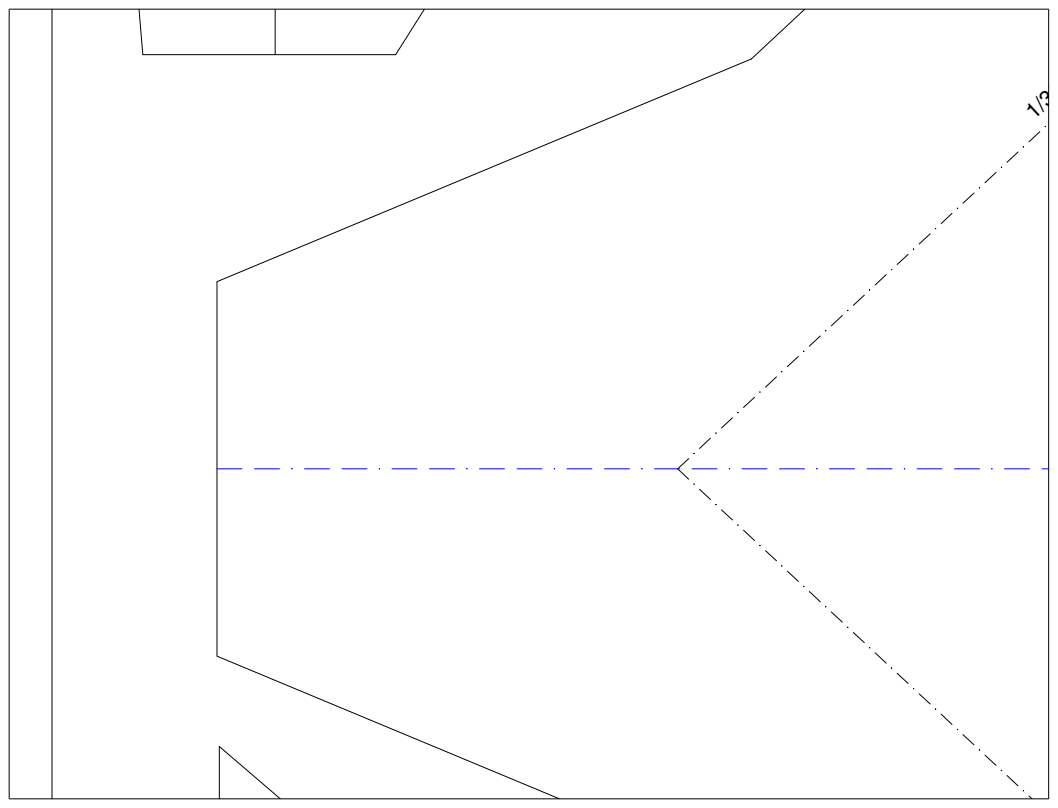
[picture p89: page 9]

## Wing

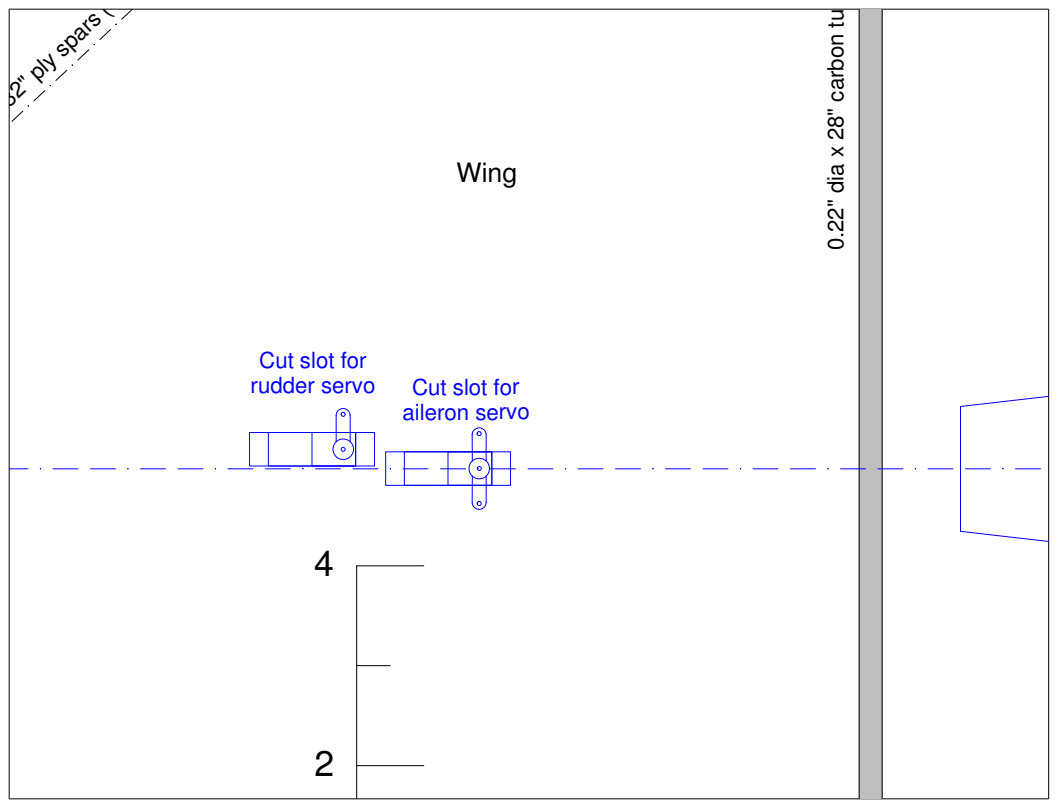
[picture p90: page 10]
1/32" ply spars (; dia

Cut slot for
rudder servo

aileron servo

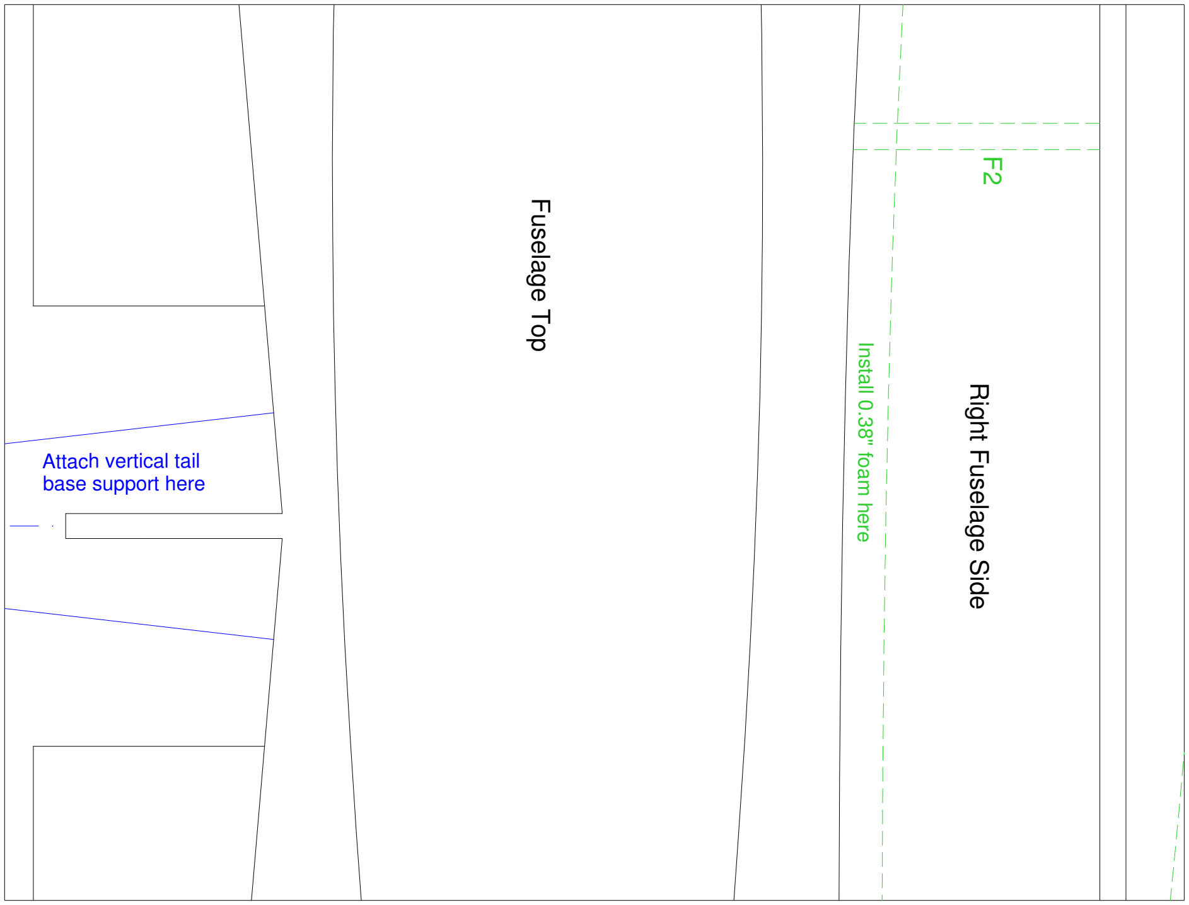
[picture p91: figure]
Right Fuselage Side; Fuselage Top; Atta; ertic; al tail b a; ort h; ere; Install 0.38" foam here
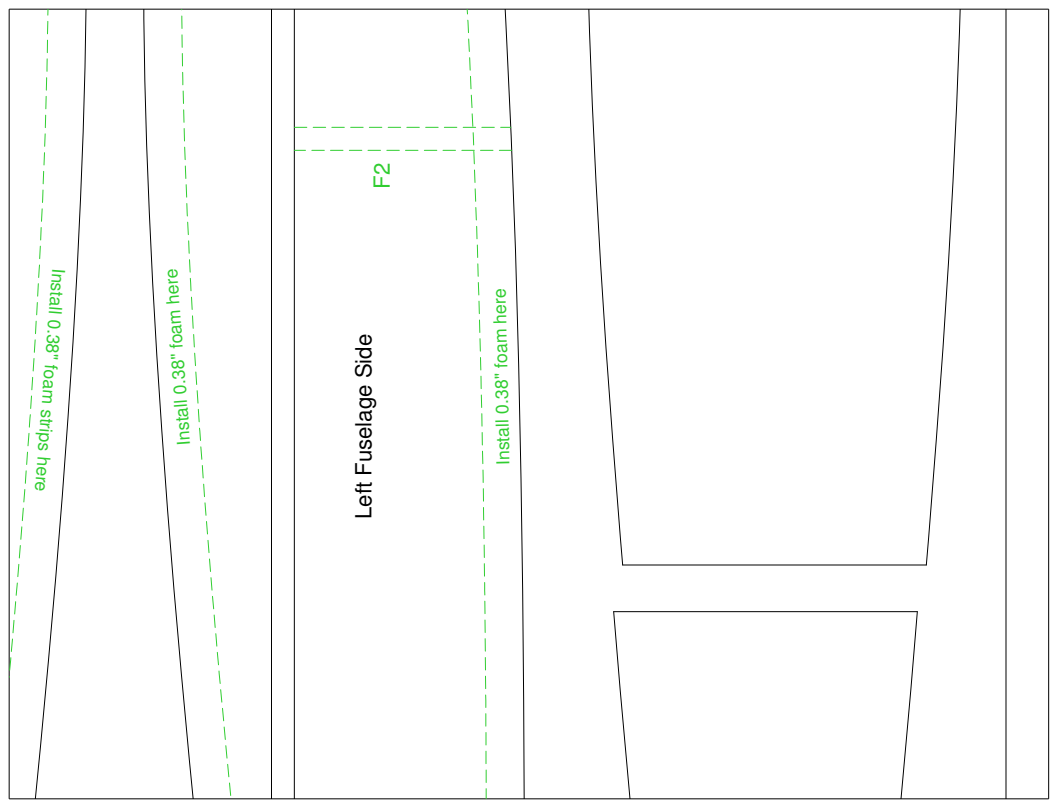
[picture p92: page 12]

Install 0.38" foam str pi s here

Ins at ll 0.38" of am here

Install 0.38" of am here

Left Fuselage Side

### Horizontal tail

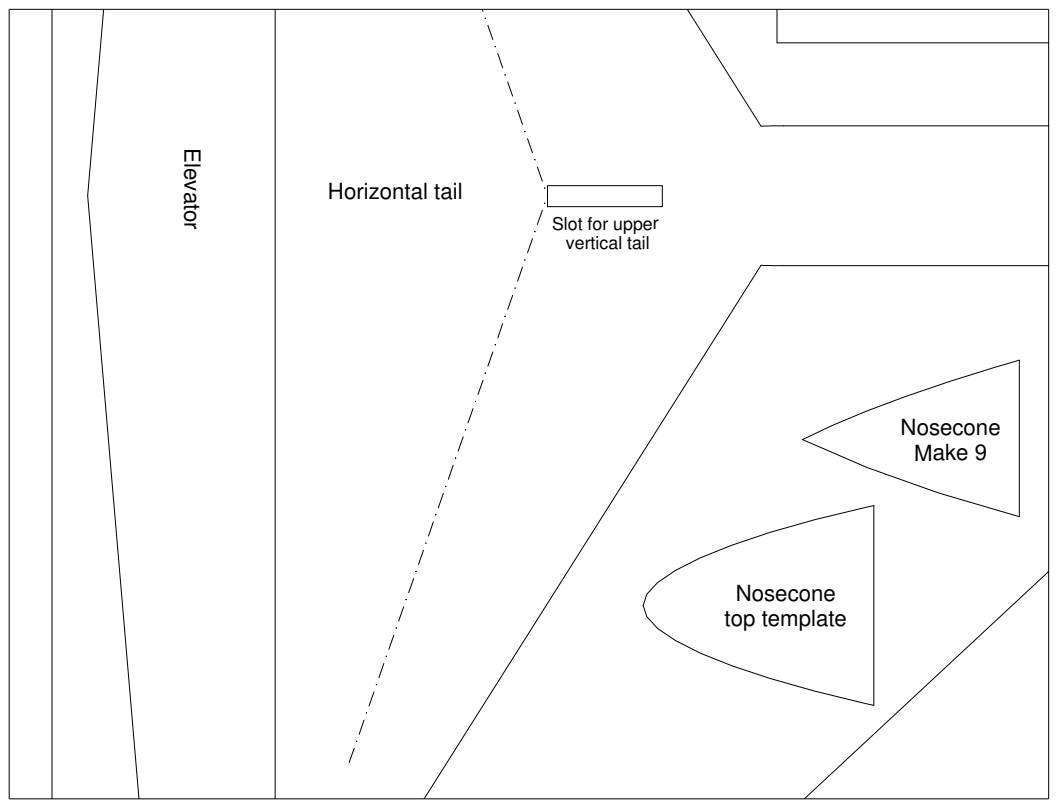
[picture p93: page 13]
Nosecone Make 9; Ele; Nosecone top template

Slot for upper
vertical tail

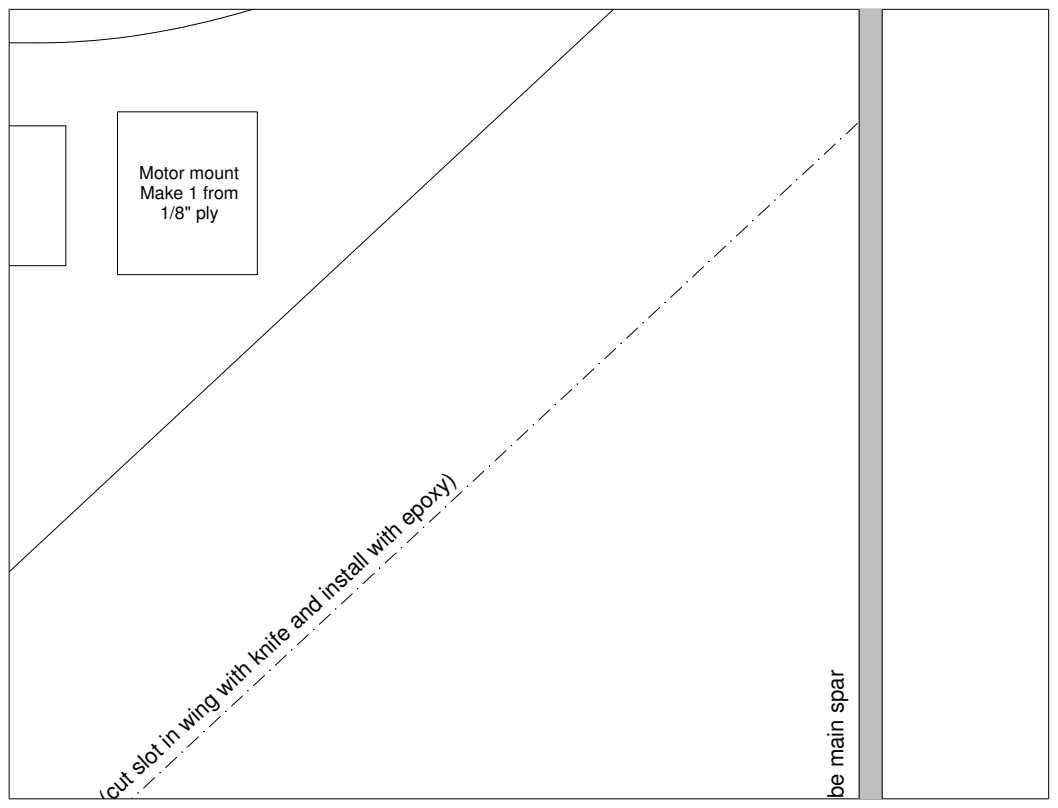
[picture p94: page 14]
otor m; e 1 fro; m 1/8" ply

(cut slot in wing with knife and install with epoxy)

be main spar

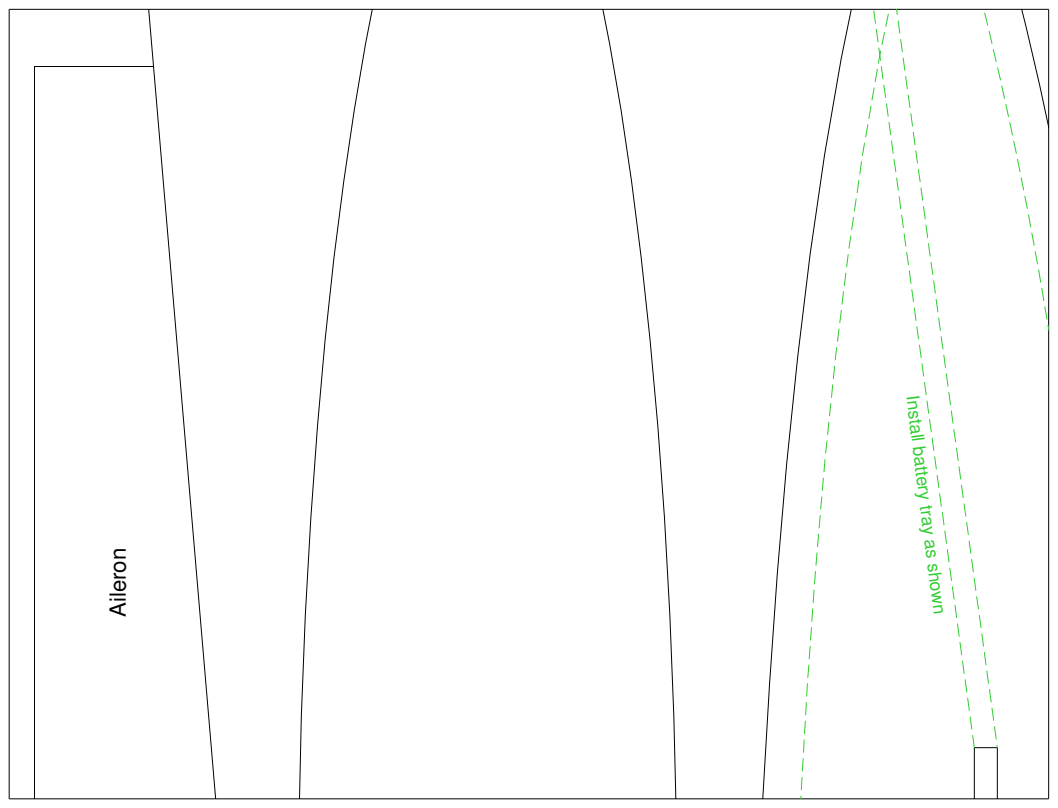
[picture p95: page 15]
Aileron

Install battery tray as shown

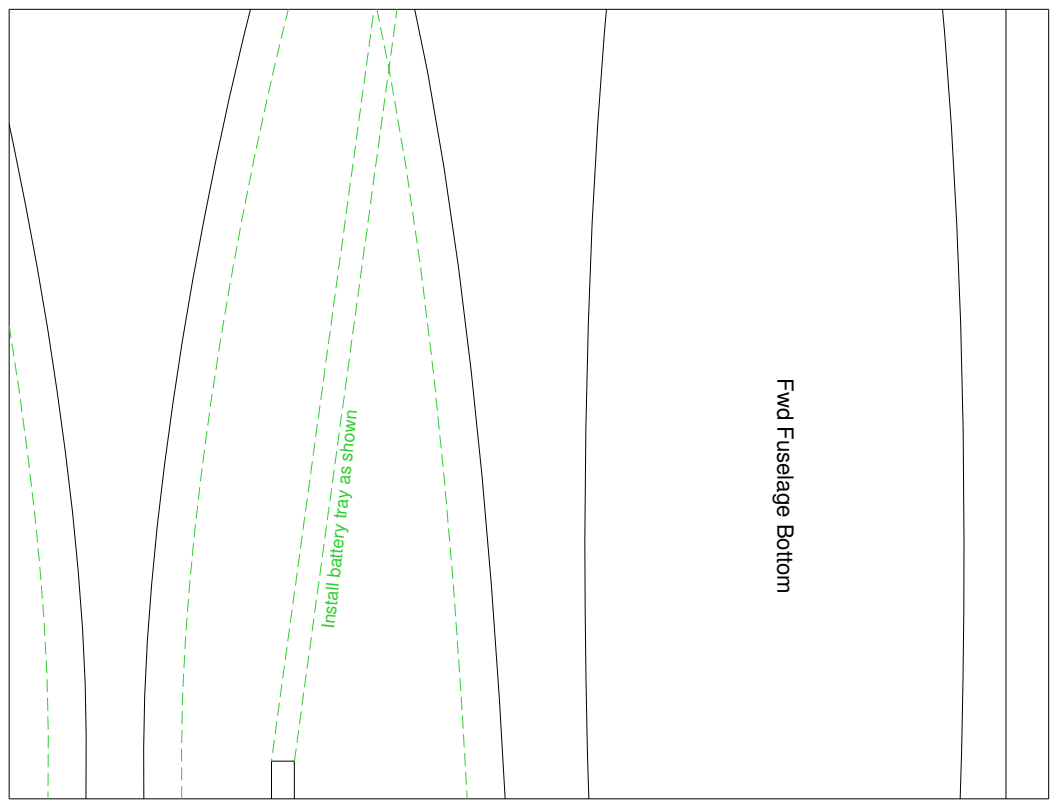
[picture p96: page 16]

Fwd Fuselage Bottom

Install battery tray as shown

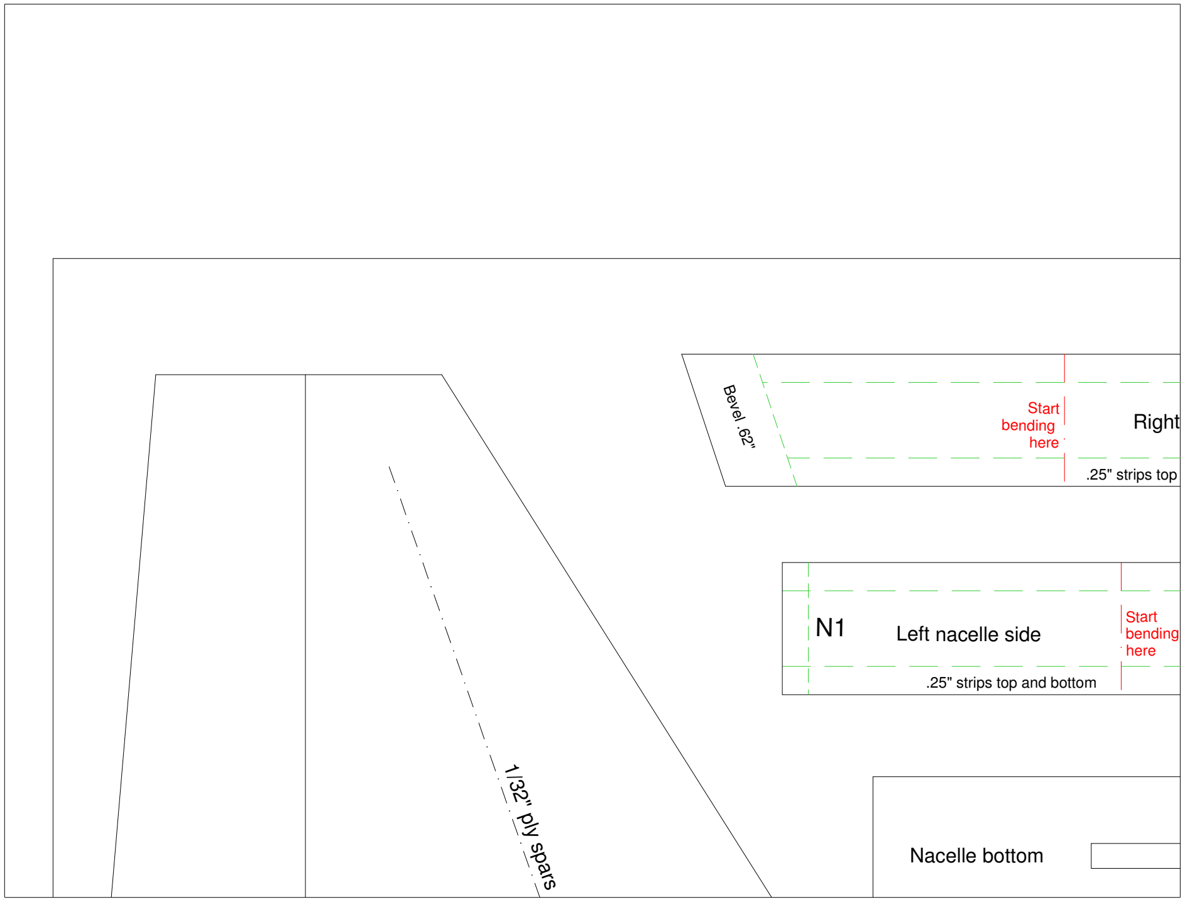
[picture p97: figure]
Start b ending here .2; 5" strips top and botto m; Rig; elle; otto; Start b ending here; Bevel .62"; L eft n a; c elle; sid e; 1/32" ply spars; 5" strips top
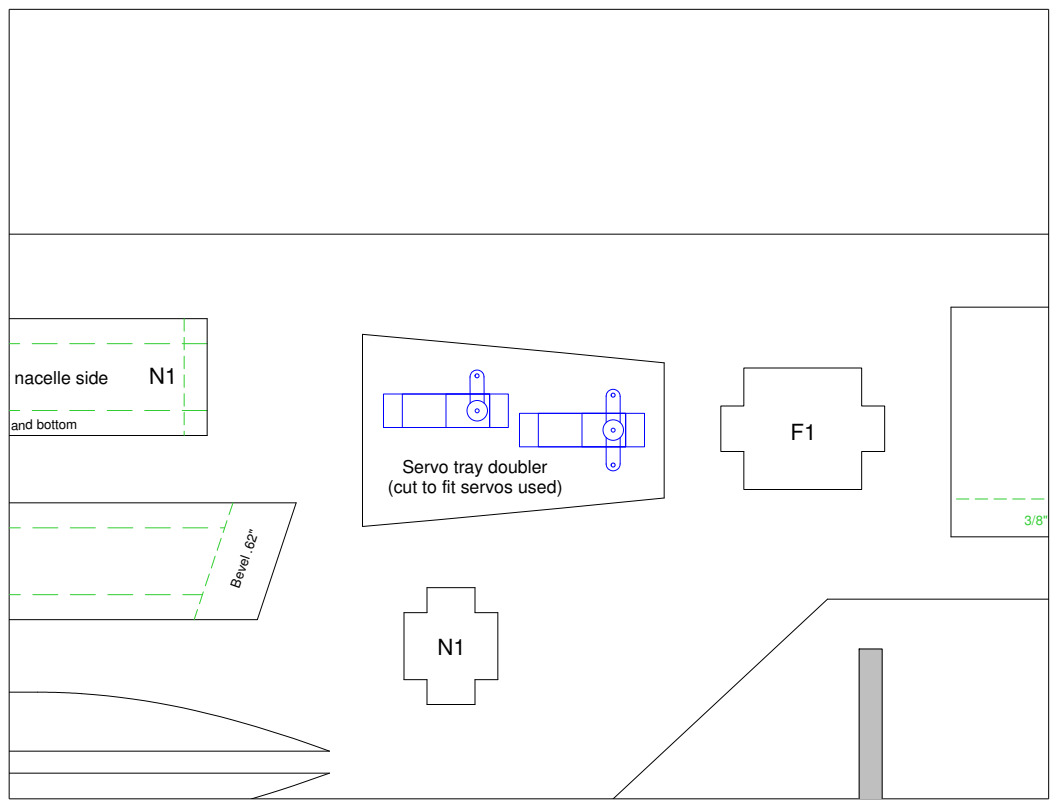
[picture p98: page 18]
Rig; elle; sid; Bevel .62"; erv; o tra; bler (c ut to fit s

s top and botto

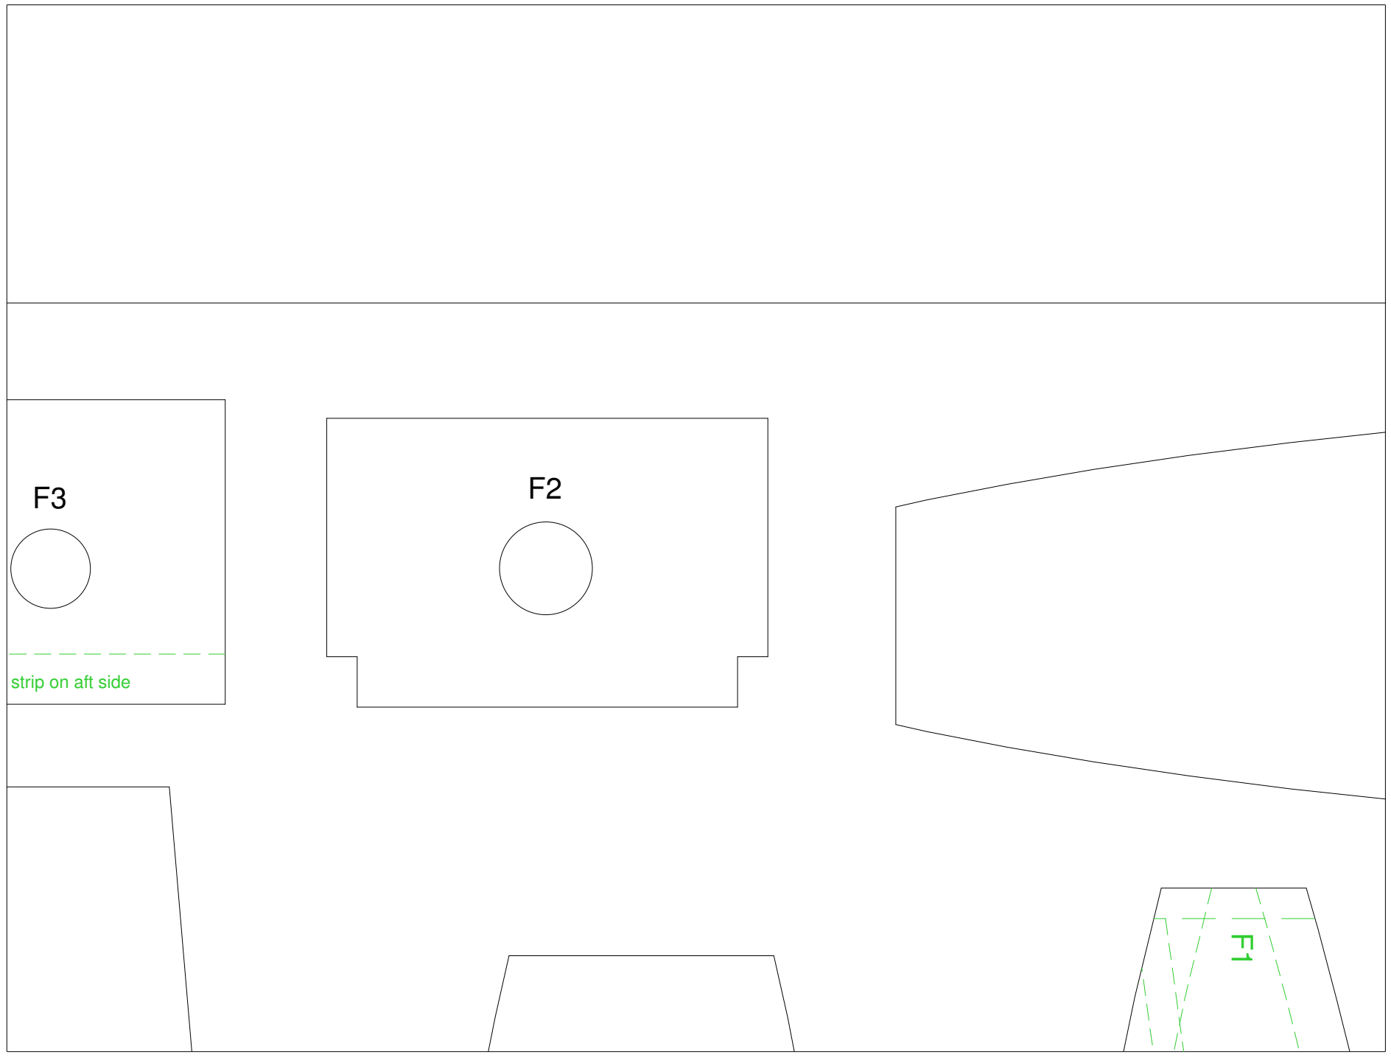
[picture p99: figure]
3/8" strip on aft side

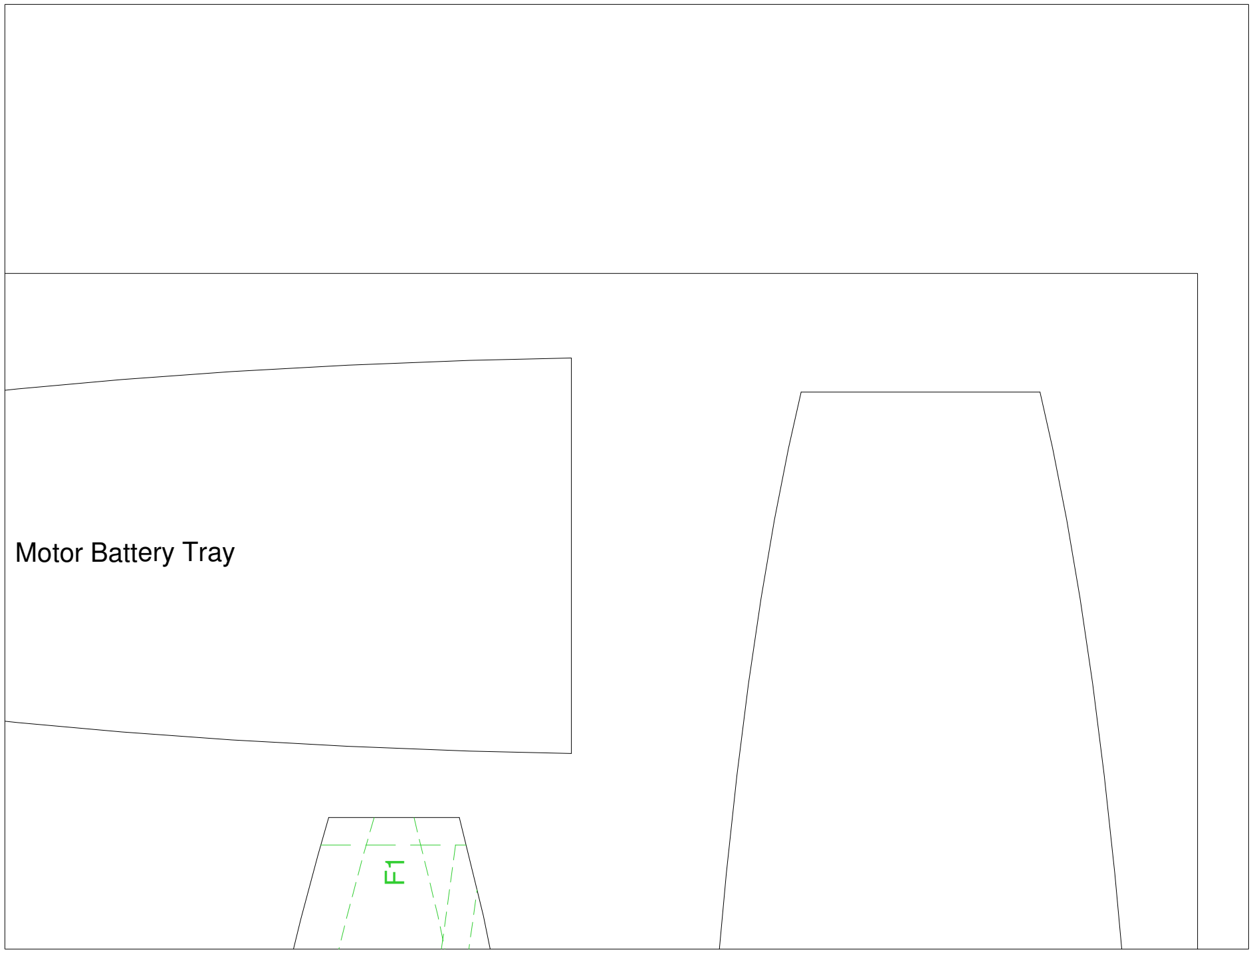
[picture p100: figure]
Motor Battery Tray
